jimzord12/ai-fire-detection-arduino-system/thesis/FUTURE_PLANS_IDEAS.md

For Future PLans:

- Make the current system more robust by allowing it to work even when a sensor fails (e.g., if the flame sensor is blocked or malfunctions, the system should still be able to detect fire using smoke and temperature data).
- Integrate additional sensors, such as a moving camera.
- Attach it to a Drone for aerial fire detection in forests.
- Describe more known Neron netowrk architectures and compare their performance on this task.
