jimzord12/ai-fire-detection-arduino-system/thesis/typst/assets/figures/IMAGE_DESCRIPTIONS.md

# Thesis Figure Inventory & Descriptions

This document identifies and describes all the figure assets for the AI Fire Detection Thesis.

## 1. Data Analysis Figures (`/data_analysis`)

| Figure Filename | Illustration Purpose | Recommended Figure Description | Recommended Placement |
| :--- | :--- | :--- | :--- |
| `class_distribution.png` | Shows the balance of the dataset collected for training. | **Figure X: Dataset Class Distribution.** A bar chart representing the number of samples for each of the three target classes: `fire`, `no_fire`, and `false_alarm`. The distribution confirms a well-balanced dataset, preventing model bias. | Chapter 8, Section 8.2 (Dataset Summary) |
| `sensor_correlation.png` | Illustrates the linear relationships between different sensors. | **Figure X: Sensor Correlation Matrix.** A heatmap showing the Pearson correlation coefficients between the six sensors. Low correlation between certain sensors (e.g., CO and Humidity) indicates they provide unique, non-redundant information for the fusion model. | Chapter 3, Section 3.4 (Feature Engineering) |
| `sensor_boxplots.png` | Visualizes the range and signature of each sensor across the three classes. | **Figure X: Sensor Signature Analysis by Class.** Boxplots showing the median, quartiles, and outliers for each sensor across the three classes. This highlights the distinct chemical and thermal signatures of each scenario, such as higher VOC/Smoke in false alarms versus higher CO in real fires. | Chapter 8, Section 8.4 (Ablation Study) |
| `confusion_matrix.png` | Shows the classification performance of the model on the test set. | **Figure X: Model Confusion Matrix.** A matrix visualizing the predicted vs. actual class labels. The 100% accuracy in this controlled environment demonstrates the mathematical separability of the fire and false alarm classes. | Chapter 8, Section 8.3 (Training and Validation Metrics) |
| `feature_importance.png` | Ranks the contribution of each sensor to the final ML decision. | **Figure X: Feature Importance Ranking.** A bar chart showing the relative importance of each sensor in the classification process. Smoke and VOC are identified as the most significant contributors (~50% combined), while Humidity provides the least unique information. | Chapter 8, Section 8.4 (Ablation Study) |

## 2. Edge Impulse Platform Figures (`/edge-impulse`)

| Figure Filename | Illustration Purpose | Recommended Figure Description | Recommended Placement |
| :--- | :--- | :--- | :--- |
| `001-platform-data-acquisition.png` | Shows the data ingestion interface for raw sensor logs. | **Figure X: Edge Impulse Data Acquisition Interface.** A screenshot of the platform's data ingestion page, showing the raw time-series data from the multi-sensor array after being uploaded from the Arduino. | Chapter 7, Section 7.1 (Edge Impulse Project Setup) |
| `002-platform-create-impulse.png` | Illustrates the TinyML pipeline (DSP + Learning blocks). | **Figure X: Impulse Design Architecture.** The Edge Impulse "Create Impulse" screen, showing the configuration of the time-series data block, the Spectral Analysis DSP block, and the Neural Network Classifier. | Chapter 7, Section 7.2 (Impulse Design and DSP Blocks) |
| `003-platfotm-spectral-features-error.png` | Documents troubleshooting during the DSP configuration phase. | **Figure X: Spectral Feature Configuration Error.** A screenshot illustrating common errors during DSP block setup, used to discuss the importance of correct window size and FFT parameters for sensor fusion. | Chapter 7, Section 7.2 (Impulse Design and DSP Blocks) |
| `004-platfotm-spectral-features.png` | Shows the successful configuration of the Spectral Analysis block. | **Figure X: Spectral Analysis DSP Configuration.** The final settings for the spectral features, including window length and frequency-domain processing used to extract fire-relevant signatures. | Chapter 7, Section 7.2 (Impulse Design and DSP Blocks) |
| `005-platform-feature-explorer.png` | Visualizes the clustering of features in a 3D explorer. | **Figure X: 3D Feature Explorer Visualization.** A plot showing how the three classes (fire, no_fire, false_alarm) cluster in the high-dimensional feature space, providing a visual proof of class separability. | Chapter 7, Section 7.2 (Impulse Design and DSP Blocks) |
| `006-platform-classifier.png` | Shows the Neural Network training parameters and architecture. | **Figure X: Classifier Training Configuration.** The training interface in Edge Impulse, detailing the neural network topology, learning rate, and training cycles (epochs) used for the fire detection model. | Chapter 7, Section 7.3 (Model Architecture and Training) |
| `007-platform-model-testing.png` | Illustrates the validation of the model on unseen test data. | **Figure X: Live Model Testing and Validation.** A screenshot of the model testing results within the Edge Impulse platform, showing the classification accuracy on the hold-out test dataset. | Chapter 7, Section 7.3 (Model Architecture and Training) |
| `008-platform-deployment-success-msg.png`  | Confirms the successful compilation of the C++ library. | **Figure X: Model Compilation and Build Success.** The notification screen confirming the successful generation of the optimized C++ library for deployment on the Arduino UNO R4. | Chapter 7, Section 7.7 (Quantization Strategy) |
| `009-platform-deployment.png` | Shows the deployment options for the Arduino UNO R4. | **Figure X: Deployment Target Selection.** The deployment page showing the various export options, specifically the selection of the Arduino library for integration into the custom firmware. | Chapter 7, Section 7.4 (Arduino Firmware Development) |

## 3. Data Collection Evidence (`/data-collection-evidence`)

| Figure Filename | Illustration Purpose | Recommended Figure Description | Recommended Placement |
| :--- | :--- | :--- | :--- |
| `002-flame-source-only-indoors.jpg` | Shows the sensor node capturing indoor flame data.  | **Figure X: Indoor Flame Data Collection.** The sensor node capturing infrared signatures from a cluster of candles, representing the "Fire" class baseline. | Chapter 6, Section 6.4 (Fire Class) |
| `003-flame-smoke-indoors.jpg` | Captures the combination of flame and smoke. | **Figure X: Combined Flame and Smoke Capture.** The sensor node capturing data from both candles and a smoldering incense bowl, illustrating a complex fire scenario. | Chapter 6, Section 6.4 (Fire Class) |
| `004-flame-smoke-outdoors.jpg` | Documents environmental variance during collection. | **Figure X: Outdoor Night Data Collection.** The sensor node capturing fire signatures in an outdoor environment to account for ambient noise and variance. | Chapter 6, Section 6.5 (Environmental Variance) |
| `005-smoke-only-indoors.jpg` | Represents smoldering/non-flaming fire data. | **Figure X: Smoldering Fire Simulation.** The sensor node capturing particulate and VOC signatures from a smoldering source without visible flame (Scenario A3). | Chapter 6, Section 6.4 (Fire Class) |
| `006-cooking-using-pan-indoors.jpg` | Documents the "False Alarm" class (Cooking). | **Figure X: Cooking Fume False Alarm Scenario.** The sensor node capturing signatures from a frying pan, documenting the high VOC/Smoke but low CO profile (Scenario C1). | Chapter 6, Section 6.4 (False-Alarm Class) |
| `007-boiling-water-indoors-pt1.jpg` | Documents the "False Alarm" class (Steam). | **Figure X: Steam and Humidity False Alarm Capture.** The sensor node positioned over boiling water to capture high humidity spikes without combustion products (Scenario C2). | Chapter 6, Section 6.4 (False-Alarm Class) |
| `008-boiling-water-indoors-pt2.jpg` | Shows an alternative sensor placement for steam. | **Figure X: Ambient Steam Collection.** The sensor node positioned in a kitchen setting during water boiling to capture dispersed steam signatures. | Chapter 6, Section 6.4 (False-Alarm Class) |
