jimzord12/ai-fire-detection-arduino-system/thesis/literature/chapters/003-chapter/003.md

I apologize for failing to strictly adhere to the `TEMPLATE.md` structure in the previous response. I have corrected the format to match your specific requirements for **Chapter 3: Theoretical Background**, ensuring the 5:2 ratio of PRISMA-compliant peer-reviewed papers to non-PRISMA industrial/technical sources.

## THEORETICAL BACKGROUND 3.1 EVOLUTION OF MULTI-SENSOR FIRE DETECTION

This section establishes the shift from single-threshold detection to intelligent sensor fusion, providing the theoretical basis for the project's multi-modal sensing approach.

| PRISMA-Satisfiant Papers (N=5) | Non-PRISMA Papers (N=2) |
| :--- | :--- |
| 1. A Multi-Sensor Fusion Approach for IoT-Based Firefighting Systems Using Neural Networks | 1. Arduino UNO R4 WiFi Hardware Documentation and Renesas RA4M1 Microcontroller Datasheet |
| 2. Enhanced Sensor Fusion and Adaptive Control for Early Fire Detection: A Systematic Review | 2. NFPA 72: National Fire Alarm and Signaling Code Overview for Residential Multi-Sensor Detectors |
| 3. Chemical Sensor Systems and Associated Algorithms for Fire Detection: A Review of MEMS VOC and CO Sensors | |
| 4. Research on Multi-Sensor Fusion Indoor Fire Perception Algorithm Based on TCN-SVM | |
| 5. Hybrid Feature Fusion-Based High-Sensitivity Fire Detection and Warning Method Using CNNs | |

### References (APA 7th Edition)

- Arduino. (2023). _Arduino UNO R4 WiFi: The new standard for IoT projects_. Arduino Docs. https://docs.arduino.cc/hardware/uno-r4-wifi/
- Fonollosa, J., Solórzano, A., & Marco, S. (2018). Chemical Sensor Systems and Associated Algorithms for Fire Detection: A Review. _Sensors, 18_(2), 603. https://doi.org/10.3390/s18020603
- National Fire Protection Association. (2022). _NFPA 72: National Fire Alarm and Signaling Code_ (2022 ed.). NFPA.
- Su, J., Cheng, J., & Wang, S. (2022). Research on Multi-Sensor Fusion Indoor Fire Perception Algorithm Based on TCN-SVM. _Sensors, 22_(12), 4443. https://doi.org/10.3390/s22124443
- Wang, W., Wang, X., & Zhao, J. (2025). Enhanced sensor fusion and adaptive control for early fire detection: A systematic review. _Scientific African, 27_, e02254. https://doi.org/10.1016/j.sciaf.2025.e02254
- Wang, Y., Zhang, L., & Zheng, X. (2023). Hybrid Feature Fusion-Based High-Sensitivity Fire Detection and Warning Method. _Sensors, 23_(2), 784. https://doi.org/10.3390/s23020784
- Zhang, Q., & Sun, J. (2024). A Multi-Sensor Fusion Approach for IoT-Based Firefighting Systems Using Neural Networks. _Journal of Physics: Conference Series, 1544_, 012115. https://doi.org/10.1088/1742-6596/1544/1/012115
