jimzord12/ai-fire-detection-arduino-system/thesis/typst/chapters/04_introduction/sections/4_2_objectives/glossary.md

**Asymmetric Multi-Processing**: A hardware architecture where different processor cores handle distinct tasks, such as separating high-speed inference from low-priority communication tasks.
**Autonomous Sensing Node**: A standalone edge device that performs data acquisition, processing, and decision-making locally without requiring a continuous cloud connection.
**Inference Latency**: The total time elapsed between the presentation of input data to a machine learning model and the generation of a classification result.
**TinyML**: A branch of machine learning dedicated to the design and deployment of optimized models on ultra-low-power microcontrollers.
