jimzord12/ai-fire-detection-arduino-system/thesis/typst/chapters/05_project_scope/sections/5_2_problem_statement/glossary.md

**Edge AI**: The practice of processing artificial intelligence algorithms locally on a hardware device, rather than on a remote cloud server.
**MEMS (Micro-Electro-Mechanical Systems)**: Technology of very small devices, often used for high-sensitivity gas and pressure sensors on a single chip.
**TinyML**: A field of machine learning focused on developing models that can run on low-power, resource-constrained microcontrollers.
**Sensor Fusion**: The process of combining data from multiple sensors to produce information that is more accurate or complete than that provided by individual sources.
