jimzord12/ai-fire-detection-arduino-system/thesis/typst/chapters/05_project_scope/sections/5_3_research_questions/glossary.md

**Inference Latency**: The time required for a deployed machine learning model to process an input and generate a classification output on the edge device.
**Quantization**: A model optimization technique that converts high-precision weights (e.g., 32-bit float) to lower-precision formats (e.g., 8-bit integer) to reduce memory usage and increase inference speed.
**Three-Class Classification**: A supervised learning approach that categorizes data into three distinct labels—in this context, identifying fire, normal background, or non-fire nuisance events.
**TinyML**: A field of machine learning focused on deploying optimized models on low-power, resource-constrained microcontrollers at the hardware edge.
