jimzord12/ai-fire-detection-arduino-system/thesis/typst/chapters/08_conclusions_future_work/sections/8_2_discussion/sections/9_1_interpretation_of_class_separability/content_no_glossary_ieee.md

# Interpretation of Class Separability

## 9.1.1 The "Truth Sensor" and "Thermal Anomaly" Analysis

The core of class separability within this multi-sensor system is illuminated by two critical observations from the data analysis: the identification of a "CO Truth Sensor" and the "Heat Paradox" or "Thermal Anomaly." These findings collectively explain why the fusion model achieves perfect classification on the validation dataset.

### The CO "Truth Sensor" for Combustion Verification

*   **Distinct Signatures**: While `smoke` and `voc` sensors exhibit elevated readings for both "fire" and "false_alarm" conditions (e.g., from cooking fumes or aerosol sprays), the CO sensor shows a profound divergence. "Fire" events average approximately 494 units of CO, whereas "false_alarm" events average a significantly lower ~123 units (from `analysis_results.json`, `sensor_stats`).
*   **Fundamental Differentiator**: This stark difference in CO levels is attributed to its nature as a product of incomplete combustion. False alarms, such as cooking or spraying aerosols, may produce particulates (smoke) and volatile organic compounds (VOCs), but they do not typically generate significant quantities of CO. Conversely, any genuine fire, whether flaming or smoldering, will produce CO.
*   **Class Separability**: This distinct characteristic of the CO sensor provides a robust mechanism for the machine learning model to separate "fire" from "false_alarm" classes, even when other sensor modalities show overlapping ranges. If a high smoke or VOC reading is observed in conjunction with low CO, the system can confidently infer a false alarm, contributing significantly to the model's high precision and recall for the "false_alarm" class.

### The "Heat Paradox" and the Limits of Thermal-Only Detection

*   **Counterintuitive Finding**: Counterintuitively, the average temperature recorded during "false_alarm" scenarios (specifically cooking and steam) was higher (34.9°C) than during active "fire" events (25.7°C) in the early stages of data collection.
*   **Implications for Single-Sensor Systems**: This finding has profound implications for systems relying solely on thermal detection. A simple heat detector, set to a threshold based on fire temperatures, would be highly susceptible to false alarms from cooking or steam. Conversely, setting the threshold too high to avoid these false alarms would delay the detection of actual fires, especially in their incipient stages.
*   **Validation of Fusion**: The "Heat Paradox" underscores why multi-sensor fusion is critical. By combining temperature data with the outputs of other sensors, the system can contextualize the thermal anomaly. A high temperature reading, when accompanied by low CO levels and the absence of a strong flame signal, is correctly interpreted as a false alarm. This prevents misclassifications that would be inevitable with a thermal-only detection approach, demonstrating the power of a holistic sensor perspective for accurate class separability.

The combined evidence from the CO "Truth Sensor" and the "Heat Paradox" demonstrates that while individual sensors can be misleading, their intelligent fusion provides a rich and separable feature space, allowing the TinyML model to achieve highly accurate and reliable distinction between fire, no-fire, and false alarm events.

### References
