jimzord12/ai-fire-detection-arduino-system/thesis/typst/chapters/08_conclusions_future_work/sections/8_2_discussion/sections/9_2_strengths_of_the_autonomous_node_approach/content_no_glossary_ieee.md

# Strengths of the "Autonomous Node" Approach

The design and implementation of the AI Fire Detection Arduino System as an "Autonomous Sensing Node" represents a significant departure from traditional centralized or less intelligent detection paradigms. This approach embodies several key strengths that contribute to its enhanced reliability, efficiency, and suitability for modern safety applications. These strengths are derived from the system's architecture, its intelligent edge processing capabilities, and its integrated operational logic, drawing upon various aspects of the project's design and codebase features.

## 9.2.1 Edge Intelligence and Responsiveness

One of the foremost strengths of the autonomous node approach is its commitment to **edge intelligence**. By deploying the TinyML model directly onto the Arduino UNO R4 WiFi (Renesas RA4M1 microcontroller), the system performs real-time inference at the source of data generation. This eliminates the latency associated with sending raw sensor data to a cloud server for processing, ensuring a rapid response to potential fire events. The system's ability to operate independently, making immediate decisions on-device, is critical for life-critical applications where every millisecond counts (On-Device Performance Metrics, Section 8.6). This architecture minimizes network dependency, enhancing system resilience even during connectivity disruptions.

## 9.2.2 Robust False Alarm Mitigation

The core innovation of this project, the **three-class classification** (fire/no_fire/false_alarm), is a direct strength of the autonomous node approach. Unlike binary systems, the node explicitly learns and differentiates the unique multi-sensor signatures of common nuisance events (e.g., cooking fumes, steam, aerosol sprays) from both true fires and ambient conditions. This significantly reduces false positives, a perennial problem in fire detection that leads to complacency and economic losses (False Alarm Mitigation and Research Synthesis, Section 2.4). The integration of ML probabilities with **heuristic post-processing and hybrid triggering logic** (Heuristic Post-Processing and Hybrid Triggering Logic, Section 7.5), which includes physical confirmation from raw sensors and temporal debouncing, further fortifies the system against transient false alarms, building trust and reliability.

## 9.2.3 Multi-Sensor Fusion for Enhanced Accuracy

The autonomous node integrates data from five distinct sensor modalities (Smoke, VOC, CO, Flame, Temperature/Humidity). This **multi-sensor fusion** provides a comprehensive understanding of the environment, overcoming the inherent ambiguities of single-sensor approaches. As demonstrated by the ablation study (Ablation Study, Section 8.4), individual sensors can be misleading (e.g., the "Heat Paradox" where false alarms are hotter than early fires). However, the fused data allows the TinyML model to identify subtle yet critical patterns, such as the "CO Truth Sensor" for combustion verification, leading to 100% classification accuracy on the validation set. This synergy ensures a more accurate and reliable detection capability.

## 9.2.4 Scalability and Deployability

The self-contained nature of each autonomous node makes the system inherently **scalable**. Each unit operates independently, requiring minimal external infrastructure beyond power and optional network connectivity (e.g., via MQTT for telemetry). This modularity allows for flexible deployment in various environments—from individual rooms to large industrial complexes—by simply adding more nodes. The use of low-cost, off-the-shelf components like the Arduino UNO R4 WiFi and DFRobot sensors contributes to its cost-effectiveness, making widespread deployment feasible. The ESP32-S3 co-processor further enables seamless **MQTT telemetry** (Connectivity and Location Awareness, Section 5.4) for centralized monitoring without compromising local decision-making autonomy.

## 9.2.5 Operational Robustness and Self-Awareness

The firmware incorporates **system diagnostics** (Arduino Firmware Development, Section 7.4), allowing the node to perform self-tests upon startup to verify the operational status of all connected sensors. In the event of a sensor fault, the system can enter a fault state and signal a visual alarm pattern, ensuring that operational integrity is maintained or clearly communicated. This self-awareness contributes significantly to the system's overall robustness, providing confidence in its operational status and reducing maintenance overhead.

### References
