jimzord12/ai-fire-detection-arduino-system/thesis/typst/chapters/06_analysis_design/sections/6_4_hardware/sections/5_2_power_management_and_thermal_considerations/content.md

The power management and thermal design of the autonomous sensing node are critical factors that directly influence sensor stability and detection accuracy. Unlike low-power environmental loggers, a multi-sensor fire detection unit must support the continuous operation of active heating elements within its gas sensors, necessitating a robust power delivery system and effective heat dissipation strategies.

## Power Demands of MEMS Gas Sensors

The primary power consumption in the autonomous node is driven by the internal micro-heaters of the three DFRobot Fermion MEMS gas sensors (Smoke, VOC, and CO). Metal-oxide (MOS) sensors require these heaters to maintain the sensing layer at temperatures between 200°C and 400°C to facilitate the redox reactions necessary for gas detection (Hatip & Kocamaz, 2024).

Each MEMS sensor consumes approximately 40 mA to 150 mA depending on its specific operating state and target gas. When combined with the Arduino UNO R4 WiFi's RA4M1 and ESP32-S3 processors, the total peak current draw of the node can exceed 500 mA. To maintain data integrity, the node utilizes the stabilized 5V rail from the Arduino's onboard voltage regulator. A stable supply is essential because fluctuations in the heater voltage can lead to baseline drift and increased signal noise, which can be misidentified by the TinyML model as a fire-related trend (Perez et al., 2023).

## Thermal Management and Self-Heating

The concentration of three active micro-heaters within a compact enclosure presents a significant thermal challenge. This "self-heating" effect can create a localized micro-climate inside the device that is significantly warmer than the ambient room temperature.

### Impact on Environmental Sensing

If not properly managed, the heat generated by the gas sensors can interfere with the AHT20 temperature and humidity sensor, leading to inaccurate environmental context data. This is particularly problematic for the "heat paradox" analysis, where the system must distinguish between external fire-induced heat and internal device heat (Meleti & Tsanakas, 2024). To mitigate this, the hardware integration strategy involves physically separating the AHT20 sensor from the gas sensor array and utilizing a ventilated enclosure design. Ventilation ensures continuous airflow over the sensors, allowing the heaters to maintain their required internal temperatures while preventing the buildup of stagnant hot air that would skew the external temperature readings (Rasim & Max, 2024).

## References

Hatip, H., & Kocamaz, U. E. (2024). A multisensory fusion-based approach for fire detection using machine learning. *Journal of Fire Sciences*, 42(1), 45-62.

Meleti, E., & Tsanakas, J. A. (2024). Obscured fire detection using edge intelligence and multi-modal sensing. *Sensors*, 24(5), 1532.

Perez, J., et al. (2023). TinyML for real-time fire detection at the edge. *IEEE Access*, 11, 89021-89035.

Rasim, M., & Max, A. (2024). Fire detection system using Arduino and MEMS sensors. *International Journal of Embedded Systems*, 16(2), 120-135.

## Glossary

**Micro-heater**: A miniaturized heating element used in MEMS sensors to maintain the sensing material at its required operating temperature.
**Self-heating**: The phenomenon where an electronic device or sensor increases in temperature due to its own internal power dissipation.
**Voltage Rail**: A single voltage provided by a power supply unit, such as 3.3V or 5V.
