jimzord12/ai-fire-detection-arduino-system/thesis/typst/chapters/06_analysis_design/sections/6_4_hardware/sections/5_2_power_management_and_thermal_considerations/content_ieee_no_glossary.md

The power management and thermal design of the autonomous sensing node are critical factors that directly influence sensor stability and detection accuracy. Unlike low-power environmental loggers, a multi-sensor fire detection unit must support the continuous operation of active heating elements within its gas sensors, necessitating a robust power delivery system and effective heat dissipation strategies.

## Power Demands of MEMS Gas Sensors

The primary power consumption in the autonomous node is driven by the internal micro-heaters of the three DFRobot Fermion MEMS gas sensors (Smoke, VOC, and CO). Metal-oxide (MOS) sensors require these heaters to maintain the sensing layer at high temperatures to facilitate the redox reactions necessary for gas detection @hatip2024multisensory.

Each MEMS sensor consumes significant current depending on its specific operating state and target gas. When combined with the Arduino UNO R4 WiFi's processors, the total peak current draw of the node can exceed 500 mA. To maintain data integrity, the node utilizes the stabilized 5V rail from the Arduino's onboard voltage regulator. A stable supply is essential because fluctuations in the heater voltage can lead to baseline drift and increased signal noise, which can be misidentified by the TinyML model as a fire-related trend @perez2023tinyml.

## Thermal Management and Self-Heating

The concentration of three active micro-heaters within a compact enclosure presents a significant thermal challenge. This "self-heating" effect can create a localized micro-climate inside the device that is warmer than the ambient room temperature.

### Impact on Environmental Sensing

If not properly managed, the heat generated by the gas sensors can interfere with the environmental sensor, leading to inaccurate context data. This is particularly problematic for the "heat paradox" analysis, where the system must distinguish between external fire-induced heat and internal device heat @meleti2024obscured. To mitigate this, the hardware integration strategy involves physically separating the environmental sensor from the gas sensor array and utilizing a ventilated enclosure design. Ventilation ensures continuous airflow over the sensors, allowing the heaters to maintain their required internal temperatures while preventing the buildup of stagnant hot air that would skew the external temperature readings @rasim2024fire.
