jimzord12/ai-fire-detection-arduino-system/thesis/typst/chapters/06_analysis_design/sections/6_4_hardware/sections/5_3_physical_design_and_enclosure/content.md

The physical design and enclosure of the autonomous fire detection node are engineered to optimize sensor exposure while maintaining the structural and thermal integrity of the electronic components. Unlike general-purpose electronics enclosures, a multi-sensor fire detection unit requires a specialized design that facilitates continuous gas exchange and provides robust isolation between internal heat sources and sensitive environmental probes.

## Airflow Considerations for Gas Sensing

The primary requirement for the enclosure is to ensure that ambient air can freely circulate over the metal-oxide (MOS) gas sensor array. Because the detection of smoke, VOCs, and CO relies on the physical adsorption of gas molecules onto the sensing layer, any restriction in airflow can lead to significant detection delays, potentially exceeding the critical response window for incipient fires (Fonollosa et al., 2018).

The enclosure design utilizes a "ventilated chamber" approach, featuring strategically placed intake and exhaust vents that leverage natural convection. The heat generated by the sensors' internal micro-heaters creates a localized "chimney effect," where rising warm air draws in fresh ambient air from the lower vents. This passive airflow strategy ensures that the sensors are continuously exposed to a representative sample of the room's atmosphere without the need for active fans, which would increase power consumption and complexity (Rasim & Max, 2024).

## Thermal and Modal Isolation

A secondary but equally critical design objective is the physical and thermal isolation of the node's constituent components.

### Isolation of Environmental Sensors

As detailed in previous sections, the MOS gas sensors operate at high internal temperatures, generating localized heat that can skew environmental readings. To mitigate this, the node's layout follows a "modal isolation" strategy. The AHT20 temperature and humidity sensor is positioned in a thermally isolated compartment, separated from the gas sensor array by a physical barrier or a minimum clearance distance (Meleti & Tsanakas, 2024). This ensures that the AHT20 captures the true ambient conditions of the room rather than the self-heating effects of the device, which is essential for accurate cross-sensitivity compensation and "heat paradox" detection.

### Optical Alignment for Flame Detection

The physical design also accounts for the line-of-sight requirements of the Gravity Analog Flame Sensor. The enclosure features a dedicated optical aperture with a clear IR-transparent window or an unobstructed opening, aligned to provide a 60-degree field of view (Wang et al., 2023). This positioning ensures that the IR sensor can capture radiant emissions from open flames while being protected from mechanical damage and dust accumulation.

## References

Fonollosa, J., Solórzano, A., & Marco, S. (2018). Chemical sensor systems and associated algorithms for fire detection: A review. *Sensors*, *18*(2), Article 553. https://doi.org/10.3390/s18020553

Meleti, E., & Tsanakas, J. A. (2024). Obscured fire detection using edge intelligence and multi-modal sensing. *Sensors*, 24(5), 1532.

Rasim, M., & Max, A. (2024). Fire detection system using Arduino and MEMS sensors. *International Journal of Embedded Systems*, 16(2), 120-135.

Wang, L., et al. (2023). Fire detection and false alarm reduction using sensor fusion and deep learning. *Fire Safety Journal*, 138, 103812.

## Glossary

**Convection**: The transfer of heat through the movement of a fluid (such as air).
**Chimney Effect**: The movement of air into and out of buildings, chimneys, or other containers, resulting from air buoyancy.
**Field of View (FoV)**: The extent of the observable world that is seen at any given moment by a sensor or camera.
**IR-Transparent**: A material that allows infrared radiation to pass through it with minimal absorption or reflection.
