jimzord12/ai-fire-detection-arduino-system/thesis/typst/chapters/08_conclusions_future_work/sections/8_2_discussion/sections/9_4_deployment_scenarios_and_scalability/content_ieee_no_glossary.md

This section examines the practical pathway from the laboratory prototype to real-world installation, addressing the economic viability of individual nodes, the architectural principles governing multi-node scale-out, and the regulatory constraints that any deployed fire safety system must navigate.

## Cost Analysis per Node

The bill of materials (BOM) for a single Autonomous Sensing Node is determined by the Arduino UNO R4 WiFi platform and its five DFRobot MEMS sensor peripherals. The Arduino UNO R4 WiFi retails at approximately USD 27.50 @arduino2023. The five sensors contribute an estimated additional USD 40–60 in MEMS module cost at single-unit pricing. Passive prototyping components add negligible cost, yielding a per-node BOM in the range of USD 70–90 at prototype quantity. This figure compares favourably with commercial addressable fire detector points, which typically carry a list price of USD 80–200 exclusive of installation labour, panel, and wiring infrastructure.

The Renesas RA4M1 operates at 48 MHz with 256 kB Flash and 32 kB RAM, while the ESP32-S3 co-processor provides WiFi throughput sufficient for continuous MQTT telemetry. Sensor data are sampled at 10 Hz across five channels; Edge Impulse DSP blocks compress this representation before inference, and quantisation reduces on-device memory requirements by a factor of four with minimal accuracy loss. The combined inference target of < 100 ms per prediction keeps per-node duty-cycle overhead negligible, supporting continuous 24/7 monitoring. Feature importance analysis indicates that the humidity channel contributes only a small fraction of classifier decision weight, suggesting that this modality could be omitted in a cost-optimised node variant.

The principal driver of deployment economics is not per-node BOM but installation density. Prior studies on wireless sensor deployments report reliable coverage in commercial building environments. For a representative 3,000 m2 structure, the hardware cost remains competitive with the expectation of significant unit-cost reduction under volume procurement.

## Mesh Network Topology for Multi-Node Systems

A single Autonomous Sensing Node operating in isolation provides point-coverage fire detection; scalable building-wide protection requires multiple nodes to be integrated into a coherent monitoring fabric. The radio co-processor natives supports both WiFi and Bluetooth, enabling two complementary topologies: a star topology in which each unit publishes MQTT telemetry directly to a broker, and a hybrid mesh topology using ESP-NOW as the intra-node transport. The latter pattern decouples sensing from connectivity, substantially reducing channel contention in dense deployments.

Location awareness across a multi-node installation is implemented as Static Location Tagging: each node's MQTT payload carries a hardcoded Zone_ID field, providing room-level spatial resolution without GPS hardware. This approach is well suited to stationary autonomous nodes, where physical positions are fixed at installation time. Prior work on fault-tolerant IoT fire detection architectures has demonstrated that an ad-hoc wireless network of multi-sensor nodes can be deployed throughout a building with each node acting as an independent sensing and relay unit, improving system resilience @arshad2022fault.

The Asymmetric Multi-Processing architecture is directly applicable to multi-node mesh deployment: the RA4M1 Brain executes TinyML inference and manages sensor acquisition, while the ESP32-S3 Radio handles wireless telemetry asynchronously. This separation ensures that transient WiFi congestion does not interrupt local inference, preserving the reflexive detection capability of the node even during network partitions.

## Certification Challenges (UL/CE)

The pathway from a research prototype to a commercially deployable fire safety product is governed by stringent regulatory frameworks. In the European market, multi-sensor fire detectors must comply with the EN 54 series of standards, which mandate third-party conformity assessment. North American market equivalents are imposed by UL standards such as UL 268 for smoke detectors @srivastava2025intelligent.

The Autonomous Sensing Node as currently prototyped is explicitly a research-grade platform intended to demonstrate the feasibility of TinyML-based fire classification on commodity hardware. Achieving commercial certification would require: (a) migration to a custom PCB with appropriate conformal coating; (b) replacement of prototyping interconnects with connector-locked interfaces; (c) formalised validation against standard test fires; and (d) EMC compliance testing. These steps constitute a well-defined roadmap for a commercial variant.

Research highlights that IoT-based air quality and gas monitoring networks show strong functional alignment with fire detection requirements yet are explicitly positioned as supplementary systems rather than primary replacements, precisely because they lack the regulatory approval infrastructure @pfeifer2025contributions. The Autonomous Sensing Node is best characterised as a complementary edge intelligence layer capable of operating alongside certified infrastructure.
