jimzord12/ai-fire-detection-arduino-system/thesis/typst/chapters/08_conclusions_future_work/sections/8_2_discussion/sections/9_4_deployment_scenarios_and_scalability/glossary.md

**BOM (Bill of Materials)**: An itemised list of all hardware components and their associated unit costs required to build one instance of the system.
**ESP-NOW**: A connectionless, peer-to-peer WiFi communication protocol developed by Espressif for low-latency data transfer between ESP32 devices.
**FDAS (Fire Detection and Alarm System)**: A complete system comprising detectors, control panels, and notification appliances, assessed as a whole under safety standards.
**Notified Body**: A conformity assessment organisation designated by an EU member state to evaluate products against harmonised European standards.
**Static Location Tagging**: Assignment of a fixed Zone_ID string to each node's MQTT payload at firmware configuration time.
**UL (Underwriters Laboratories)**: A US-based safety certification organisation.
