jimzord12/ai-fire-detection-arduino-system/docs/notes/scenario-c2.md

At the end of the C2 scenario, I removed the sensors from being directly exposed to steam. As I thought that they might get damaged if exposed for too long.
