jimzord12/ai-fire-detection-arduino-system/docs/notes/scenario-a3.md

Noticed that the CO sensor soldering was not very good and when moved, the readings fluctuated wildly. Sadly, I hd to move the board for each experiment thus the results are not very reliable.
