jimzord12/ai-fire-detection-arduino-system/thesis/typst/chapters/05_project_scope/sections/5_2_problem_statement/research/001_research.md

# 1.2 Problem Statement

## 1.2.1 Background and Problem Statement

The prevalence of false alarms in traditional fire detection systems remains a critical challenge for emergency response efficiency and public safety. Statistics from the United Kingdom Home Office indicate that approximately 98% of automatic fire alarm (AFA) incidents confirmed between 2020 and 2021 were false alarms, with 90% of these attributed to faulty or improperly maintained apparatus.[1] Similar trends are observed in high-density urban infrastructure; for instance, the Taipei Metro reported a 94% false alarm rate between 2019 and 2024, where only 28 of 484 activations involved actual fire events.[2] These frequent unwanted alarms lead to significant economic losses due to interrupted operations, the exhaustion of fire service resources, and a phenomenon known as "alarm fatigue," where occupants begin to ignore signals, thereby increasing the risk of casualties during real fire events.[3]

The high susceptibility to false positives stems largely from the limitations of traditional single-sensor detectors, which typically rely on a single physical property such as ionization or light scattering. These devices struggle to differentiate between combustion-derived smoke and non-fire aerosols like steam, dust, or cooking fumes.[4] Single-sensor architectures are fundamentally limited in their ability to classify complex environmental patterns, as smoke particles vary significantly in composition and density.[4] Furthermore, traditional rule-based algorithms often lack the flexibility to adapt to varying ambient conditions, resulting in either high false alarm rates or delayed response times.[5]

To address these vulnerabilities, there is a growing need for intelligent multi-sensor fusion systems deployed at the network edge. Recent advancements in Tiny Machine Learning (TinyML) enable the execution of complex neural networks on resource-constrained microcontrollers, such as the ARM Cortex-M4.[6] By integrating heterogeneous data from gas, thermal, and optical sensors, these systems can identify cross-sensor correlations that are characteristic of true fire signatures.[3] However, a significant gap remains in developing low-power, cost-effective nodes that can provide three-class classification—distinguishing between "Fire," "No Fire," and specific "False Alarm" triggers—to minimize unnecessary emergency dispatches.[5]

## 1.2.2 Scope and Limitations

This research focuses on the development and validation of a stationary "Autonomous Node" for indoor fire detection, utilizing an Arduino-based hardware platform. The system is designed to provide continuous 24/7 monitoring of specific indoor zones by fusing data from a multi-modal sensor array, including Micro-Electro-Mechanical Systems (MEMS) smoke, volatile organic compound (VOC), and carbon monoxide (CO) sensors, alongside infrared (IR) flame detection and environmental temperature/humidity sensing.[7] Unlike mobile robotic platforms or Unmanned Aerial Systems (UAS) used for forest fire patrol, the stationary node is optimized for fixed installation in residential or commercial environments where high-fidelity, localized monitoring is required.[8]

The scope of this project is strictly limited to indoor fire detection scenarios. The sensor suite is selected to detect common indoor fire signatures; however, the detection range is limited by the physical sensitivity of the MEMS gas sensors and the line-of-sight requirements of the IR flame sensor.[5] While the system leverages an Arduino UNO R4 WiFi for processing and communication, the research emphasizes TinyML model efficiency, specifically targeting a 32-bit Cortex-M4 architecture with limited SRAM.[6] The system does not address active fire suppression or complex multi-node mesh networking, focusing instead on the accuracy of the individual node’s classification capabilities. Furthermore, while the node can operate on battery power, long-term deployment strategies for energy harvesting or extreme low-power sleep modes are considered secondary to the primary objective of false alarm reduction through sensor fusion.

### References

- [1] International Fire and Safety Journal, "Report reveals 90% of false fire alarms are caused by faulty apparatus," Oct. 10, 2022. [Online]. Available: https://internationalfireandsafetyjournal.com/report-reveals-90-of-false-fire-alarms-are-caused-by-faulty-apparatus/
- [2] "False-alarm susceptibility of spot-type smoke detectors under environmental interference," _Fire Safety Journal_, vol. 150, p. 104285, 2025, doi: 10.1016/j.firesaf.2025.104285. [Online]. Available: https://doi.org/10.1016/j.firesaf.2025.104285
- [3] Z. Wang, J. Zhang, G. Liu, H. Yuan, and L. Huang, "A fire alarm judgment method using multiple smoke alarms based on Bayesian estimation," _Fire Safety Journal_, vol. 137, p. 103767, 2023, doi: 10.1016/j.firesaf.2023.103767. [Online]. Available: https://doi.org/10.1016/j.firesaf.2023.103767
- [4] A. Hatip and K. Zayood, "Multisensory fusion approaches for accurate smoke detection in smart environments," _Journal of International Wireless and Ad Hoc Communication_, vol. 8, no. 2, pp. 23–31, 2024. [Online]. Available: https://www.americaspg.com/article/pdf/2633
- [5] Edge Impulse, "Fire detection using sensor fusion and TinyML," Feb. 11, 2026. [Online]. Available: https://docs.edgeimpulse.com/projects/expert-network/fire-detection-sensor-fusion-arduino-nano-33
- [6] J. Moosmann, M. Giordano, C. Vogt, and M. Magno, "TinyissimoYOLO: A quantized, low-memory footprint, TinyML object detection network for low power microcontrollers," arXiv:2306.00001, 2024. [Online]. Available: https://arxiv.org/abs/2306.00001
- [7] Rasimmax, "Fire detection system using Arduino Nano 33 BLE and TinyML | Edge Impulse | PHP integration," YouTube video, Jun. 9, 2024. [Online]. Available: https://www.youtube.com/watch?v=FdQLSpr0g-E
- [8] U. Meleti and A. Razi, "Obscured wildfire flame detection by temporal analysis of smoke patterns captured by unmanned aerial systems," arXiv:2307.00104v2, 2024. [Online]. Available: https://arxiv.org/abs/2307.00104
