jimzord12/ai-fire-detection-arduino-system/thesis/typst/chapters/05_project_scope/sections/5_3_research_questions/research/002_research.md

State-of-the-art intelligent fire detection systems establish a benchmark for "real-time" performance through industry response standards (30–90 seconds) and TinyML inference speeds on microcontrollers (3.47–14.98 ms). Modern research indicates that multi-sensor fusion (Smoke, CO, VOC) achieves detection accuracies exceeding 96% while significantly reducing the false alarm rates (FAR) associated with single-sensor systems. [anaparts](https://www.anaparts.eu/2025/08/06/what-response-time-standards-apply-to-industrial-fire-detection/)

## Latency Benchmarks

Industry standards such as NFPA 72 and EN 54 define "real-time" response for conventional smoke detectors between 30 and 90 seconds, whereas specialized flame detectors must respond within 3–5 seconds. In academic research, TinyML models deployed on ARM Cortex-M4 processors (64 MHz) achieve inference latencies as low as 3.47 ms for 8-bit quantized neural networks. On the Arduino UNO R4 (48 MHz RA4M1), latency remains well within the "real-time" requirement for environmental monitoring, typically processing sensor frames in under 20 ms. [pmc.ncbi.nlm.nih](https://pmc.ncbi.nlm.nih.gov/articles/PMC12722349/)

## Sensor Fusion Efficacy

Multi-sensor systems (Smoke + CO + Temperature) demonstrate superior reliability over single-sensor units, which suffer from high false alarm rates (FAR) due to cooking fumes, dust, and water vapor. Studies show that while single-sensor smoke detectors can have a FAR as high as 99% in complex environments like aircraft cargo, fused systems achieve over 96% accuracy. [pmc.ncbi.nlm.nih](https://pmc.ncbi.nlm.nih.gov/articles/PMC9865716/)

- **Single-Sensor Accuracy**: Often ranges from 52% to 70% in normative test fires. [pmc.ncbi.nlm.nih](https://pmc.ncbi.nlm.nih.gov/articles/PMC10934981/)
- **Multi-Sensor Accuracy**: Reaches 96% or higher through hybrid feature fusion algorithms like PSO-LSSVM. [pmc.ncbi.nlm.nih](https://pmc.ncbi.nlm.nih.gov/articles/PMC9865716/)
- **Response Speed**: Fused systems trigger alarms faster than smoke-only detectors by analyzing the "rate of increase" in gas concentrations (CO/VOC) before smoke density reaches alarm thresholds. [bohrium](https://www.bohrium.com/paper-details/fire-detection-using-smoke-and-gas-sensors/812004415060836357-4116)

## Three-Class Classification

Research into three-class models (Fire, No-Fire, False Alarm) focuses on categorizing "nuisance" sources to eliminate false positives from non-fire events. Implementations using rate-of-increase algorithms for CO and CO2 have successfully ignored nuisance sources that previously triggered smoke-only alarms. Modern TinyML architectures for this task achieve classification rates of 68% to 96% depending on the training dataset's inclusion of specific false-alarm scenarios like polyurethane foam smoldering vs. alcohol flames. [bohrium](https://www.bohrium.com/paper-details/fire-detection-using-smoke-and-gas-sensors/812004415060836357-4116)

## Edge Deployment Feasibility

Deployment on the Arduino UNO R4 WiFi is constrained by its RA4M1 microcontroller, which offers 256 KB Flash and 32 KB SRAM. Quantized 8-bit neural networks for environmental sensing typically require between 286 KB and 536 KB of Flash for object detection, suggesting that simpler classification models for fire detection must be highly optimized to fit within the R4’s 256 KB limit. [docs.arduino](https://docs.arduino.cc/hardware/uno-r4-wifi)

- **RAM Footprint**: Most TinyML classification models for sensor data utilize 10–30 KB of SRAM, making them feasible for the R4’s 32 KB memory. [robu](https://robu.in/easy-arduino-ai-ml-project-using-smartelex-bharat-ai-innovators-kit-powered-by-arduino-uno-ek-r4-wifi/)
- **Power Consumption**: On-device inference is highly efficient, with energy consumption per inference reported between 10.6 and 22.1 mJ on similar Cortex-M4 architectures. [pmc.ncbi.nlm.nih](https://pmc.ncbi.nlm.nih.gov/articles/PMC12722349/)

### References (APA 7th Edition)

Anđelić, N., Baressi Šegota, S., Lorencin, I., Jurilj, Z., & Štifanić, D. (2022). The development of symbolic expressions for fire detection through the use of sensor fusion and genetic programming. _Sensors (Basel, Switzerland)_, _23_(1), 136. https://doi.org/10.3390/s23010136

Arduino. (2023, December 31). _UNO R4 WiFi | Arduino Documentation_. https://docs.arduino.cc/hardware/uno-r4-wifi

Bohrium. (2025, September 9). _Fire detection using smoke and gas sensors_. https://www.bohrium.com/paper-details/fire-detection-using-smoke-and-gas-sensors/812004415060836357-4116

He, Y., Zhang, X., & Li, J. (2023). Hybrid feature fusion-based high-sensitivity fire detection system. _Sensors_, _23_(2), 643. https://doi.org/10.3390/s23020643

Mubarak, A., & Ahmad, S. (2025). Deploying TinyML for energy-efficient object detection and environmental monitoring on resource-constrained MCUs. _Journal of Low Power Electronics and Applications_, _15_(1), 4. https://doi.org/10.3390/jlpea15010004

National Fire Protection Association (NFPA). (2025). _NFPA 72: National Fire Alarm and Signaling Code_. https://www.nfpa.org/codes-and-standards/nfpa-72-standard-development/72

Solórzano, A., Gràcia, I., Figueras, E., & Fonseca, L. (2024). Classification in early fire detection using multi-sensor nodes—A study on data quality and model reliability. _Sensors_, _24_(5), 1432. https://doi.org/10.3390/s24051432
