jimzord12/ai-fire-detection-arduino-system/thesis/typst/chapters/04_introduction/sections/4_1_overview/research/002_research.md

### Global Fire Statistics (2020–2025)

Between 2018 and 2022, fire services in 57–81 countries recorded approximately 4 million fires annually, in which 35,000–36,000 people died and roughly 63,000 were injured, translating to about 1.1 deaths and 3.2 injuries per 100,000 people each year in the surveyed countries. A 2022 snapshot of 55 countries (covering about 1/5 of the global population) found 3.7 million fire‑related incidents among 64 million total fire‑service calls, with 19,600 deaths and 55,600 injuries in that year alone. In cities, about 80% of fire fatalities and 74% of injuries occur in residential buildings, underscoring the disproportionate burden on the **residential sector** versus industrial and transport fires, which account for a smaller share of casualties even though they feature heavily in total incident counts. [ctif](https://www.ctif.org/sites/default/files/2024-06/CTIF_Report29_ERG.pdf)

Globally, insurance and catastrophe‑risk studies estimate that fires and wildfires contributed tens of billions of dollars in annual insured losses over 2020–2025, with wildfires alone causing about USD 106 billion in economic losses between 2014 and 2023, and individual large‑scale urban‑wildland fires (e.g., around Los Angeles) exceeding tens of billions of dollars in overall property damage. Residential and mixed‑occupancy fires dominate the property‑damage and casualty profiles, while industrial and commercial fires tend to be fewer in number but can yield extremely high asset‑loss values when they occur near dense urban infrastructure. [reuters](https://www.reuters.com/business/environment/global-insured-catastrophe-losses-set-hit-107-billion-2025-report-shows-2025-12-16/)

### The False Alarm Crisis

False‑alarm responses represent a substantial share of fire‑service workload. In the United Kingdom, fire‑rescue services recorded 251,479 fire‑false‑alarm incidents in the year ending September 2025, amounting to 39% of all incidents attended, while actual fires represented 28% and non‑fire incidents 33%. In the same period, 169,717 of these false alarms were attributed to “apparatus” (e.g., faulty detectors or wiring), 75,941 to “good intent” (often cooking‑related nuisance alarms), and 5,821 to malicious activations. Home‑Office data for 2020/21 show that 98% of automatic fire‑alarm incidents were false alarms, with only 2% representing actual fires, indicating that the **majority of automatic‑alarm call‑outs are non‑fire events**. [asadria](https://www.asadria.com/en/false-alarms-make-up-98-of-automatic-fire-alarm-confirmed-incidents-in-2020-21/)

In practical terms, false alarms create a “cry‑wolf” effect: repeated unverified activations can desensitize occupants and staff, leading to delayed evacuations or disabling of detectors, which in turn raises the risk of delayed escape during a genuine fire. Economically, false alarms impose large recurrent costs on emergency‑service budgets. For example, Fire and Emergency New Zealand estimates that false‑fire‑alarm call‑outs may cost up to 40 million USD annually, with 40% of attended alarms being false in 2023, and each alarm likely costing several thousand dollars when crew time, travel, and equipment wear are included. Sector‑wide analyses in the United States indicate that a single false‑alarm response can cost fire departments up to 500 USD or more, and when scaled across hundreds of thousands of events per jurisdiction, the cumulative financial burden on public‑safety agencies is substantial. A UK‑based study estimates that avoidable fire alarms cost the UK economy about £696 million per year in lost productivity, fines, and operational disruption. [electricallicenserenewal](https://www.electricallicenserenewal.com/Electrical-Continuing-Education-Courses/NEC-Content.php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)

### Technological Gap: Traditional Detectors vs. Multi‑Sensor Fusion and Edge AI

Traditional ionization and photoelectric smoke detectors are well‑suited for detecting specific fire types but suffer from **high false‑alarm sensitivity to non‑fire aerosols**. Ionization detectors are highly susceptible to nuisance alarms from cooking smoke, steam, and dust, which often leads to detector tampering or disabling in residential settings. Photoelectric detectors are less prone to cooking‑related nuisance alarms but can still be triggered by dense steam or aerosols, and they are slower to respond to fast‑flaming fires than ionization units. Neither technology reliably distinguishes between smoke from a real fire and that from cooking, steam, or certain cleaning products, which underpins the high observed rate of nuisance alarms. [digitize-inc](https://www.digitize-inc.com/blog/ionization-vs-photoelectric-smoke-detector.php)

Multi‑sensor fire detectors, which combine smoke, heat, and often carbon monoxide (CO) sensing in a single point device, directly address this limitation. By fusing multiple physical cues, these detectors achieve higher accuracy, reduce false alarms, and respond faster to genuine fire events. Standards such as EN 54‑29 (smoke and heat), EN 54‑30 (CO and heat), and EN 54‑31 (smoke, CO, and optionally heat) formalize performance criteria for multi‑sensor detectors, including requirements for robustness against dust, steam, and cooking vapours. In practice, integrating additional sensor modalities (e.g., VOC, temperature, humidity, and IR‑flame sensing) and using **on‑node signal processing or Edge AI** can further refine classification, enabling three‑class outputs (e.g., **fire**, **no_fire**, **false_alarm**) rather than simple binary alarms. Such approaches allow the system to learn and encode typical “false‑alarm” signatures from kitchen events, steam, and cleaning activities, thereby reducing unnecessary dispatches while preserving early‑warning capability for true fires. [euralarm](https://www.euralarm.org/static/f35ca70d-0731-4683-aba1e2ab9cfd8741/White-Paper-How-multi-sensor-fire-detectors-can-help-to-reduce-false-alarms.pdf)

### Regulatory Context: EN 54 and NFPA 72

Both EN 54 and NFPA 72 are evolving to emphasize **false‑alarm reduction and multi‑sensor performance**. EN 54 standards now explicitly include multi‑sensor point detectors (EN 54‑29, EN 54‑30, EN 54‑31) that require detectors to meet stricter criteria for accuracy and robustness against non‑fire aerosols and environmental disturbances. These standards support the use of adjustable sensitivity and multi‑criterion verification to tailor detection to specific environments and minimize nuisance alarms, which is particularly important in residential and mixed‑use buildings. [standards.iteh](https://standards.iteh.ai/catalog/standards/cen/a3fb9236-0f4c-44c5-84d3-abd175969559/en-54-29-2015)

NFPA 72 has also been updated to strengthen requirements related to unwanted alarms. The 2013 edition of NFPA 72 introduced clearer definitions and procedures for unwanted (i.e., false) alarms and enhanced rules for alarm‑signal verification and content in supervising‑station and auxiliary‑service systems. Subsequent editions (2016–2025) have expanded cybersecurity and pathway‑survivability provisions, and the 2022–2025 texts explicitly anticipate a shift from single‑criterion ionization and photoelectric detectors toward **multi‑criterion detectors that are more resistant to false triggers**. In residential contexts, NFPA 72 now requires smoke alarms and detectors near cooking appliances to be listed for resistance to cooking nuisance alarms, and encourages the use of technologies that minimize false activations without compromising detection reliability. [accindia](https://www.accindia.org/document_management/NFPA-72-2025.pdf)

---

### References (APA 7th Edition)

- Center for Fire Statistics of CTIF. (2024). _World fire statistics, Report № 29_. International Association of Fire and Rescue Services. Retrieved from CTIF Center for Fire Statistics. [ctif](https://www.ctif.org/sites/default/files/2024-06/CTIF_Report29_ERG.pdf)
- Fire and Rescue Incident Statistics, Year Ending September 2025. (2026). UK Government. Retrieved from gov.uk. [gov](https://www.gov.uk/government/statistics/fire-and-rescue-incident-statistics-year-ending-september-2025/fire-and-rescue-incident-statistics-year-ending-september-202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)
- Home Office (UK). (2021). _Fire and rescue incident statistics_. [asadria](https://www.asadria.com/en/false-alarms-make-up-98-of-automatic-fire-alarm-confirmed-incidents-in-2020-21/)
- Fire and Emergency New Zealand (FENZ). (2024). _False fire alarm call‑outs costing up to $40 million annually_. Retrieved from Fire and Emergency New Zealand. [firesecurity.co](https://www.firesecurity.co.nz/news/2024/8/22/false-fire-alarm-callouts-cost-up-to-40m-annually)
- National Fire Protection Association (NFPA). (2024). _NFPA 72: National Fire Alarm and Signaling Code, 2025 edition_. NFPA. [accindia](https://www.accindia.org/document_management/NFPA-72-2025.pdf)
- NFPA 72 in‑depth commentary and technical‑update analyses (e.g., NFPA, 2022–2025). [csemag](https://www.csemag.com/what-to-look-for-in-nfpa-72-2022/)
- Euralarm. (2024). _White paper: How multi‑sensor fire detectors can help to reduce false alarms_. Euralarm. [euralarm](https://www.euralarm.org/static/f35ca70d-0731-4683-aba1e2ab9cfd8741/White-Paper-How-multi-sensor-fire-detectors-can-help-to-reduce-false-alarms.pdf)
- CEN EN 54‑29:2015 – _Multi‑sensor fire detectors using a combination of smoke and heat sensors_. [standards.iteh](https://standards.iteh.ai/catalog/standards/cen/a3fb9236-0f4c-44c5-84d3-abd175969559/en-54-29-2015)
- Insurance and catastrophe‑risk reports (e.g., Swiss Re, Munich Re, 2020–2025). [undrr](https://www.undrr.org/news/invisible-costs-wildfire-disasters-2025)
- False‑alarm management and economic‑cost studies (e.g., Fire Security New Zealand, Centralsquare, Hochiki Europe). [centralsquare](https://www.centralsquare.com/resources/articles/false-alarm-management-public-safety-challenges-and-solutions)
- Safety and fire‑detection‑technology reviews (e.g., Euralarm, CTIF, NFPA‑linked technical‑bulletins). [electricallicenserenewal](https://www.electricallicenserenewal.com/Electrical-Continuing-Education-Courses/NEC-Content.php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)
