jimzord12/ai-fire-detection-arduino-system/thesis/typst/chapters/04_introduction/sections/4_1_overview/research/research_query.md

# Research Query: 1.1 Background

Using the shared context of the "Autonomous Multi-Sensor Fire Detection Node," research the global landscape of fire safety with a focus on the economic and social burden of false alarms. 

**Key Research Areas:**
1. **Global Fire Statistics (2020-2025)**: Provide data on annual fire-related deaths, injuries, and property damage in residential vs. industrial sectors.
2. **The False Alarm Crisis**: Quantify the percentage of fire department responses to false alarms (e.g., in the US, UK, and EU). Analyze the "cry wolf" effect on occupant behavior and the financial cost to emergency services.
3. **Technological Gap**: Contrast the limitations of traditional ionization and photoelectric smoke detectors (e.g., sensitivity to non-fire aerosols like steam/cooking) with the potential of multi-sensor fusion and Edge AI.
4. **Regulatory Context**: Briefly mention how standards like EN 54 and NFPA 72 are evolving to address false alarm reduction.

**Requirements:**
- Provide all citations in-text.
- Include a full reference list in **APA 7th Edition**.
- Focus on sources from **2015-present**.
