jimzord12/ai-fire-detection-arduino-system/docs/research/data-collection/appendix.md

# Appendix & References

1. Edge Impulse. (2024). Data Acquisition and Collection Best Practices. https://docs.edgeimpulse.com/studio/projects/data-acquisition
2. Deng, X., et al. (2023). An Indoor Fire Detection Method Based on Multi-Sensor Fusion. IEEE Sensors Journal, 23(24), 30451–30461.
3. Kim, G. L., et al. (2024). A Multi-Sensor Fire Detection Method based on Trend Value Extraction. Journal of Systems and Software Technology (JSST).
4. Muñoz, A., & Manzini, P. (2023). Sensor Fusion Strategies for IoT-based Fire Detection Systems. IoT Research Today, 12(3), 145–162.
5. Renesas. (2024). Arduino UNO R4 WiFi Technical Specifications. https://www.renesas.com
