jimzord12/ai-fire-detection-arduino-system/.gemini/v1/cli-tools/image-gen-ts/README.md

# Image Generation CLI

A command-line tool for generating images using the OpenRouter API with models like Google Gemini.

## Prerequisites

- **Node.js** (v18 or later)
- **npm** or **pnpm**
- An **OpenRouter API key** (get one at [openrouter.ai](https://openrouter.ai))

## Installation

1. Navigate to the tool directory:

   ```bash
   cd .gemini/cli-tools/image-gen-ts
   ```

2. Install dependencies:

   ```bash
   npm install
   ```

3. Set up your environment variables. Create a `.env` file in this directory or the project root with:

   ```env
   OPENROUTER_API_KEY=your_api_key_here
   OPENROUTER_IMAGE_MODEL=google/gemini-3-pro-image-preview
   ```

   > **Note:** A `.env` symlink may already exist pointing to the project root's `.env` file.

## Usage

### Using the Shell Script (Recommended)

The shell script provides a convenient wrapper for the TypeScript tool:

```bash
./image-gen.sh <prompt-file> [output-path] [options]
```

### Arguments

| Argument | Required | Description |
| --- | --- | --- |
| `<prompt-file>` | Yes | Path to a text file containing the image generation prompt |
| `[output-path]` | No | Output path for the generated image (default: `out.png`) |

### Options

| Option | Description |
| --- | --- |
| `-m, --model <model>` | OpenRouter model ID (default: from env or `google/gemini-2.5-flash-image-preview`) |
| `-a, --aspect-ratio <ratio>` | Aspect ratio: `1:1`, `16:9`, `9:16`, `4:3`, `3:4` |
| `-s, --image-size <size>` | Image size: `1K`, `2K`, `4K` (Gemini models only) |

## Examples

### Basic Usage

1. Create a prompt file:

   ```bash
   echo "A beautiful sunset over the ocean with sailing boats" > prompt.txt
   ```

2. Generate an image:
   ```bash
   ./image-gen.sh prompt.txt sunset.png
   ```
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
