jimzord12/ai-fire-detection-arduino-system/data/analysis/sensor_distributions.png

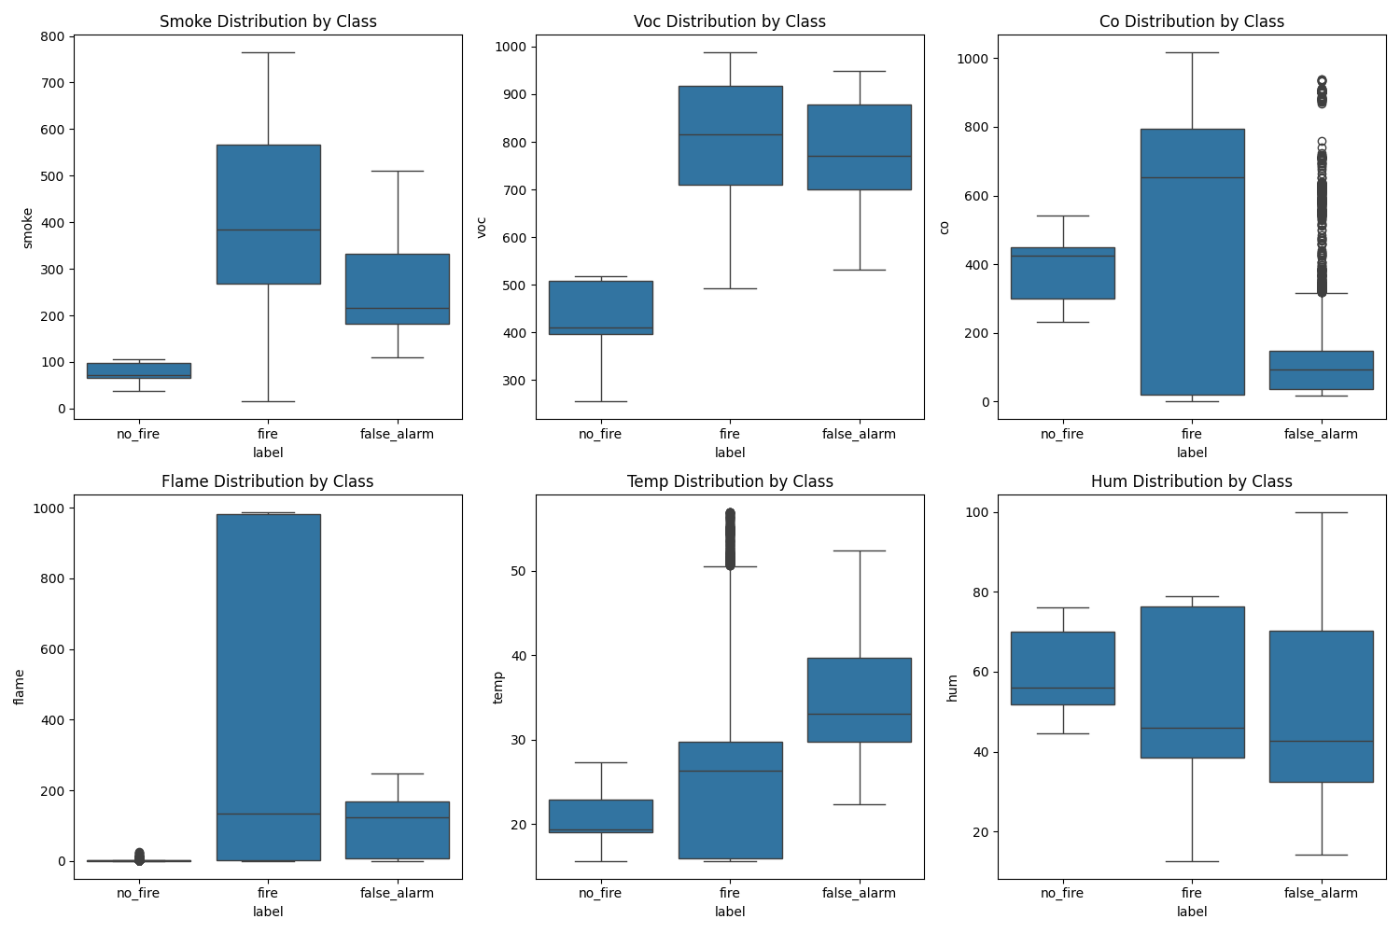
data/analysis/sensor_distributions.png
