jimzord12/ai-fire-detection-arduino-system/thesis/typst/assets/figures/data-collection-evidence/003-flame-smoke-indoors.jpg

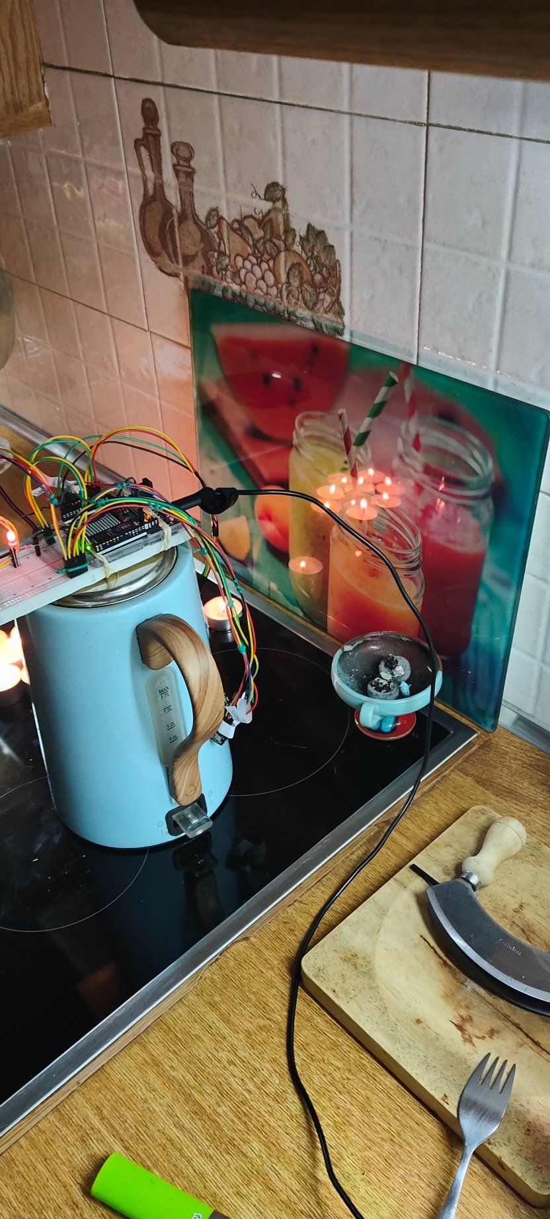
thesis/typst/assets/figures/data-collection-evidence/003-flame-smoke-indoors.jpg
