jimzord12/ai-fire-detection-arduino-system/thesis/typst/assets/figures/edge-impulse/001-platform-data-acquisition.png

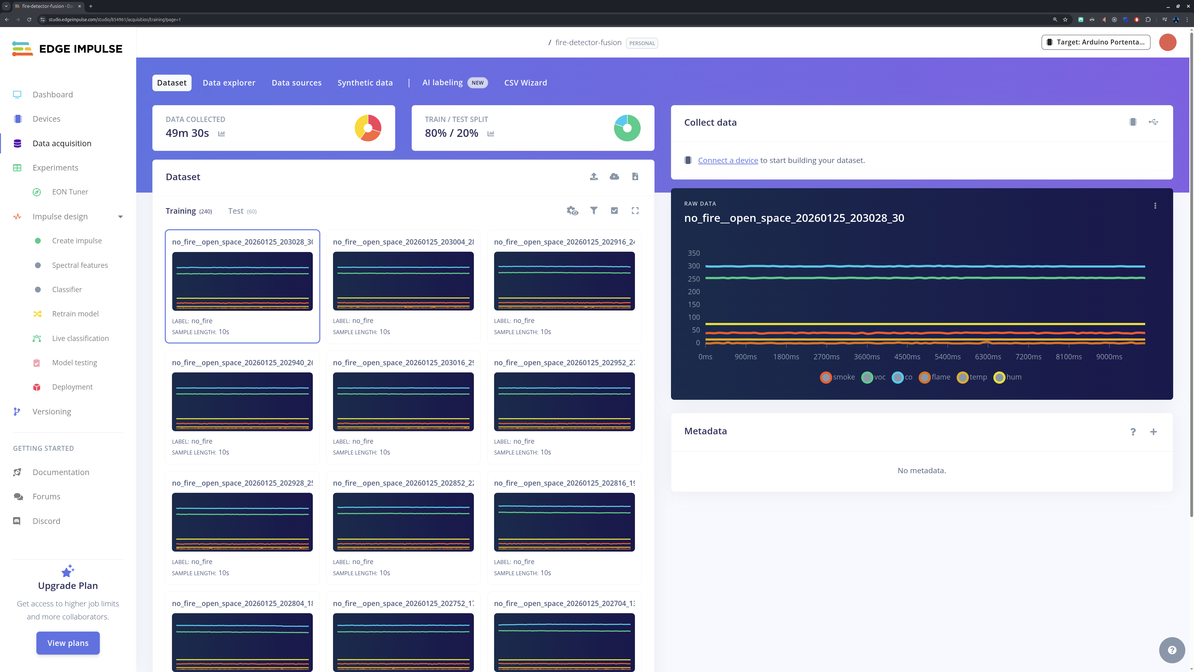
thesis/typst/assets/figures/edge-impulse/001-platform-data-acquisition.png
