jimzord12/ai-fire-detection-arduino-system/thesis/typst/assets/figures/edge-impulse/005-platform-feature-explorer.png

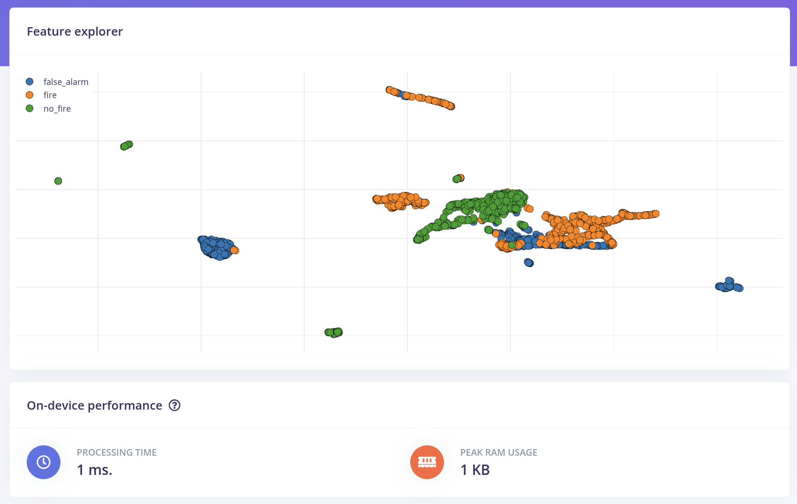
thesis/typst/assets/figures/edge-impulse/005-platform-feature-explorer.png
