jimzord12/ai-fire-detection-arduino-system/thesis/typst/assets/figures/edge-impulse/006-platform-classifier.png

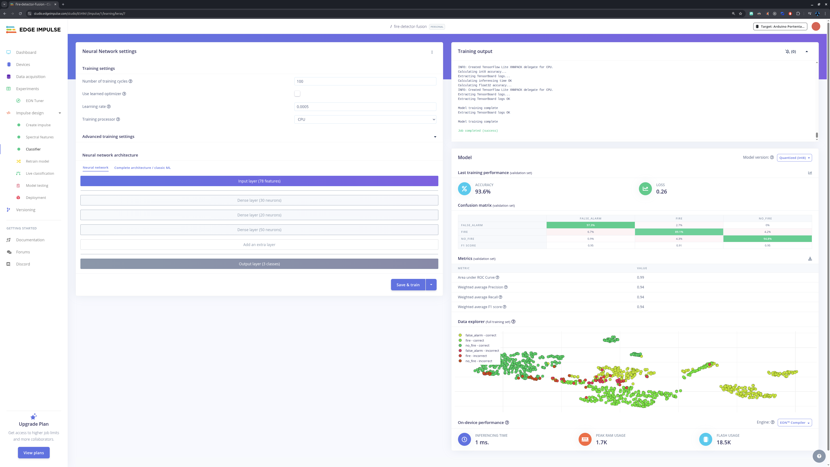
thesis/typst/assets/figures/edge-impulse/006-platform-classifier.png
