jimzord12/ai-fire-detection-arduino-system/thesis/typst/assets/figures/edge-impulse/009-platform-deployment.png

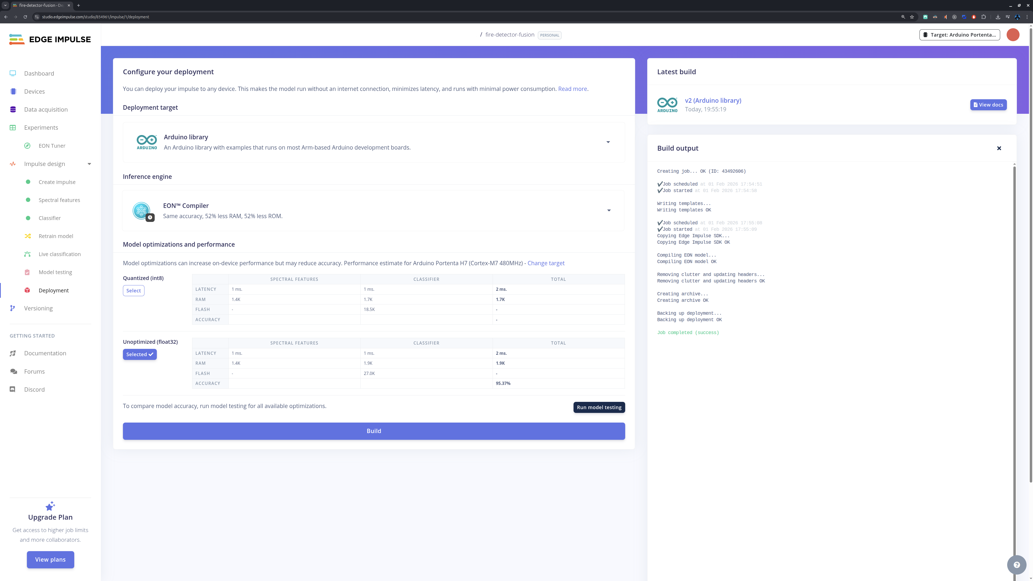
thesis/typst/assets/figures/edge-impulse/009-platform-deployment.png
