jimzord12/ai-fire-detection-arduino-system/.gemini/v1/cli-tools/ref-tools/test-refs.md

# Test References

- Abu Dhabi Ports. (2018, June 2). _Abu Dhabi Ports launches blockchain technology for trade community_. https://www.adports.ae/abu-dhabi-ports-launches-blockchain-technology-for-trade-community/ (Exists!)

- Acharya, D., Palani, S., & Kumar, S. (2024). Towards automatic anomaly detection in fisheries using deep learning. _Fisheries Research, 273_, 106777. https://doi.org/10.1016/j.fishres.2024.106777 (DOI not found)

- Assani, N., Matic, P., & Katalinic, M. (2022). Ship’s Digital Twin—A Review of Modelling Challenges and Applications. Applied Sciences, 12(12), 6039. https://doi.org/10.3390/app12126039 (Exists!)

- Ava Singh, (2025, April 16). Revolutionary biodegradable sensors are changing how we monitor Ocean Health. Marine Biodiversity Science Center. http://www.marinebiodiversity.ca/revolutionary-biodegradable-sensors-are-changing-how-we-monitor-ocean-health/ (Exists)

- Shang, Z., Wang, J., & Yang, Y. (2025). Maritime communication networks: A survey on architecture, key technologies, and challenges. _Computer Communications, 216_, 189–213. https://doi.org/10.1016/j.comcom.2025.108255 (Exists)

- Zhang, L., Li, X., & Wang, Y. (2023). An AI-powered framework for optimizing maritime logistics operations. _Transportation Research Part E: Logistics and Transportation Review, 170_, 102789. https://www.mdpi.com/2311-7524/12/1/12345 (Site not found)
