jimzord12/ai-fire-detection-arduino-system/thesis/typst/chapters/06_analysis_design/sections/6_3_sensors/sections/4_4_sensor_calibration_protocols_and_baseline_behavior/content.md

The reliability of an autonomous fire detection node is contingent upon the accurate calibration of its sensors and a clear understanding of their baseline behavior in diverse environments. Because metal-oxide (MOS) gas sensors and infrared flame sensors are prone to drift and environmental interference, specific protocols must be implemented during both hardware initialization and software execution to ensure data integrity. This section outlines the calibration procedures and baseline stabilization techniques employed in the project's firmware.

## Hardware Pre-heating and Stabilization

MOS-based MEMS gas sensors, such as the Fermion smoke, VOC, and CO sensors, require a thermal stabilization period to achieve a consistent baseline resistance. Upon initial deployment, new sensors must undergo a "burn-in" period of approximately 48 hours to remove contaminants from the sensing layer and stabilize the internal micro-heater (DFRobot, 2024c). In daily operation, the node implements a software-controlled warm-up phase of 120 seconds upon power-up, during which sensor readings are monitored but not used for inference. This ensures that the sensing layer has reached its optimal operating temperature (typically 200°C to 400°C), minimizing the risk of false positives caused by cold-start transients (Hatip & Kocamaz, 2024).

## Software-Level Baseline Detection

To account for long-term sensor drift and varying ambient air quality, the system utilizes a dynamic baseline detection algorithm within the Arduino firmware. The baseline represents the "no_fire" state of the environment.

### Differential Sensing Logic

Rather than relying on absolute voltage thresholds, the node's inference logic is based on the differential change from the established baseline ($\Delta R/R_0$). During the first 10 seconds of stable operation (after the warm-up period), the firmware calculates the mean and standard deviation of each gas sensor channel to define the ambient baseline (Rasim & Max, 2024). This allows the system to adapt to different rooms or seasonal variations in background gas concentrations. As implemented in `fire-detection-main.ino`, the system performs continuous "sanity checks" to ensure that the baseline remains within expected physiological limits before permitting the machine learning model to trigger an alarm.

## Flame Sensor Sensitivity Adjustment

The Gravity Analog Flame Sensor requires a manual calibration of its onboard potentiometer to define the detection range. Calibration is performed by exposing the sensor to a controlled IR source (simulating a small flame) at the maximum required detection distance (e.g., 1 meter) and adjusting the potentiometer until the digital trigger threshold is reached. This hardware-level adjustment provides a coarse filter for static IR noise, such as sunlight or high-intensity artificial lighting, which is then further refined by the temporal flicker analysis in the machine learning model (Meleti & Tsanakas, 2024).

## Environmental Compensation (AHT20)

The AHT20 sensor comes factory-calibrated and does not require user adjustment. However, its high-resolution temperature and humidity data are used to compensate for the cross-sensitivity of the MOS gas sensors. As humidity increases, water vapor molecules compete for active sites on the gas sensing layer, potentially lowering the perceived resistance (Hatip & Kocamaz, 2024). The fusion model uses the AHT20's digital output to normalize these readings, ensuring that the detected gas trends are independent of ambient weather conditions.

## References

DFRobot. (2024c). *Fermion: MEMS VOC Gas Sensor - SEN0566 Datasheet*. https://wiki.dfrobot.com/SKU_SEN0566_Fermion_MEMS_VOC_Gas_Sensor

Hatip, H., & Kocamaz, U. E. (2024). A multisensory fusion-based approach for fire detection using machine learning. *Journal of Fire Sciences*, 42(1), 45-62.

Meleti, E., & Tsanakas, J. A. (2024). Obscured fire detection using edge intelligence and multi-modal sensing. *Sensors*, 24(5), 1532.

Rasim, M., & Max, A. (2024). Fire detection system using Arduino and MEMS sensors. *International Journal of Embedded Systems*, 16(2), 120-135.

## Glossary

**Burn-in Period**: A period of time where a sensor is powered on and operated to stabilize its performance and remove initial contaminants.
**Baseline Resistance ($R_0$)**: The electrical resistance of a gas sensor in clean air or a stable ambient environment.
**Differential Sensing**: A method of measurement where the change in a value relative to a baseline is more important than the absolute value.
**Environmental Compensation**: The process of adjusting sensor readings to account for the influence of environmental factors like temperature and humidity.
