jimzord12/ai-fire-detection-arduino-system/thesis/typst/chapters/07_implementation_testing/sections/7_2_methodology/sections/6_1_safety_protocols_during_data_collection/content_ieee_no_glossary.md

Conducting laboratory experiments involving controlled combustion events introduces a range of physical, chemical, and environmental hazards that demand structured risk mitigation prior to data acquisition. The generation of open flames, smoldering materials, and the associated release of toxic combustion by-products — including carbon monoxide (CO), volatile organic compounds (VOCs), and particulate matter — create conditions that can pose immediate harm to researchers if left unmanaged. Accordingly, the data collection phase of this project was preceded by a formal risk assessment and the establishment of layered safety controls spanning fire containment, laboratory ventilation, and the use of personal protective equipment (PPE).

## Hazard Identification and Risk Assessment

Before any combustion experiment was initiated, a systematic hazard identification process was conducted to catalogue the primary risks associated with each planned fire scenario. Three categories of hazard were identified: (1) uncontrolled fire propagation, (2) inhalation of toxic combustion gases, and (3) thermal burns to personnel.

The toxic hazard profile of combustion events is well established in the literature. Fonollosa et al. (2018) identify CO, hydrogen cyanide (HCN), and VOCs as the principal toxic agents released during both smoldering and flaming fires @fonollosa2018chemical. Specifically, CO — produced under lean combustion conditions — can reach lethal concentrations in a confined space, and its toxic potency is further amplified when co-present with CO2. Similarly, VOCs generated during the pyrolysis phase of polymeric materials — including acrolein and formaldehyde — represent significant irritant hazards @fonollosa2018chemical. Khan et al. (2022) corroborate these findings, confirming that CO remains the most diagnostic and most hazardous combustion gas across diverse fire types @khan2022recent.

For this project, fire loads included paper, wood, and cloth (fire class), as well as cooking-derived aerosols and alcohol vapors (false alarm class). A risk matrix was constructed prior to experiments, mapping each scenario to its expected gas concentrations and thermal hazard level. Scenarios involving direct ignition of solid materials (e.g., wood, cloth) were classified as highest risk and subjected to the most stringent containment and monitoring controls.

## Fire Containment Measures

All controlled burns were conducted within a designated fireproof experimental enclosure lined with non-combustible ceramic tile and stainless-steel trays to contain any ash, embers, or liquid accelerants. The combustion test volume was dimensionally bounded to prevent flame propagation beyond the immediate sensor proximity zone, consistent with small-scale fire test methodologies reported in peer-reviewed literature.

Vorwerk et al. (2024) describe a directly analogous small-scale experimental setup for multi-sensor fire data collection, ensuring that combustion remained confined to a precisely defined fuel mass without transitioning to uncontrolled open flame @vorwerk2024classification. In the present project, a dry-powder fire extinguisher was positioned within immediate reach at all times during experiments involving open flame scenarios. No experiment was conducted without a second researcher present to act as a dedicated safety monitor.

## Ventilation Requirements

Adequate ventilation was identified as the primary engineering control for managing the inhalation hazard posed by CO and VOC accumulation during experiments. All combustion experiments were conducted in a room equipped with a mechanical exhaust ventilation system, with the exhaust outlet positioned directly above the combustion zone to capture buoyant combustion products before dispersal into the researcher's breathing zone.

The criticality of ventilation control in fire detection experiments is underscored by research showing that experimental conditions directly affect the rate of CO, smoke, and temperature accumulation in the test room @li2022research. Standardised ventilation states were maintained for all fire and false-alarm class recordings, while a sealed-room baseline was recorded for no-fire ambient conditions to characterise background sensor drift. Following each experiment, a mandatory purge period of no less than 10 minutes was observed before the next trial commenced, allowing sensor baselines to recover and residual gases to clear.

## Personal Protective Equipment (PPE)

Researchers conducting experiments were required to wear a minimum standard of PPE throughout all fire class and false-alarm class data collection sessions. The mandatory PPE set comprised a half-face elastomeric respirator fitted with combined P3/A1 filter cartridges, safety glasses, a flame-resistant cotton laboratory coat, and heat-resistant silicone gloves when handling materials post-experiment.

The necessity of respiratory protection during fire-related experimental work is corroborated by research noting that experimental procedures for incipient fire generation expose personnel to sub-threshold but cumulatively significant concentrations of CO and VOC @vorwerk2024classification. A personal clip-on electrochemical CO monitor was worn by the lead researcher at all times during combustion experiments. If the personal monitor alarmed, the experiment was immediately suspended, the room evacuated, and mechanical ventilation maximised. No experiment proceeded if the pre-session ambient CO reading exceeded 5 ppm, providing a conservative pre-screening margin.
