jimzord12/ai-fire-detection-arduino-system/thesis/typst/chapters/07_implementation_testing/sections/7_2_methodology/sections/6_2_rationale_for_three_class_classification/content.md

# 6.2 Rationale for Three-Class Classification

The decision to frame fire detection as a three-class classification problem—distinguishing between **fire**, **no_fire**, and **false_alarm**—is a deliberate design choice motivated by the demonstrable inadequacy of binary approaches in the presence of real-world nuisance sources. This section articulates the theoretical and empirical grounds for this classification schema, drawing on the literature on false alarm prevalence, the chemical similarity between nuisance and fire events, and the comparative performance of binary versus multi-class models in sensor-based fire detection systems.

## 6.2.1 The Limitations of Binary Classification in Practical Fire Detection

The dominant paradigm in early sensor-based fire detection has historically been binary classification: a system either declares a _fire_ state or a _no-fire_ state. While conceptually straightforward, this formulation conflates two phenomenologically distinct non-fire conditions—genuine ambient environments and nuisance events—under a single negative class. Fonollosa et al. (2018) observed, in a comprehensive review of chemical sensor systems for fire detection, that gas-sensor arrays trained on binary fire/no-fire models still produced a false alarm rate of 35% when exposed to nuisance scenarios not seen during training, such as cooking aerosols, water steam, and cleaning products. The authors concluded that _"the use of dynamic features and multivariate models that exploit sensor correlations seems imperative"_ to achieve reliable discrimination between combustion events and nuisance sources (Fonollosa et al., 2018, p. 2). This finding underscores a structural weakness of the binary model: since nuisance events can produce sensor signatures—elevated smoke optical density, temperature spikes, and VOC readings—that partially overlap with incipient fire signatures, collapsing both ambient and nuisance conditions into a single _no-fire_ class forces the decision boundary to occupy an ambiguous and poorly defined feature subspace.

The prevalence of false alarms carries significant real-world consequences that further justify a more granular classification approach. Fonollosa et al. (2018) noted that in the United Kingdom alone, false alarms from automatic fire detection systems were estimated to cost approximately £1 billion per year, with some reporting periods showing that as few as 11% of triggered alarms corresponded to genuine fire events. In such an environment, a binary classifier that cannot distinguish between a cooking-induced smoke plume and actual combustion is operationally unreliable; occupants habituate to frequent spurious alarms and may disable or ignore detection systems altogether (Fonollosa et al., 2018).

## 6.2.2 Chemical and Thermal Overlap Between Nuisance and Fire Events

The core technical challenge motivating the three-class design is the degree to which common false alarm sources produce sensor responses that mimic early fire conditions. Cooking fumes, for instance, generate aerosols and elevated temperatures that activate optical smoke sensors and thermal detectors in ways that are nearly indistinguishable from smoldering fires at the single-sensor level. Solórzano et al. (2021) demonstrated this overlap empirically in a gas sensor array study conducted in a validated standard fire room (EN-54 compliant, 240 m³): after several months of operation, a PLS-DA model evaluated against nuisance scenarios achieved 100% specificity but only 85% sensitivity, failing specifically on plastic fires _"whose signatures are close to nuisance scenarios"_ (Solórzano et al., 2021, p. 5). This result highlights that even well-calibrated multivariate models struggle to maintain separation between fire and nuisance when the underlying chemical signatures share common compounds such as VOCs and CO.

Similar overlap has been documented at the algorithmic level. Li et al. (2022) reported that in a multi-class fire perception system using NIST residential fire data, the most common misclassification involved confusing _smoldering_ with _no-fire_ observations, precisely because early-stage smoldering produces gradual, low-amplitude sensor trends that are difficult to distinguish from ambient drift—_"smoldering burns quite slowly, resulting in insignificant changes in sensor data during the initial stage of the fire"_ (Li et al., 2022, p. 9). This characteristic makes smoldering events the most dangerous scenario for a binary system, since the fire state is most likely to be suppressed under the dominant _no-fire_ class until combustion products reach hazardous concentrations.

## 6.2.3 Three-Class Classification as a Design Solution

Introducing an explicit **false_alarm** class directly addresses the shortcomings described above by providing the model with labeled training examples of nuisance events—cooking fumes, alcohol vapors, steam, and intense infrared illumination—that share partial sensor signatures with fire but lack the complete multivariate profile of genuine combustion. This expands the decision space such that the classifier must learn a distinct, dedicated region for nuisance phenomena rather than allowing those observations to contaminate either the _fire_ or the _no_fire_ boundary.

The effectiveness of moving beyond binary classification has been corroborated in the literature. Milke et al., as cited by Vorwerk et al. (2024), demonstrated that classifying sensor array data into three conditions—_flaming fire_, _smoldering fire_, and _nuisance_—using a three-layer neural network achieved a classification rate of 97%, compared to 90% using hard decision rules, establishing that the nuisance class carries discriminative information that improves overall system performance. Vorwerk et al. (2024) themselves applied a four-class transfer learning approach to EN-54 standard test room data and concluded that multi-class outputs _"provide valuable additional information about the nature of an ongoing incipient fire event, enabling first responders or firefighters to make more informed decisions"_ (Vorwerk et al., 2024, p. 2). Their finding that binary-constrained prior studies consistently underperformed multi-class formulations reinforces the case for the three-class schema adopted in this work.

For the present system, the three classes are operationally defined as follows. The **fire** class encompasses genuine combustion events producing correlated elevations across CO, smoke, VOC, and IR flame channels, accompanied by temperature rise. The **no_fire** class represents stable ambient conditions with no significant cross-sensor activity. The **false_alarm** class captures nuisance events—cooking-induced smoke, ethanol vapor, and non-combustion IR sources—that may activate one or two individual sensors but do not produce the correlated multi-sensor signature characteristic of actual fire. This tripartite schema leverages the full dimensionality of the five-sensor fusion architecture and provides the TinyML classifier with the inter-class boundaries necessary to suppress spurious activations without reducing sensitivity to genuine fire events.

---

## References

Fonollosa, J., Solórzano, A., & Marco, S. (2018). Chemical sensor systems and associated algorithms for fire detection: A review. _Sensors_, _18_(2), Article 553. https://doi.org/10.3390/s18020553

Li, Y., Su, Y., Zeng, X., & Wang, J. (2022). Research on multi-sensor fusion indoor fire perception algorithm based on improved TCN. _Sensors_, _22_(12), Article 4550. https://doi.org/10.3390/s22124550

Solórzano, A., Eichmann, J., Fernández, L., Ziems, B., Jiménez-Soto, J. M., Marco, S., & Fonollosa, J. (2021). Early fire detection based on gas sensor arrays: Multivariate calibration and validation. _Sensors and Actuators B: Chemical_, _352_, Article 130961. https://doi.org/10.1016/j.snb.2021.130961

Vorwerk, P., Kelleter, J., Müller, S., & Krause, U. (2024). Classification in early fire detection using multi-sensor nodes—A transfer learning approach. _Sensors_, _24_(5), Article 1428. https://doi.org/10.3390/s24051428
