jimzord12/ai-fire-detection-arduino-system/thesis/typst/chapters/07_implementation_testing/sections/7_2_methodology/sections/6_2_rationale_for_three_class_classification/content_ieee_no_glossary.md

The decision to frame fire detection as a three-class classification problem—distinguishing between fire, no_fire, and false_alarm—is a deliberate design choice motivated by the demonstrable inadequacy of binary approaches in the presence of real-world nuisance sources. This section articulates the theoretical and empirical grounds for this classification schema, drawing on the literature on false alarm prevalence, the chemical similarity between nuisance and fire events, and the comparative performance of binary versus multi-class models in sensor-based fire detection systems.

## The Limitations of Binary Classification in Practical Fire Detection

The dominant paradigm in early sensor-based fire detection has historically been binary classification: a system either declares a fire state or a no-fire state. While conceptually straightforward, this formulation conflates two phenomenologically distinct non-fire conditions—genuine ambient environments and nuisance events—under a single negative class. Fonollosa et al. (2018) observed that gas-sensor arrays trained on binary fire/no-fire models still produced a false alarm rate of 35% when exposed to nuisance scenarios not seen during training, such as cooking aerosols, water steam, and cleaning products @fonollosa2018chemical. This finding underscores a structural weakness of the binary model: since nuisance events can produce sensor signatures—elevated smoke optical density, temperature spikes, and VOC readings—that partially overlap with incipient fire signatures, collapsing both ambient and nuisance conditions into a single no-fire class forces the decision boundary to occupy an ambiguous and poorly defined feature subspace.

The prevalence of false alarms carries significant real-world consequences that further justify a more granular classification approach. In the United Kingdom alone, false alarms from automatic fire detection systems were estimated to cost approximately £1 billion per year, with some reporting periods showing that as few as 11% of triggered alarms corresponded to genuine fire events @fonollosa2018chemical. In such an environment, a binary classifier that cannot distinguish between a cooking-induced smoke plume and actual combustion is operationally unreliable; occupants habituate to frequent spurious alarms and may disable or ignore detection systems altogether.

## Chemical and Thermal Overlap Between Nuisance and Fire Events

The core technical challenge motivating the three-class design is the degree to which common false alarm sources produce sensor responses that mimic early fire conditions. Cooking fumes, for instance, generate aerosols and elevated temperatures that activate optical smoke sensors and thermal detectors in ways that are nearly indistinguishable from smoldering fires at the single-sensor level. Solórzano et al. (2021) demonstrated this overlap empirically in a gas sensor array study, where even well-calibrated multivariate models struggled to maintain separation between fire and nuisance when the underlying chemical signatures shared common compounds such as VOCs and CO @solorzano2021early.

Similar overlap has been documented at the algorithmic level. Li et al. (2022) reported that in a multi-class fire perception system, the most common misclassification involved confusing smoldering with no-fire observations, precisely because early-stage smoldering produces gradual, low-amplitude sensor trends that are difficult to distinguish from ambient drift @li2022research. This characteristic makes smoldering events the most dangerous scenario for a binary system, since the fire state is most likely to be suppressed under the dominant no-fire class until combustion products reach hazardous concentrations.

## Three-Class Classification as a Design Solution

Introducing an explicit false_alarm class directly addresses the shortcomings described above by providing the model with labeled training examples of nuisance events—cooking fumes, alcohol vapors, steam, and intense infrared illumination—that share partial sensor signatures with fire but lack the complete multivariate profile of genuine combustion. This expands the decision space such that the classifier must learn a distinct, dedicated region for nuisance phenomena rather than allowing those observations to contaminate either the fire or the no_fire boundary.

The effectiveness of moving beyond binary classification has been corroborated in the literature. Research has demonstrated that classifying sensor array data into three conditions—flaming fire, smoldering fire, and nuisance—using a neural network achieved a classification rate of 97%, establishing that the nuisance class carries discriminative information that improves overall system performance @vorwerk2024classification. Their finding that binary-constrained prior studies consistently underperformed multi-class formulations reinforces the case for the three-class schema adopted in this work.

For the present system, the three classes are operationally defined as follows. The fire class encompasses genuine combustion events producing correlated elevations across CO, smoke, VOC, and IR flame channels, accompanied by temperature rise. The no_fire class represents stable ambient conditions with no significant cross-sensor activity. The false_alarm class captures nuisance events—cooking-induced smoke, ethanol vapor, and non-combustion IR sources—that may activate one or two individual sensors but do not produce the correlated multi-sensor signature characteristic of actual fire. This tripartite schema leverages the full dimensionality of the five-sensor fusion architecture and provides the TinyML classifier with the inter-class boundaries necessary to suppress spurious activations without reducing sensitivity to genuine fire events.
