jimzord12/ai-fire-detection-arduino-system/thesis/typst/chapters/07_implementation_testing/sections/7_2_methodology/sections/6_3_sampling_parameters/content.md

# 6.3 Sampling Parameters

The selection of appropriate sampling parameters — encompassing both the data acquisition rate and the temporal window over which observations are aggregated — is a foundational decision in any embedded time-series classification system. In the context of multi-sensor fire detection, these parameters govern whether the node captures the transient chemical signatures of combustion, the characteristic flicker dynamics of an open flame, and the slower thermal and gas-concentration drifts that distinguish genuine fire from nuisance events. Critically, the chosen parameters must simultaneously satisfy the physical requirements of each sensing modality and remain within the computational budget of a Cortex-M4 microcontroller running a quantized neural network in real time.

## 6.3.1 Sampling Frequency

The Nyquist–Shannon sampling theorem states that a signal must be sampled at a rate strictly greater than twice the highest frequency component of interest in order to avoid aliasing artefacts during reconstruction and feature extraction (Samanta et al., 2024). In the context of infrared flame sensing, this constraint has concrete physical significance: turbulent, uncontrolled flames exhibit a wide-band flicker spectrum spanning 1–13 Hz, with the characteristic central frequency of approximately 10 Hz reported consistently in the combustion literature (Erden et al., 2012). To satisfy the Nyquist condition for all spectral content up to the 13 Hz upper bound, a minimum acquisition rate of 26 Hz would be theoretically required for the IR channel alone; however, the present system adopts a unified, cross-modal sampling rate of **10 Hz** (i.e., one sample vector every 100 ms) as a deliberate engineering trade-off.

This decision is justified by the response characteristics of the chemical sensing modalities that form the majority of the input feature vector. MEMS-based smoke, VOC, and CO sensors operate via electrochemical and metal-oxide transduction mechanisms whose physical T₉₀ response times typically range from several seconds to tens of seconds (Vorwerk et al., 2024). Sampling these channels at rates substantially exceeding 10 Hz yields no additional information content, as successive readings are highly auto-correlated and dominated by sensor time-constants rather than by underlying environmental dynamics (Vorwerk et al., 2024). The 10 Hz rate thus represents the practical upper bound imposed by the chemical sensor ensemble, ensuring that all channels within the fused input vector are acquired at a consistent, coherent cadence.

From a system-resource perspective, a 10 Hz sampling rate also aligns with the computational throughput of the Renesas RA4M1 (Cortex-M4 at 48 MHz) running the Edge Impulse inference engine. Samanta et al. (2024) demonstrated that reducing data acquisition rates on TinyML platforms can decrease RAM usage and inference latency by approximately 60–74% with minimal classification accuracy loss, confirming that conservative, application-matched sampling rates are a legitimate and effective optimization strategy for microcontroller-class deployments. The 10 Hz rate provides a 100 ms inter-sample interval that is comfortably shorter than the sub-second transient signatures associated with flaming combustion onset, while remaining well within the real-time budget required for continuous, non-blocking inference on the target hardware.

## 6.3.2 Window Size and Overlap Strategy

Once the per-sample cadence is established, the second critical parameter is the temporal window: the contiguous block of consecutive samples that is assembled into a single labeled instance and presented to the digital signal processing (DSP) block and subsequent classifier. Window sizing involves a fundamental trade-off between temporal context, feature richness, latency, and memory consumption (Samanta et al., 2024).

A **2-second window** (20 samples at 10 Hz) was selected as the primary inference window for this system. This duration was chosen based on two complementary considerations. First, a 2-second span captures sufficient temporal context to extract both time-domain statistical features (e.g., mean, root mean square, kurtosis) and frequency-domain features (e.g., spectral power in the 1–10 Hz flame-flicker band) from the IR channel with adequate frequency resolution. Deng et al. (2023) employed a 10-second window at a 10 Hz rate (100 samples) for their embedded fire detection CNN, demonstrating that windows of this order yield stable classification; however, that study employed a heavier model and higher-latency hardware than the present Arduino-class system. A shorter 2-second window reduces the time-to-first-detection latency — a critical factor in life-safety applications — while still encoding the dominant sub-second chemical transients and flame-flicker energy.

Second, the window length directly determines the RAM footprint of the inference buffer on the RA4M1. At 10 Hz, five sensor channels, and single-precision floating-point representation (4 bytes per value), a 2-second window occupies 20 × 5 × 4 = 400 bytes of working memory — a negligible fraction of the 128 KB SRAM available on the microcontroller, leaving ample headroom for the model weights, activation buffers, and firmware stack. Research on window size selection for time-series classification consistently underscores that windows must be long enough to encompass at least one complete cycle of the target phenomenon, but short enough that the underlying signal can be treated as quasi-stationary within the window (Samanta et al., 2024).

A **50% overlap** (i.e., a new inference is triggered every 1 second, with the preceding 1-second block retained and prepended to the next 1-second block of incoming samples) is employed to increase temporal coverage and reduce the expected worst-case detection latency. With 50% overlap, a fire event that begins mid-window will be fully enclosed within the subsequent overlapping window, capping the maximum detection latency at one window stride (1 second) rather than one full window length (2 seconds). This sliding-window approach is standard practice in embedded TinyML classification pipelines (Samanta et al., 2024) and is natively supported by the Edge Impulse DSP framework used for model training and deployment in this project.

For the purposes of **data collection** (as opposed to live inference), a longer **4-second window** (40 samples) with 50% overlap was used to enrich the training dataset with more temporal context per instance, consistent with the recommendation in the literature that slightly longer windows (4–5 seconds) improve the discriminability of slower, compound phenomena (Vorwerk et al., 2024). The resulting labeled training instances therefore carry richer gas-concentration trend information — particularly important for distinguishing the gradual CO and VOC rise of smoldering combustion from the abrupt VOC spike of a cooking false-alarm event — while the deployed inference window remains compact enough for sub-100 ms end-to-end latency on the target hardware.

---

## References

Deng, X., Shi, X., Wang, H., Wang, Q., Bao, J., & Chen, Z. (2023). An indoor fire detection method based on multi-sensor fusion and a lightweight convolutional neural network. _Sensors_, _23_(24), 9689. https://doi.org/10.3390/s23249689

Erden, F., Toreyin, B. U., Soyer, E. B., Inac, I., Gunay, O., Kose, K., & Cetin, A. E. (2012). Wavelet based flickering flame detector using differential PIR sensors. _Fire Safety Journal_, _53_, 13–18. https://doi.org/10.1016/j.firesaf.2012.06.006

Samanta, R., Saha, B., Ghosh, S. K., & Roy, R. B. (2024). _Optimizing TinyML: The impact of reduced data acquisition rates for time series classification on microcontrollers_ (arXiv:2409.10942). arXiv. https://doi.org/10.48550/arXiv.2409.10942

Vorwerk, P., Kelleter, J., Müller, S., & Krause, U. (2024). Classification in early fire detection using multi-sensor nodes — A transfer learning approach. _Sensors_, _24_(5), 1428. https://doi.org/10.3390/s24051428
