jimzord12/ai-fire-detection-arduino-system/thesis/typst/chapters/07_implementation_testing/sections/7_2_methodology/sections/6_3_sampling_parameters/glossary.md

**Sampling Frequency**: The number of samples per unit time taken from a continuous signal to make a discrete signal.
**Nyquist–Shannon Sampling Theorem**: A fundamental bridge between continuous-time signals and discrete-time signals, stating that a signal can be perfectly reconstructed if it is sampled at a rate greater than twice its highest frequency component.
**Window Size**: The duration of a signal segment used for a single inference or analysis.
**Overlap**: The portion of a sampling window that is shared with the previous or subsequent window.
**Inference Latency**: The time taken by a machine learning model to make a prediction after receiving the input data.
