jimzord12/ai-fire-detection-arduino-system/ref-validation-report.md

# Reference Validation Report

Generated on: 3/5/2026, 8:36:05 AM

## Summary
- **Total:** 53
- **Verified:** 38
- **Suspicious:** 6
- **Broken Links:** 9

### Confidence Levels
- High Confidence: 16
- Medium Confidence: 27
- Low Confidence: 10

## Detailed Findings

### 1. ⚠️ Advancements in fire and smoke detection for indoor and outdoor settings
- **Status:** suspicious
- **Confidence:** 🔴 low
- **Source:** crossref
- **Match Score:** 28.0%
- **Details:** Partial match found (Score: 28.0%).
- **Signals:** Year confirmed
- **Found Metadata:**
  - Title: Intra-hour photovoltaic power point-interval prediction using a dual-view deep neural network
  - Authors: Chen, Zhi-ru; Bai, Yu-long; Ding, Lin; Qin, Hao-yu; Bi, Qi
  - Year: 2025
  - Journal: Expert Systems with Applications
- **Original Text:** `@article{khan2025advancements,
  author = {Khan, R. A. and others},
  title = {Advancements in fire and smoke detection for indoor and outdoor settings},
  journal = {Expert Systems with Applications},
  year = {2025},
  volume = {260},
  pages = {125368},
  doi = {10.1016/j.eswa.2024.125368},
  url = {https://doi.org/10.1016/j.eswa.2024.125368}
}`

### 2. ⚠️ Multisensory Fusion Approaches for Accurate Smoke Detection in Smart Environments
- **Status:** suspicious
- **Confidence:** 🔴 low
- **Source:** crossref
- **Match Score:** 39.4%
- **Details:** Partial match found (Score: 39.4%).
- **Signals:** Year confirmed
- **Found Metadata:**
  - Title: Multi-modal detection of fetal movements using a wearable monitor
  - Authors: Ghosh, Abhishek K.; Catelli, Danilo S.; Wilson, Samuel; Nowlan, Niamh C.; Vaidyanathan, Ravi
  - Year: 2024
  - Journal: Information Fusion
- **Original Text:** `@article{pathan2024multisensory,
  author = {Pathan, M. S. and others},
  title = {Multisensory Fusion Approaches for Accurate Smoke Detection in Smart Environments},
  journal = {Information Fusion},
  year = {2024},
  volume = {103},
  pages = {102124},
  doi = {10.1016/j.inffus.2023.102124},
  url = {https://doi.org/10.1016/j.inffus.2023.102124}
}`

### 3. ✅ False alarms losses over \pounds1bn per year
- **Status:** verified
- **Confidence:** 🟡 medium
- **Source:** playwright
- **Match Score:** 85.3%
- **Details:** URL/DOI live and content matches. Best title match: "False alarms losses over £1bn per year..."
- **Signals:** URL/DOI accessible, Strong title match (>80%)
- **Found Metadata:**
  - Title: False alarms losses over £1bn per year
- **Original Text:** `@misc{bre2019false,
  author = {{BRE Group}},
  title = {False alarms losses over \pounds1bn per year},
  howpublished = {BRE Group News},
  month = {July},
  year = {2019},
  url = {https://bregroup.com/news/1bn-lost-false-fire-alarms}
}`

### 4. ✅ Economic Cost of Unwanted Automatic Fire Alarms: Final Report
- **Status:** verified
- **Confidence:** 🟡 medium
- **Source:** playwright
- **Match Score:** 70.3%
- **Details:** URL/DOI live and content matches. Best title match: "Economic Cost of Unwanted Automatic Fire Alarms: Final Repor..."
- **Signals:** URL/DOI accessible, Moderate title match (>50%)
- **Found Metadata:**
  - Title: Economic Cost of Unwanted Automatic Fire Alarms: Final Report: Submission to Fire + Rescue New South Wales (FRNSW)
  - Authors: Kathy Tannous
  - Year: 2020
- **Original Text:** `@techreport{wsu2019economic,
  author = {{Western Sydney University}},
  title = {Economic Cost of Unwanted Automatic Fire Alarms: Final Report},
  institution = {Fire + Rescue New South Wales (FRNSW)},
  month = {December},
  year = {2019},
  url = {https://researchers.westernsydney.edu.au/en/publications/economic-cost-of-unwanted-automatic-fire-alarms-final-report-subm}
}`

### 5. ✅ Real-time Smoke Detection With AI-based Sensor Fusion
- **Status:** verified
- **Confidence:** 🟡 medium
- **Source:** playwright
- **Match Score:** 100.0%
- **Details:** URL/DOI live and content matches. Best title match: "Real-time Smoke Detection With Ai-based Sensor Fusion..."
- **Signals:** URL/DOI accessible, Strong title match (>80%)
- **Found Metadata:**
  - Title: Real-time Smoke Detection With Ai-based Sensor Fusion
- **Original Text:** `@misc{singh2024realtime,
  author = {Singh, S.},
  title = {Real-time Smoke Detection With AI-based Sensor Fusion},
  howpublished = {Electromaker},
  month = {January},
  year = {2024},
  url = {https://www.electromaker.io/project/view/real-time-smoke-detection-with-ai-based-sensor-fusion}
}`

### 6. ⚠️ TinyML for Edge Intelligence
- **Status:** suspicious
- **Confidence:** 🔴 low
- **Source:** crossref
- **Match Score:** 69.6%
- **Details:** Partial match found (Score: 69.6%).
- **Signals:** Moderate title match (>60%)
- **Found Metadata:**
  - Title: TinyML for Edge Intelligence in IoT and LPWAN Networks
  - Year: 2024
- **Original Text:** `@article{nekhil2023fire,
  author = {Perez, J. and Smith, A.},
  title = {TinyML for Edge Intelligence},
  journal = {Journal of Sensors},
  year = {2023},
  volume = {10},
  number = {2},
  pages = {123-130},
  url = {https://docs.edgeimpulse.com/projects/expert-network/fire-detection-sensor-fusion-arduino-nano-33}
}`

### 7. ✅ Development of Fire Detection Technologies
- **Status:** verified
- **Confidence:** 🟢 high
- **Source:** crossref
- **Match Score:** 100.0%
- **Details:** High confidence match found in Crossref.
- **Signals:** DOI verified in Crossref, Strong title match (>80%), Year confirmed, 1 author(s) matched
- **Found Metadata:**
  - Title: Development of Fire Detection Technologies
  - Authors: El-afifi, Magda I; Team, SSAFR; M. Elkelany, Manar
  - Year: 2024
  - Journal: Nile Journal of Communication and Computer Science
- **Original Text:** `@article{elafifi2024development,
  author = {El-Afifi, M. I. and others},
  title = {Development of Fire Detection Technologies},
  journal = {Nile Journal of Communication and Computer Science (NJCCS)},
  year = {2024},
  volume = {7},
  number = {1},
  pages = {58--66},
  doi = {10.21608/njccs.2024.263103.1027},
  url = {https://doi.org/10.21608/njccs.2024.263103.1027}
}`

### 8. ✅ Report reveals 90\% of false fire alarms are caused by faulty apparatus
- **Status:** verified
- **Confidence:** 🟡 medium
- **Source:** playwright
- **Match Score:** 97.4%
- **Details:** URL/DOI live and content matches. Best title match: "Report reveals 90% of false fire alarms are caused by faulty..."
- **Signals:** URL/DOI accessible, Strong title match (>80%)
- **Found Metadata:**
  - Title: Report reveals 90% of false fire alarms are caused by faulty apparatus
- **Original Text:** `@misc{ifsj2022report,
  author = {{International Fire and Safety Journal}},
  title = {Report reveals 90\% of false fire alarms are caused by faulty apparatus},
  month = {October},
  year = {2022},
  url = {https://internationalfireandsafetyjournal.com/report-reveals-90-of-false-fire-alarms-are-caused-by-faulty-apparatus/}
}`

### 9. ❌ A fire alarm judgment method using multiple smoke alarms based on Bayesian estimation
- **Status:** broken_link
- **Confidence:** 🟢 high
- **Source:** playwright
- **Match Score:** 0.0%
- **Details:** Page loaded but content indicates it is missing (Found "not found" keywords). Title: "Error: DOI Not Found"
- **Signals:** Page indicates content is missing
- **Found Metadata:**
  - Title: Error: DOI Not Found
- **Original Text:** `@article{wang2023fire,
  author = {Wang, Z. and Zhang, J. and Liu, G. and Yuan, H. and Huang, L.},
  title = {A fire alarm judgment method using multiple smoke alarms based on Bayesian estimation},
  journal = {Fire Safety Journal},
  volume = {137},
  pages = {103767},
  year = {2023},
  doi = {10.1016/j.firesaf.2023.103767},
  url = {https://doi.org/10.1016/j.firesaf.2023.103767}
}`

### 10. ✅ TinyissimoYOLO: A quantized, low-memory footprint, TinyML object detection network for low power microcontrollers
- **Status:** verified
- **Confidence:** 🟡 medium
- **Source:** crossref
- **Match Score:** 100.0%
- **Details:** High confidence match found in Crossref.
- **Signals:** Strong title match (>80%), 4 author(s) matched
- **Found Metadata:**
  - Title: TinyissimoYOLO: A Quantized, Low-Memory Footprint, TinyML Object Detection Network for Low Power Microcontrollers
  - Authors: Moosmann, Julian; Giordano, Marco; Vogt, Christian; Magno, Michele
  - Year: 2023
  - Journal: 2023 IEEE 5th International Conference on Artificial Intelligence Circuits and Systems (AICAS)
- **Original Text:** `@misc{moosmann2024tinyissimoyolo,
  author = {Moosmann, J. and Giordano, M. and Vogt, C. and Magno, M.},
  title = {TinyissimoYOLO: A quantized, low-memory footprint, TinyML object detection network for low power microcontrollers},
  year = {2024},
  note = {arXiv:2306.00001},
  url = {https://arxiv.org/abs/2306.00001}
}`

### 11. ✅ Fire detection system using Arduino Nano 33 BLE and TinyML | Edge Impulse | PHP integration
- **Status:** verified
- **Confidence:** 🟡 medium
- **Source:** playwright
- **Match Score:** 100.0%
- **Details:** URL/DOI live and content matches. Best title match: "Fire Detection System using Arduino Nano 33 BLE and TinyML |..."
- **Signals:** URL/DOI accessible, Strong title match (>80%)
- **Found Metadata:**
  - Title: Fire Detection System using Arduino Nano 33 BLE and TinyML | Edge Impulse | PHP Integration
- **Original Text:** `@misc{rasimmax2024fire,
  author = {Rasimmax},
  title = {Fire detection system using Arduino Nano 33 BLE and TinyML | Edge Impulse | PHP integration},
  howpublished = {YouTube video},
  month = {June},
  year = {2024},
  url = {https://www.youtube.com/watch?v=FdQLSpr0g-E}
}`

### 12. ✅ Obscured wildfire flame detection by temporal analysis of smoke patterns captured by unmanned aerial systems
- **Status:** verified
- **Confidence:** 🟡 medium
- **Source:** playwright
- **Match Score:** 100.0%
- **Details:** URL/DOI live and content matches. Best title match: "Obscured Wildfire Flame Detection By Temporal Analysis of Sm..."
- **Signals:** URL/DOI accessible, Strong title match (>80%)
- **Found Metadata:**
  - Title: Obscured Wildfire Flame Detection By Temporal Analysis of Smoke Patterns Captured by Unmanned Aerial Systems
  - Authors: Meleti, Uma
- **Original Text:** `@misc{meleti2024obscured,
  author = {Meleti, U. and Razi, A.},
  title = {Obscured wildfire flame detection by temporal analysis of smoke patterns captured by unmanned aerial systems},
  year = {2024},
  note = {arXiv:2307.00104v2},
  url = {https://arxiv.org/abs/2307.00104}
}`

### 13. ❌ Classification in early fire detection using multi-sensor nodes---A study of the generalisability to unseen environments
- **Status:** broken_link
- **Confidence:** 🟢 high
- **Source:** playwright
- **Match Score:** 0.0%
- **Details:** Page loaded but content indicates it is missing (Found "not found" keywords). Title: "Access Denied"
- **Signals:** Page indicates content is missing
- **Found Metadata:**
  - Title: Access Denied
- **Original Text:** `@article{muller2024classification,
  author = {Müller, M. and Briesenick, J. and Behnke, K.},
  title = {Classification in early fire detection using multi-sensor nodes---A study of the generalisability to unseen environments},
  journal = {Sensors},
  volume = {24},
  number = {4},
  pages = {1319},
  year = {2024},
  doi = {10.3390/s24041319},
  url = {https://doi.org/10.3390/s24041319}
}`

### 14. ❌ Research on multi-sensor fusion indoor fire perception algorithm
- **Status:** broken_link
- **Confidence:** 🟢 high
- **Source:** playwright
- **Match Score:** 0.0%
- **Details:** Page loaded but content indicates it is missing (Found "not found" keywords). Title: "Access Denied"
- **Signals:** Page indicates content is missing
- **Found Metadata:**
  - Title: Access Denied
- **Original Text:** `@article{zheng2022research,
  author = {Zheng, Z. and Li, Y. and Chen, X.},
  title = {Research on multi-sensor fusion indoor fire perception algorithm},
  journal = {Sensors},
  volume = {22},
  number = {12},
  pages = {4524},
  year = {2022},
  doi = {10.3390/s22124524},
  url = {https://doi.org/10.3390/s22124524}
}`

### 15. ✅ From Tiny Machine Learning to Tiny Deep Learning: A Survey
- **Status:** verified
- **Confidence:** 🟢 high
- **Source:** crossref
- **Match Score:** 100.0%
- **Details:** High confidence match found in Crossref.
- **Signals:** DOI verified in Crossref, Strong title match (>80%), Year confirmed, 1 author(s) matched
- **Found Metadata:**
  - Title: From Tiny Machine Learning to Tiny Deep Learning: A Survey
  - Authors: Somvanshi, Shriyank; Islam, Md Monzurul; Chhetri, Gaurab; Chakraborty, Rohit; Mimi, Mahmuda Sultana; Shuvo, Sawgat Ahmed; Islam, Kazi Sifatul; Javed, Syed; Rafat, Sharif Ahmed; Dutta, Anandi; Das, Subasish
  - Year: 2025
  - Journal: ACM Computing Surveys
- **Original Text:** `@article{das2025tiny,
  author = {Das, S. and others},
  title = {From Tiny Machine Learning to Tiny Deep Learning: A Survey},
  journal = {ACM Computing Surveys},
  volume = {58},
  number = {7},
  pages = {168},
  year = {2025},
  doi = {10.1145/3776588},
  url = {https://doi.org/10.1145/3776588}
}`

### 16. ❌ Early fire detection system based on multi-sensor fusion and deep learning
- **Status:** broken_link
- **Confidence:** 🟢 high
- **Source:** playwright
- **Match Score:** 0.0%
- **Details:** Page loaded but content indicates it is missing (Found "not found" keywords). Title: "Access Denied"
- **Signals:** Page indicates content is missing
- **Found Metadata:**
  - Title: Access Denied
- **Original Text:** `@article{park2020early,
  author = {Park, J. and Kim, K. and Choi, S.},
  title = {Early fire detection system based on multi-sensor fusion and deep learning},
  journal = {Sensors},
  volume = {20},
  number = {22},
  pages = {6542},
  year = {2020},
  doi = {10.3390/s20226542},
  url = {https://doi.org/10.3390/s20226542}
}`

### 17. ✅ The PRISMA 2020 statement: An updated guideline for reporting systematic reviews
- **Status:** verified
- **Confidence:** 🟢 high
- **Source:** crossref
- **Match Score:** 100.0%
- **Details:** High confidence match found in Crossref.
- **Signals:** DOI verified in Crossref, Strong title match (>80%), Year confirmed, 1 author(s) matched
- **Found Metadata:**
  - Title: The PRISMA 2020 statement: an updated guideline for reporting systematic reviews
  - Authors: Page, Matthew J; McKenzie, Joanne E; Bossuyt, Patrick M; Boutron, Isabelle; Hoffmann, Tammy C; Mulrow, Cynthia D; Shamseer, Larissa; Tetzlaff, Jennifer M; Akl, Elie A; Brennan, Sue E; Chou, Roger; Glanville, Julie; Grimshaw, Jeremy M; Hróbjartsson, Asbjørn; Lalu, Manoj M; Li, Tianjing; Loder, Elizabeth W; Mayo-Wilson, Evan; McDonald, Steve; McGuinness, Luke A; Stewart, Lesley A; Thomas, James; Tricco, Andrea C; Welch, Vivian A; Whiting, Penny; Moher, David
  - Year: 2021
  - Journal: BMJ
- **Original Text:** `@article{page2021prisma,
  author = {Page, M. J. and others},
  title = {The PRISMA 2020 statement: An updated guideline for reporting systematic reviews},
  journal = {BMJ},
  volume = {372},
  pages = {n71},
  year = {2021},
  doi = {10.1136/bmj.n71},
  url = {https://doi.org/10.1136/bmj.n71}
}`

### 18. ✅ A fire alarm judgment method using multiple smoke alarms based on Bayesian estimation
- **Status:** verified
- **Confidence:** 🟢 high
- **Source:** semantic_scholar
- **Match Score:** 100.0%
- **Details:** Match found in Semantic Scholar.
- **Signals:** Found in Semantic Scholar, Strong title match (>80%), Year confirmed, DOI available
- **Found Metadata:**
  - Title: A fire alarm judgment method using multiple smoke alarms based on Bayesian estimation
  - Authors: Gang Liu; Hongyong Yuan; Lida Huang
  - Year: 2023
  - Journal: Fire safety journal
- **Original Text:** `@article{moghaddam2023fire,
  title={A fire alarm judgment method using multiple smoke alarms based on Bayesian estimation},
  author={Tavakkoli Moghaddam, E. and Ebadi, A. and Safarpour, H.},
  journal={Fire Safety Journal},
  volume={136},
  pages={103988},
  year={2023},
  doi={10.1016/j.firesaf.2023.103988},
  url={https://doi.org/10.1016/j.firesaf.2023.103988}
}`

### 19. ✅ Intelligent Fire Detection Systems Using Deep Learning and Multi-Sensor Data Fusion
- **Status:** verified
- **Confidence:** 🟢 high
- **Source:** playwright
- **Match Score:** 100.0%
- **Details:** PDF file is accessible and downloadable (HTTP 200).
- **Signals:** PDF URL accessible via HEAD request, Content-Type confirmed as PDF
- **Found Metadata:**
  - Title: Intelligent Fire Detection Systems Using Deep Learning and Multi-Sensor Data Fusion
- **Original Text:** `@article{srivastava2025intelligent,
  title={Intelligent Fire Detection Systems Using Deep Learning and Multi-Sensor Data Fusion},
  author={Srivastava, A. and others},
  journal={International Journal of Scientific Research in Engineering and Development},
  volume={8},
  number={5},
  year={2025},
  url={https://ijsred.com/volume8/issue5/IJSRED-V8I5P301.pdf}
}`

### 20. ⚠️ NFPA 72: National Fire Alarm and Signaling Code
- **Status:** suspicious
- **Confidence:** 🔴 low
- **Source:** crossref
- **Match Score:** 49.4%
- **Details:** Partial match found (Score: 49.4%).
- **Found Metadata:**
  - Title: National Fire Alarm Code Studies Development
  - Authors: Franz, Harry
  - Journal: 2006 Annual Conference &amp; Exposition Proceedings
- **Original Text:** `@article{nfpa2021code,
  title={NFPA 72: National Fire Alarm and Signaling Code},
  author={{National Fire Protection Association}},
  year={2021},
  url={https://www.nfpa.org/codes-and-standards/nfpa-72-standard-development/72}
}`

### 21. ❌ Gravity: I2C MEMS VOC Sensor - SGP40
- **Status:** broken_link
- **Confidence:** 🟢 high
- **Source:** playwright
- **Match Score:** 0.0%
- **Details:** Page loaded but content indicates it is missing (Found "not found" keywords). Title: "Not Found - DFRobot Wiki"
- **Signals:** Page indicates content is missing
- **Found Metadata:**
  - Title: Not Found - DFRobot Wiki
- **Original Text:** `@misc{dfrobot2022sgp40,
  title={Gravity: I2C MEMS VOC Sensor - SGP40},
  author={{DFRobot}},
  year={2022},
  url={https://wiki.dfrobot.com/SKU_SEN0465_Gravity_MEMS_VOC_Sensor_SGP40}
}`

### 22. ✅ Research on fire detection technology based on image processing
- **Status:** verified
- **Confidence:** 🔴 low
- **Source:** crossref
- **Match Score:** 88.7%
- **Details:** High confidence match found in Crossref.
- **Signals:** Strong title match (>80%)
- **Found Metadata:**
  - Title: Fire Detection Technology Based on Infrared Image Processing
  - Authors: Liu, Xiao Jun
  - Year: 2013
  - Journal: Applied Mechanics and Materials
- **Original Text:** `@article{wang2017research,
  title={Research on fire detection technology based on image processing},
  author={Wang, Y. and Wang, Y.},
  journal={International Journal of Signal Processing, Image Processing and Pattern Recognition},
  volume={10},
  number={5},
  pages={183--194},
  year={2017},
  url={http://dx.doi.org/10.14257/ijsip.2017.10.5.17}
}`

### 23. ✅ A review of data fusion techniques
- **Status:** verified
- **Confidence:** 🟡 medium
- **Source:** crossref
- **Match Score:** 100.0%
- **Details:** High confidence match found in Crossref.
- **Signals:** Strong title match (>80%), Year confirmed, 1 author(s) matched
- **Found Metadata:**
  - Title: A Review of Data Fusion Techniques
  - Authors: Castanedo, Federico
  - Year: 2013
  - Journal: The Scientific World Journal
- **Original Text:** `@article{castanedo2013review,
  title={A review of data fusion techniques},
  author={Castanedo, F.},
  journal={The Scientific World Journal},
  volume={2013},
  year={2013},
  publisher={Hindawi},
  url={https://doi.org/10.1155/2013/704504}
}`

### 24. ✅ A new approach to linear filtering and prediction problems
- **Status:** verified
- **Confidence:** 🟡 medium
- **Source:** crossref
- **Match Score:** 100.0%
- **Details:** High confidence match found in Crossref.
- **Signals:** Strong title match (>80%), Year confirmed, 1 author(s) matched
- **Found Metadata:**
  - Title: A New Approach to Linear Filtering and Prediction Problems
  - Authors: Kalman, R. E.
  - Year: 1960
  - Journal: Journal of Basic Engineering
- **Original Text:** `@article{kalman1960new,
  title={A new approach to linear filtering and prediction problems},
  author={Kalman, R. E.},
  journal={Journal of Basic Engineering},
  volume={82},
  number={1},
  pages={35--45},
  year={1960},
  url={https://doi.org/10.1115/1.3662552}
}`

### 25. ✅ An introduction to the Kalman filter
- **Status:** verified
- **Confidence:** 🟢 high
- **Source:** playwright
- **Match Score:** 100.0%
- **Details:** PDF file is accessible and downloadable (HTTP 200).
- **Signals:** PDF URL accessible via HEAD request, Content-Type confirmed as PDF, File size: 0.17 MB
- **Found Metadata:**
  - Title: An introduction to the Kalman filter
- **Original Text:** `@techreport{welch2006introduction,
  title={An introduction to the Kalman filter},
  author={Welch, G. and Bishop, G.},
  institution={University of North Carolina at Chapel Hill},
  year={2006},
  url={https://www.cs.unc.edu/~welch/media/pdf/kalman_intro.pdf}
}`

### 26. ✅ Multisensor data fusion
- **Status:** verified
- **Confidence:** 🔴 low
- **Source:** crossref
- **Match Score:** 100.0%
- **Details:** High confidence match found in Crossref.
- **Signals:** Strong title match (>80%)
- **Found Metadata:**
  - Title: Multisensor Data Fusion
  - Authors: Varshney, Pramod K.
  - Year: 2000
  - Journal: Lecture Notes in Computer Science
- **Original Text:** `@incollection{durrant2008multisensor,
  title={Multisensor data fusion},
  author={Durrant-Whyte, H. and Henderson, T. C.},
  booktitle={Springer Handbook of Robotics},
  pages={585--614},
  year={2008},
  publisher={Springer},
  url={https://doi.org/10.1007/978-3-540-30301-5_25}
}`

### 27. ✅ Deep learning
- **Status:** verified
- **Confidence:** 🔴 low
- **Source:** crossref
- **Match Score:** 100.0%
- **Details:** High confidence match found in Crossref.
- **Signals:** Strong title match (>80%)
- **Found Metadata:**
  - Title: Deep Learning
  - Authors: Kumar, Sunil
  - Year: 2024
  - Journal: Python for Accounting and Finance
- **Original Text:** `@article{lecun2015deep,
  title={Deep learning},
  author={LeCun, Y. and Bengio, Y. and Hinton, G.},
  journal={Nature},
  volume={521},
  number={7553},
  pages={436--444},
  year={2015},
  url={https://doi.org/10.1038/nature14539}
}`

### 28. ❌ TinyML: Machine Learning with TensorFlow Lite on Arduino and Ultra-Low-Power Microcontrollers
- **Status:** broken_link
- **Confidence:** 🟢 high
- **Source:** playwright
- **Match Score:** 0.0%
- **Details:** Page loaded but content indicates it is missing (Found "not found" keywords). Title: "O'Reilly Media - Technology and Business Training"
- **Signals:** Page indicates content is missing
- **Found Metadata:**
  - Title: O'Reilly Media - Technology and Business Training
- **Original Text:** `@book{warden2019tinyml,
  title={TinyML: Machine Learning with TensorFlow Lite on Arduino and Ultra-Low-Power Microcontrollers},
  author={Warden, P. and Situnayake, D.},
  year={2019},
  publisher={O'Reilly Media},
  url={https://www.oreilly.com/library/view/tinyml/9781492053125/}
}`

### 29. ✅ Quantization and training of neural networks for efficient integer-arithmetic-only inference
- **Status:** verified
- **Confidence:** 🟡 medium
- **Source:** crossref
- **Match Score:** 100.0%
- **Details:** High confidence match found in Crossref.
- **Signals:** Strong title match (>80%), Year confirmed, 1 author(s) matched
- **Found Metadata:**
  - Title: Quantization and Training of Neural Networks for Efficient Integer-Arithmetic-Only Inference
  - Authors: Jacob, Benoit; Kligys, Skirmantas; Chen, Bo; Zhu, Menglong; Tang, Matthew; Howard, Andrew; Adam, Hartwig; Kalenichenko, Dmitry
  - Year: 2018
  - Journal: 2018 IEEE/CVF Conference on Computer Vision and Pattern Recognition
- **Original Text:** `@inproceedings{jacob2018quantization,
  title={Quantization and training of neural networks for efficient integer-arithmetic-only inference},
  author={Jacob, B. and others},
  booktitle={Proceedings of the IEEE Conference on Computer Vision and Pattern Recognition},
  pages={2704--2713},
  year={2018},
  url={https://openaccess.thecvf.com/content_cvpr_2018/html/Jacob_Quantization_and_Training_CVPR_2018_paper.html}
}`

### 30. ⚠️ Web-based cloud platform for managing fire safety in buildings
- **Status:** suspicious
- **Confidence:** 🔴 low
- **Source:** crossref
- **Match Score:** 54.8%
- **Details:** Partial match found (Score: 54.8%).
- **Found Metadata:**
  - Title: Fire Safety in Buildings
  - Authors: Walls, Kelvin L
  - Year: 2012
  - Journal: Jurnal Teknologi
- **Original Text:** `@article{chou2017web,
  title={Web-based cloud platform for managing fire safety in buildings},
  author={Chou, J. S. and others},
  journal={Computer-Aided Civil and Infrastructure Engineering},
  volume={32},
  number={6},
  pages={464--482},
  year={2017},
  url={https://doi.org/10.1111/mice.12259}
}`

### 31. ❌ Fermion: MEMS Smoke Sensor - SEN0570 Datasheet
- **Status:** broken_link
- **Confidence:** 🟢 high
- **Source:** playwright
- **Match Score:** 0.0%
- **Details:** Page loaded but content indicates it is missing (Found "not found" keywords). Title: "Not Found - DFRobot Wiki"
- **Signals:** Page indicates content is missing
- **Found Metadata:**
  - Title: Not Found - DFRobot Wiki
- **Original Text:** `@misc{dfrobot2024smoke,
  title={Fermion: MEMS Smoke Sensor - SEN0570 Datasheet},
  author={{DFRobot}},
  year={2024},
  howpublished={\url{https://wiki.dfrobot.com/SKU_SEN0570_Fermion_MEMS_Smoke_Sensor}},
  note={Accessed: February 2026},
  url = {https://wiki.dfrobot.com/SKU_SEN0570_Fermion_MEMS_Smoke_Sensor}
}`

### 32. ❌ Fermion: MEMS VOC Gas Sensor - SEN0566 Datasheet
- **Status:** broken_link
- **Confidence:** 🟢 high
- **Source:** playwright
- **Match Score:** 0.0%
- **Details:** Page loaded but content indicates it is missing (Found "not found" keywords). Title: "Not Found - DFRobot Wiki"
- **Signals:** Page indicates content is missing
- **Found Metadata:**
  - Title: Not Found - DFRobot Wiki
- **Original Text:** `@misc{dfrobot2024voc,
  title={Fermion: MEMS VOC Gas Sensor - SEN0566 Datasheet},
  author={{DFRobot}},
  year={2024},
  howpublished={\url{https://wiki.dfrobot.com/SKU_SEN0566_Fermion_MEMS_VOC_Gas_Sensor}},
  note={Accessed: February 2026},
  url = {https://wiki.dfrobot.com/SKU_SEN0566_Fermion_MEMS_VOC_Gas_Sensor}
}`

### 33. ❌ Fermion: MEMS CO Gas Sensor (1-1000ppm) - SEN0564 Datasheet
- **Status:** broken_link
- **Confidence:** 🟢 high
- **Source:** playwright
- **Match Score:** 0.0%
- **Details:** Page loaded but content indicates it is missing (Found "not found" keywords). Title: "Not Found - DFRobot Wiki"
- **Signals:** Page indicates content is missing
- **Found Metadata:**
  - Title: Not Found - DFRobot Wiki
- **Original Text:** `@misc{dfrobot2024co,
  title={Fermion: MEMS CO Gas Sensor (1-1000ppm) - SEN0564 Datasheet},
  author={{DFRobot}},
  year={2024},
  howpublished={\url{https://wiki.dfrobot.com/SKU_SEN0564_Fermion_MEMS_CO_Gas_Sensor}},
  note={Accessed: February 2026},
  url = {https://wiki.dfrobot.com/SKU_SEN0564_Fermion_MEMS_CO_Gas_Sensor}
}`

### 34. ✅ Chemical sensor systems and associated algorithms for fire detection: A review
- **Status:** verified
- **Confidence:** 🟡 medium
- **Source:** crossref
- **Match Score:** 100.0%
- **Details:** High confidence match found in Crossref.
- **Signals:** Strong title match (>80%), Year confirmed, 1 author(s) matched
- **Found Metadata:**
  - Title: Chemical Sensor Systems and Associated Algorithms for Fire Detection: A Review
  - Authors: Fonollosa, Jordi; Solórzano, Ana; Marco, Santiago
  - Year: 2018
  - Journal: Sensors
- **Original Text:** `@article{fonollosa2018chemical,
  title={Chemical sensor systems and associated algorithms for fire detection: A review},
  author={Fonollosa, J. and Sol{\'o}rzano, A. and Marco, S.},
  journal={Sensors},
  volume={18},
  number={2},
  pages={553},
  year={2018},
  publisher={MDPI},
  url = {https://doi.org/10.3390/s18020553}
}`

### 35. ✅ A multi-sensor fire detection method based on trend predictive BiLSTM networks
- **Status:** verified
- **Confidence:** 🟡 medium
- **Source:** crossref
- **Match Score:** 100.0%
- **Details:** High confidence match found in Crossref.
- **Signals:** Strong title match (>80%), Year confirmed, 3 author(s) matched
- **Found Metadata:**
  - Title: A Multi-Sensor Fire Detection Method based on Trend Predictive BiLSTM Networks
  - Authors: Kim, Gyu-Li; Ro, Seong-Jun; Lee, Kwangjae
  - Year: 2024
  - Journal: JOURNAL OF SENSOR SCIENCE AND TECHNOLOGY
- **Original Text:** `@article{kim2024multi,
  title={A multi-sensor fire detection method based on trend predictive BiLSTM networks},
  author={Kim, G. L. and Ro, S. J. and Lee, K.},
  journal={Journal of Sensor Science and Technology},
  volume={33},
  number={5},
  pages={248--254},
  year={2024},
  url = {https://doi.org/10.46670/JSST.2024.33.5.248}
}`

### 36. ✅ Classification in early fire detection using multi-sensor nodes—A transfer learning approach
- **Status:** verified
- **Confidence:** 🟡 medium
- **Source:** crossref
- **Match Score:** 100.0%
- **Details:** High confidence match found in Crossref.
- **Signals:** Strong title match (>80%), Year confirmed, 2 author(s) matched
- **Found Metadata:**
  - Title: Classification in Early Fire Detection Using Multi-Sensor Nodes—A Transfer Learning Approach
  - Authors: Vorwerk, Pascal; Kelleter, Jörg; Müller, Steffen; Krause, Ulrich
  - Year: 2024
  - Journal: Sensors
- **Original Text:** `@article{vorwerk2024classification,
  title={Classification in early fire detection using multi-sensor nodes—A transfer learning approach},
  author={Vorwerk, P. and Kelleter, J. and M{\"u}ller, S. and Krause, U.},
  journal={Sensors},
  volume={24},
  number={5},
  pages={1428},
  year={2024},
  publisher={MDPI},
  url = {https://doi.org/10.3390/s24051428}
}`

### 37. ✅ Multi-stage feature selection based intelligent classifier for classification of incipient stage fire in building
- **Status:** verified
- **Confidence:** 🟡 medium
- **Source:** crossref
- **Match Score:** 100.0%
- **Details:** High confidence match found in Crossref.
- **Signals:** Strong title match (>80%), Year confirmed, 1 author(s) matched
- **Found Metadata:**
  - Title: Multi-Stage Feature Selection Based Intelligent Classifier for Classification of Incipient Stage Fire in Building
  - Authors: Andrew, Allan; Zakaria, Ammar; Mad Saad, Shaharil; Md Shakaff, Ali
  - Year: 2016
  - Journal: Sensors
- **Original Text:** `@article{zakaria2016multi,
  title={Multi-stage feature selection based intelligent classifier for classification of incipient stage fire in building},
  author={Zakaria, A. and Shakaff, A. Y. M. and Saad, S. M. and Adom, A. H.},
  journal={Sensors},
  volume={16},
  number={1},
  pages={31},
  year={2016},
  publisher={MDPI},
  url = {https://doi.org/10.3390/s16010031}
}`

### 38. ✅ Multi-sensor data fusion algorithm for indoor fire early warning based on BP neural network
- **Status:** verified
- **Confidence:** 🟡 medium
- **Source:** crossref
- **Match Score:** 100.0%
- **Details:** High confidence match found in Crossref.
- **Signals:** Strong title match (>80%), Year confirmed, 3 author(s) matched
- **Found Metadata:**
  - Title: Multi-Sensor Data Fusion Algorithm for Indoor Fire Early Warning Based on BP Neural Network
  - Authors: Wu, Lesong; Chen, Lan; Hao, Xiaoran
  - Year: 2021
  - Journal: Information
- **Original Text:** `@article{wu2021multi,
  title={Multi-sensor data fusion algorithm for indoor fire early warning based on BP neural network},
  author={Wu, L. and Chen, L. and Hao, X.},
  journal={Information},
  volume={12},
  number={2},
  pages={59},
  year={2021},
  publisher={MDPI},
  url = {https://doi.org/10.3390/info12020059}
}`

### 39. ✅ Edge Impulse Documentation
- **Status:** verified
- **Confidence:** 🟡 medium
- **Source:** playwright
- **Match Score:** 100.0%
- **Details:** URL/DOI live and content matches. Best title match: "Edge Impulse Documentation..."
- **Signals:** URL/DOI accessible, Strong title match (>80%)
- **Found Metadata:**
  - Title: Edge Impulse Documentation
- **Original Text:** `@misc{edgeimpulse2024,
  title={Edge Impulse Documentation},
  author={{Edge Impulse}},
  year={2024},
  howpublished={\url{https://docs.edgeimpulse.com/}},
  note={Accessed: February 2026},
  url = {https://docs.edgeimpulse.com/}
}`

### 40. ✅ Arduino UNO R4 WiFi Product Documentation
- **Status:** verified
- **Confidence:** 🟡 medium
- **Source:** playwright
- **Match Score:** 84.4%
- **Details:** URL/DOI live and content matches. Best title match: "UNO R4 WiFi | Arduino Documentation..."
- **Signals:** URL/DOI accessible, Strong title match (>80%)
- **Found Metadata:**
  - Title: UNO R4 WiFi | Arduino Documentation
- **Original Text:** `@misc{arduino2024,
  title={Arduino UNO R4 WiFi Product Documentation},
  author={{Arduino}},
  year={2024},
  howpublished={\url{https://docs.arduino.cc/hardware/uno-r4-wifi}},
  note={Accessed: February 2026},
  url = {https://docs.arduino.cc/hardware/uno-r4-wifi}
}`

### 41. ✅ Recent advances in sensors for fire detection
- **Status:** verified
- **Confidence:** 🟡 medium
- **Source:** crossref
- **Match Score:** 100.0%
- **Details:** High confidence match found in Crossref.
- **Signals:** Strong title match (>80%), Year confirmed, 6 author(s) matched
- **Found Metadata:**
  - Title: Recent Advances in Sensors for Fire Detection
  - Authors: Khan, Fawad; Xu, Zhiguang; Sun, Junling; Khan, Fazal Maula; Ahmed, Adnan; Zhao, Yan
  - Year: 2022
  - Journal: Sensors
- **Original Text:** `@article{khan2022recent,
  title={Recent advances in sensors for fire detection},
  author={Khan, F. and Xu, Z. and Sun, J. and Khan, F. M. and Ahmed, A. and Zhao, Y.},
  journal={Sensors},
  volume={22},
  number={9},
  pages={3310},
  year={2022},
  publisher={MDPI},
  url = {https://doi.org/10.3390/s22093310}
}`

### 42. ✅ Research on multi-sensor fusion indoor fire perception algorithm based on improved TCN
- **Status:** verified
- **Confidence:** 🟡 medium
- **Source:** crossref
- **Match Score:** 100.0%
- **Details:** High confidence match found in Crossref.
- **Signals:** Strong title match (>80%), Year confirmed, 4 author(s) matched
- **Found Metadata:**
  - Title: Research on Multi-Sensor Fusion Indoor Fire Perception Algorithm Based on Improved TCN
  - Authors: Li, Yang; Su, Yanmang; Zeng, Xiangye; Wang, Jingyi
  - Year: 2022
  - Journal: Sensors
- **Original Text:** `@article{li2022research,
  title={Research on multi-sensor fusion indoor fire perception algorithm based on improved TCN},
  author={Li, Y. and Su, Y. and Zeng, X. and Wang, J.},
  journal={Sensors},
  volume={22},
  number={12},
  pages={4550},
  year={2022},
  publisher={MDPI},
  url = {https://doi.org/10.3390/s22124550}
}`

### 43. ✅ Early fire detection based on gas sensor arrays: Multivariate calibration and validation
- **Status:** verified
- **Confidence:** 🔴 low
- **Source:** crossref
- **Match Score:** 100.0%
- **Details:** High confidence match found in Crossref.
- **Signals:** Strong title match (>80%)
- **Found Metadata:**
  - Title: Early fire detection based on gas sensor arrays: Multivariate calibration and validation
  - Authors: Solórzano, Ana; Eichmann, Jens; Fernández, Luis; Ziems, Bernd; Jiménez-Soto, Juan Manuel; Marco, Santiago; Fonollosa, Jordi
  - Year: 2022
  - Journal: Sensors and Actuators B: Chemical
- **Original Text:** `@article{solorzano2021early,
  title={Early fire detection based on gas sensor arrays: Multivariate calibration and validation},
  author={Sol{\'o}rzano, A. and others},
  journal={Sensors and Actuators B: Chemical},
  volume={352},
  pages={130961},
  year={2021},
  publisher={Elsevier},
  url = {https://doi.org/10.1016/j.snb.2021.130961}
}`

### 44. ✅ An indoor fire detection method based on multi-sensor fusion and a lightweight convolutional neural network
- **Status:** verified
- **Confidence:** 🟡 medium
- **Source:** crossref
- **Match Score:** 100.0%
- **Details:** High confidence match found in Crossref.
- **Signals:** Strong title match (>80%), Year confirmed, 1 author(s) matched
- **Found Metadata:**
  - Title: An Indoor Fire Detection Method Based on Multi-Sensor Fusion and a Lightweight Convolutional Neural Network
  - Authors: Deng, Xinwei; Shi, Xuewei; Wang, Haosen; Wang, Qianli; Bao, Jun; Chen, Zhuming
  - Year: 2023
  - Journal: Sensors
- **Original Text:** `@article{deng2023indoor,
  title={An indoor fire detection method based on multi-sensor fusion and a lightweight convolutional neural network},
  author={Deng, X. and others},
  journal={Sensors},
  volume={23},
  number={24},
  pages={9689},
  year={2023},
  publisher={MDPI},
  url = {https://doi.org/10.3390/s23249689}
}`

### 45. ✅ Optimizing TinyML: The impact of reduced data acquisition rates for time series classification on microcontrollers
- **Status:** verified
- **Confidence:** 🟡 medium
- **Source:** playwright
- **Match Score:** 100.0%
- **Details:** URL/DOI live and content matches. Best title match: "Optimizing TinyML: The Impact of Reduced Data Acquisition Ra..."
- **Signals:** URL/DOI accessible, Strong title match (>80%)
- **Found Metadata:**
  - Title: Optimizing TinyML: The Impact of Reduced Data Acquisition Rates for Time Series Classification on Microcontrollers
  - Authors: Samanta, Riya
- **Original Text:** `@article{samanta2024optimizing,
  title={Optimizing TinyML: The impact of reduced data acquisition rates for time series classification on microcontrollers},
  author={Samanta, R. and others},
  journal={arXiv preprint arXiv:2409.10942},
  year={2024},
  url = {https://doi.org/10.48550/arXiv.2409.10942}
}`

### 46. ✅ TinyML: Enabling of inference deep learning models on ultra-low-power IoT edge devices for AI applications
- **Status:** verified
- **Confidence:** 🟡 medium
- **Source:** crossref
- **Match Score:** 100.0%
- **Details:** High confidence match found in Crossref.
- **Signals:** Strong title match (>80%), Year confirmed, 2 author(s) matched
- **Found Metadata:**
  - Title: TinyML: Enabling of Inference Deep Learning Models on Ultra-Low-Power IoT Edge Devices for AI Applications
  - Authors: Alajlan, Norah N.; Ibrahim, Dina M.
  - Year: 2022
  - Journal: Micromachines
- **Original Text:** `@article{alajlan2022tinyml,
  title={TinyML: Enabling of inference deep learning models on ultra-low-power IoT edge devices for AI applications},
  author={Alajlan, N. N. and Ibrahim, D. M.},
  journal={Micromachines},
  volume={13},
  number={6},
  pages={851},
  year={2022},
  publisher={MDPI},
  url = {https://doi.org/10.3390/mi13060851}
}`

### 47. ✅ Edge Impulse: An MLOps platform for tiny machine learning
- **Status:** verified
- **Confidence:** 🟢 high
- **Source:** playwright
- **Match Score:** 100.0%
- **Details:** PDF file is accessible and downloadable (HTTP 200).
- **Signals:** PDF URL accessible via HEAD request, Content-Type confirmed as PDF, File size: 0.83 MB
- **Found Metadata:**
  - Title: Edge Impulse: An MLOps platform for tiny machine learning
- **Original Text:** `@article{hymel2023edge,
  title={Edge Impulse: An MLOps platform for tiny machine learning},
  author={Hymel, S. and others},
  journal={Proceedings of Machine Learning and Systems},
  volume={5},
  pages={1--18},
  year={2023},
  url = {https://proceedings.mlsys.org/paper_files/paper/2023/file/49fe55f5e9574714dda575bfb2177662-Paper-mlsys2023.pdf}
}`

### 48. ✅ Quantization and deployment of deep neural networks on microcontrollers
- **Status:** verified
- **Confidence:** 🟡 medium
- **Source:** crossref
- **Match Score:** 100.0%
- **Details:** High confidence match found in Crossref.
- **Signals:** Strong title match (>80%), Year confirmed, 1 author(s) matched
- **Found Metadata:**
  - Title: Quantization and Deployment of Deep Neural Networks on Microcontrollers
  - Authors: Novac, Pierre-Emmanuel; Boukli Hacene, Ghouthi; Pegatoquet, Alain; Miramond, Benoît; Gripon, Vincent
  - Year: 2021
  - Journal: Sensors
- **Original Text:** `@article{novac2021quantization,
  title={Quantization and deployment of deep neural networks on microcontrollers},
  author={Novac, P. E. and others},
  journal={Sensors},
  volume={21},
  number={9},
  pages={2984},
  year={2021},
  publisher={MDPI},
  url = {https://doi.org/10.3390/s21092984}
}`

### 49. ✅ Hybrid feature fusion-based high-sensitivity fire detection and early warning for intelligent building systems
- **Status:** verified
- **Confidence:** 🟡 medium
- **Source:** crossref
- **Match Score:** 100.0%
- **Details:** High confidence match found in Crossref.
- **Signals:** Strong title match (>80%), Year confirmed, 1 author(s) matched
- **Found Metadata:**
  - Title: Hybrid Feature Fusion-Based High-Sensitivity Fire Detection and Early Warning for Intelligent Building Systems
  - Authors: Xiao, Shengyuan; Wang, Shuo; Ge, Liang; Weng, Hengxiang; Fang, Xin; Peng, Zhenming; Zeng, Wen
  - Year: 2023
  - Journal: Sensors
- **Original Text:** `@article{xiao2023hybrid,
  title={Hybrid feature fusion-based high-sensitivity fire detection and early warning for intelligent building systems},
  author={Xiao, S. and others},
  journal={Sensors},
  volume={23},
  number={2},
  pages={859},
  year={2023},
  publisher={MDPI},
  url = {https://doi.org/10.3390/s23020859}
}`

### 50. ✅ Performance characterization of using quantization for DNN inference on edge devices: Extended version
- **Status:** verified
- **Confidence:** 🟡 medium
- **Source:** crossref
- **Match Score:** 90.1%
- **Details:** High confidence match found in Crossref.
- **Signals:** Strong title match (>80%), Year confirmed
- **Found Metadata:**
  - Title: Performance Characterization of Using Quantization for DNN Inference on Edge Devices
  - Authors: Ahn, Hyunho; Chen, Tian; Alnaasan, Nawras; Shafi, Aamir; Abduljabbar, Mustafa; Subramoni, Hari; Panda, Dhabaleswar K.
  - Year: 2023
  - Journal: 2023 IEEE 7th International Conference on Fog and Edge Computing (ICFEC)
- **Original Text:** `@article{amara2023performance,
  title={Performance characterization of using quantization for DNN inference on edge devices: Extended version},
  author={Amara, M. and others},
  journal={arXiv preprint arXiv:2303.05016},
  year={2023},
  url = {https://doi.org/10.48550/arXiv.2303.05016}
}`

### 51. ⚠️ Arduino UNO R4 WiFi datasheet (ABX00087)
- **Status:** suspicious
- **Confidence:** 🔴 low
- **Source:** crossref
- **Match Score:** 48.1%
- **Details:** Partial match found (Score: 48.1%).
- **Found Metadata:**
  - Title: Chess with Arduino UNO R4
  - Authors: Miglino, Enrico
  - Year: 2024
  - Journal: Maker Innovations Series
- **Original Text:** `@misc{arduino2023,
  title={Arduino UNO R4 WiFi datasheet (ABX00087)},
  author={{Arduino LLC}},
  year={2023},
  howpublished={\url{https://docs.arduino.cc/resources/datasheets/ABX00087-datasheet.pdf}}
}`

### 52. ✅ A fault tolerant surveillance system for fire detection and monitoring
- **Status:** verified
- **Confidence:** 🟡 medium
- **Source:** playwright
- **Match Score:** 74.3%
- **Details:** URL/DOI live and content matches. Best title match: "A Fault Tolerant Surveillance System for Fire Detection and ..."
- **Signals:** URL/DOI accessible, Moderate title match (>50%), Year confirmed
- **Found Metadata:**
  - Title: A Fault Tolerant Surveillance System for Fire Detection and Prevention Using LoRaWAN in Smart Buildings
  - Authors: Abdullah Safi
  - Year: 2022 Nov 1
- **Original Text:** `@article{arshad2022fault,
  title={A fault tolerant surveillance system for fire detection and monitoring},
  author={Arshad, J. and others},
  journal={Sensors},
  volume={22},
  number={11},
  pages={4108},
  year={2022},
  publisher={MDPI},
  url = {https://pmc.ncbi.nlm.nih.gov/articles/PMC9657799/}
}`

### 53. ✅ Contributions to the development of fire detection and alarm systems
- **Status:** verified
- **Confidence:** 🟡 medium
- **Source:** playwright
- **Match Score:** 61.2%
- **Details:** URL/DOI live and content matches. Best title match: "Contributions to the Development of Fire Detection and Inter..."
- **Signals:** URL/DOI accessible, Moderate title match (>50%), Year confirmed
- **Found Metadata:**
  - Title: Contributions to the Development of Fire Detection and Intervention Capabilities Using an Indoor Air Quality IoT Monitoring System
  - Authors: Radu Nicolae Pietraru
  - Year: 2025 Oct 15
- **Original Text:** `@article{pfeifer2025contributions,
  title={Contributions to the development of fire detection and alarm systems},
  author={Pfeifer, T. and others},
  journal={Sensors},
  volume={25},
  year={2025},
  publisher={MDPI},
  url = {https://pmc.ncbi.nlm.nih.gov/articles/PMC12568056/}
}`
