jimzord12/ai-fire-detection-arduino-system/.gemini/v1/cli-tools/ref-tools/test-report.md

# Reference Validation Report

Generated on: 12/27/2025, 5:24:11 PM

## Summary
- Total: 6
- Verified: 4
- Suspicious: 1
- Broken Links: 1

## Detailed Findings

### 1. ✅ Abu Dhabi Ports launches blockchain technology for trade community
- **Status:** verified
- **Source:** playwright
- **Match Score:** 89.1%
- **Details:** URL/DOI live and title matches browser page title.
- **Found Metadata:**
  - Title: Abu Dhabi Ports launches blockchain technology for trade community | Abu Dhabi Ports
  - Authors: admin
- **Original Text:** `Abu Dhabi Ports. (2018, June 2). Abu Dhabi Ports launches blockchain technology for trade community. https://www.adports.ae/abu-dhabi-ports-launches-blockchain-technology-for-trade-community/ (Exists!)`

### 2. ❌ Towards automatic anomaly detection in fisheries using deep learning
- **Status:** broken_link
- **Source:** playwright
- **Match Score:** 0.0%
- **Details:** Page loaded but content indicates it is missing (Found "not found" keywords). Title: "Error: DOI Not Found"
- **Found Metadata:**
  - Title: Error: DOI Not Found
- **Original Text:** `Acharya, D., Palani, S., & Kumar, S. (2024). Towards automatic anomaly detection in fisheries using deep learning. Fisheries Research, 273, 106777. https://doi.org/10.1016/j.fishres.2024.106777 (DOI not found)`

### 3. ✅ Ship’s Digital Twin—A Review of Modelling Challenges and Applications
- **Status:** verified
- **Source:** crossref
- **Match Score:** 100.0%
- **Details:** High confidence match found in Crossref.
- **Found Metadata:**
  - Title: Ship’s Digital Twin—A Review of Modelling Challenges and Applications
  - Authors: Assani, Nur; Matić, Petar; Katalinić, Marko
  - Year: 2022
- **Original Text:** `Assani, N., Matic, P., & Katalinic, M. (2022). Ship’s Digital Twin—A Review of Modelling Challenges and Applications. Applied Sciences, 12(12), 6039. https://doi.org/10.3390/app12126039 (Exists!)`

### 4. ✅ Revolutionary biodegradable sensors are changing how we monitor Ocean Health
- **Status:** verified
- **Source:** playwright
- **Match Score:** 80.5%
- **Details:** URL/DOI live and title matches browser page title.
- **Found Metadata:**
  - Title: Revolutionary Biodegradable Sensors Are Changing How We Monitor Ocean Health - Marine Biodiversity Science Center
  - Authors: jessica
- **Original Text:** `Ava Singh, (2025, April 16). Revolutionary biodegradable sensors are changing how we monitor Ocean Health. Marine Biodiversity Science Center. http://www.marinebiodiversity.ca/revolutionary-biodegradable-sensors-are-changing-how-we-monitor-ocean-health/ (Exists)`

### 5. ✅ Maritime communication networks: A survey on architecture, key technologies, and challenges
- **Status:** verified
- **Source:** crossref
- **Match Score:** 100.0%
- **Details:** High confidence match found in Crossref.
- **Found Metadata:**
  - Title: Maritime communication networks: A survey on architecture, key technologies, and challenges
  - Authors: Shang, Ziqi; Zhang, Xian; Li, Xuehua
  - Year: 2025
- **Original Text:** `Shang, Z., Wang, J., & Yang, Y. (2025). Maritime communication networks: A survey on architecture, key technologies, and challenges. Computer Communications, 216, 189–213. https://doi.org/10.1016/j.comcom.2025.108255 (Exists)`

### 6. ⚠️ An AI-powered framework for optimizing maritime logistics operations
- **Status:** suspicious
- **Source:** crossref
- **Match Score:** 44.5%
- **Details:** Partial match found (Score: 44.5%).
- **Found Metadata:**
  - Title: Intelligent Automation Revolutionizing Retail Operations by Optimizing Inventory Management, Logistics, and Customer Service with AI-Powered Robotics and Machine Learning
  - Authors: Vuyyuru, Srinivasa
  - Year: 2025
- **Original Text:** `Zhang, L., Li, X., & Wang, Y. (2023). An AI-powered framework for optimizing maritime logistics operations. Transportation Research Part E: Logistics and Transportation Review, 170, 102789. https://www.mdpi.com/2311-7524/12/1/12345 (Site not found)`
