jimzord12/ai-fire-detection-arduino-system/.gemini/v1/cli-tools/image-gen-ts/test/test-prompt.txt

Create A Pirate ship sailing on the high seas under a full moon, in the style of classic oil paintings.
