jimzord12/ai-fire-detection-arduino-system/.gemini/v1/cli-tools/chapter-tools/tests/data/test-chapter-original.md

# **Κεφάλαιο 4: Πλαίσιο Ναυτιλιακής Κυβερνοασφάλειας**

## **Επισκόπηση**

Η αυξανόμενη ενσωμάτωση συστημάτων Επιχειρησιακής Τεχνολογίας (Operational Technology - OT) και Τεχνολογίας Πληροφοριών (Information Technology - IT) στον ναυτιλιακό τομέα έχει δημιουργήσει ένα πολύπλοκο και διασυνδεδεμένο οικοσύστημα, που συχνά αναφέρεται ως Ναυτιλιακό Διαδίκτυο των Πραγμάτων (Maritime Internet of Things - MIoT). Ενώ αυτός ο ψηφιακός μετασχηματισμός ξεκλειδώνει σημαντική αποδοτικότητα στο παγκόσμιο εμπόριο και τη λειτουργία των πλοίων, ταυτόχρονα εκθέτει τον κλάδο σε ένα νέο και δυναμικό φάσμα κυβερνοαπειλών. Το παρόν κεφάλαιο παρέχει μια ολοκληρωμένη ανασκόπηση των κρίσιμων πυλώνων κυβερνοασφάλειας που είναι απαραίτητοι για την οικοδόμηση μιας ανθεκτικής ναυτιλιακής υποδομής. Η ανάλυση εκτείνεται σε έξι βασικούς πυλώνες: τη θεμελιώδη ασφάλεια της επί του σκάφους Επιχειρησιακής Τεχνολογίας (OT), τη μοντελοποίηση των κυβερνοαπειλών πλοίου-ξηράς, την εφαρμογή Αρχιτεκτονικής Μηδενικής Εμπιστοσύνης (Zero Trust), την προστασία των κρίσιμων ναυτιλιακών υποδομών, τον ρόλο του blockchain στην ασφάλεια των εφοδιαστικών αλυσίδων και την ανάπτυξη προηγμένων Συστημάτων Ανίχνευσης Εισβολών (IDS).

Καθένας από αυτούς τους πυλώνες αντιμετωπίζει μια ξεχωριστή αλλά αλληλένδετη πτυχή της ναυτιλιακής κυβερνοασφάλειας. Η ασφάλεια OT αποτελεί το θεμελιώδες επίπεδο, διασφαλίζοντας το υλικό και το λογισμικό που ελέγχουν τις φυσικές λειτουργίες ενός πλοίου. Βασιζόμενα σε αυτό, τα μοντέλα απειλών για τις επικοινωνίες πλοίου-ξηράς αναλύουν τις κύριες οδούς για κυβερνοεπιθέσεις. Για την αντιμετώπιση αυτών των απειλών, η Αρχιτεκτονική Μηδενικής Εμπιστοσύνης προσφέρει ένα σύγχρονο παράδειγμα ασφάλειας με επίκεντρο την επαλήθευση. Το πεδίο εφαρμογής διευρύνεται στη συνέχεια για να περιλάβει την προστασία ολόκληρης της κρίσιμης ναυτιλιακής υποδομής, συμπεριλαμβανομένων των λιμένων και των ναυτιλιακών λωρίδων. Τέλος, το κεφάλαιο διερευνά δύο βασικές τεχνολογίες που ενισχύουν την ασφάλεια και την εμπιστοσύνη: το blockchain για την ακεραιότητα της εφοδιαστικής αλυσίδας και τα Συστήματα Ανίχνευσης Εισβολών για την παρακολούθηση και αντιμετώπιση απειλών σε πραγματικό χρόνο.

Συλλογικά, αυτοί οι πυλώνες σχηματίζουν ένα ολιστικό πλαίσιο για τη ναυτιλιακή κυβερνοασφάλεια. Αντιπροσωπεύουν μια μετατόπιση από μια παραδοσιακή στάση ασφαλείας βασισμένη στην περίμετρο, σε μια στρατηγική άμυνας σε βάθος που υποθέτει ότι οι απειλές μπορούν να προέρχονται από οπουδήποτε εντός του διασυνδεδεμένου συστήματος. Αυτό το κεφάλαιο θα καταδείξει πώς η σύνθεση αυτών των στοιχείων είναι απαραίτητη για τη διασφάλιση της ασφάλειας, της προστασίας και της αξιοπιστίας του παγκόσμιου ναυτιλιακού τομέα απέναντι στους κλιμακούμενους κινδύνους στον κυβερνοχώρο. Βασιζόμενο στο επίπεδο συνδεσιμότητας που καθιερώθηκε στο Κεφάλαιο 2 και στα συστήματα ανίχνευσης του Κεφαλαίου 3, το παρόν κεφάλαιο θεμελιώνει την εμπιστοσύνη και την ασφάλεια που απαιτούνται για τα προηγμένα αυτόνομα και βασισμένα σε δεδομένα συστήματα που συζητούνται στα επόμενα κεφάλαια.

## **4.1 Ασφάλεια Ναυτιλιακής Επιχειρησιακής Τεχνολογίας (OT)**

### Σπουδαιότητα και Σκοπιμότητα της Έρευνας

Τα συστήματα Επιχειρησιακής Τεχνολογίας (OT) ελέγχουν βασικές λειτουργίες του πλοίου, όπως η πλοήγηση και η λειτουργία των μηχανών. Αυτά τα συστήματα είναι ζωτικής σημασίας για τις ασφαλείς ναυτιλιακές δραστηριότητες. Οι κυβερνοαπειλές κατά των OT μπορούν να προκαλέσουν σημαντικές διαταραχές, όπως καθυστερήσεις στο παγκόσμιο εμπόριο ή κινδύνους ασφαλείας. Καθώς τα πλοία γίνονται πιο συνδεδεμένα, η προστασία της OT είναι καθοριστική για την αποτροπή επιθέσεων που επηρεάζουν τόσο τις λειτουργίες όσο και το περιβάλλον. Αυτή η ενότητα εξετάζει την ασφάλεια OT σε ναυτιλιακά περιβάλλοντα για να αναδείξει τον ρόλο της στα συνολικά συστήματα IoT (International Maritime Organization, 2022; BIMCO et al., 2024).

### Θεωρητικό Υπόβαθρο

Η OT στη ναυτιλία περιλαμβάνει συστήματα όπως το SCADA που παρακολουθούν και ελέγχουν τις διαδικασίες του πλοίου. Τα πρώιμα συστήματα OT ήταν διαχωρισμένα και χρησιμοποιούσαν προσαρμοσμένα πρωτόκολλα για ασφάλεια μέσω περιορισμένης πρόσβασης. Με την πάροδο του χρόνου, αυτά τα συστήματα συνδέθηκαν περισσότερο με δίκτυα IT για καλύτερη ανταλλαγή δεδομένων. Μελέτες δείχνουν ότι αυτή η αλλαγή αύξησε τους κινδύνους στον κυβερνοχώρο, καθώς η OT δεν κατασκευάστηκε για διαδικτυακές απειλές. Βασικά έργα επισημαίνουν πώς ο παλαιού τύπου εξοπλισμός OT στερείται ενημερώσεων, καθιστώντας τον ευάλωτο σε επιθέσεις. Ιστορικές ανασκοπήσεις σημειώνουν ότι η ναυτιλιακή OT εξελίχθηκε από βασικούς ελέγχους σε ολοκληρωμένα ψηφιακά συστήματα, αλλά η ασφάλεια συχνά υστερούσε (Stouffer et al., 2023; BIMCO et al., 2024).

### Τεχνικές Προκλήσεις και Προβληματισμοί

Η ναυτιλιακή OT αντιμετωπίζει μοναδικά προβλήματα λόγω των σκληρών συνθηκών στη θάλασσα και των απομακρυσμένων τοποθεσιών. Τα παλαιά συστήματα έχουν συχνά παλιό λογισμικό με γνωστά ελαττώματα που μπορούν να χρησιμοποιήσουν οι χάκερ. Η ενοποίηση με το IT δημιουργεί μονοπάτια για επιθέσεις που μετακινούνται από τα δίκτυα γραφείου στα συστήματα ελέγχου. Η περιορισμένη υποστήριξη επί του σκάφους σημαίνει ότι τα πληρώματα χειρίζονται τόσο το IT όσο και την OT χωρίς εξειδικευμένη βοήθεια. Κοινά ζητήματα περιλαμβάνουν την αδύναμη ρύθμιση δικτύου, η οποία επιτρέπει την εξάπλωση κακόβουλου λογισμικού, και τους κακούς ελέγχους πρόσβασης που επιτρέπουν την είσοδο σε μη εξουσιοδοτημένους χρήστες. Αυτές οι προκλήσεις είναι χειρότερες σε απομονωμένες λειτουργίες όπου η βοήθεια σε πραγματικό χρόνο δεν είναι διαθέσιμη (International Maritime Organization, 2022; BIMCO et al., 2024).

### Υφιστάμενες Τεχνολογίες και Μεθοδολογικές Προσεγγίσεις

Οι τρέχουσες μέθοδοι εστιάζουν στην κατάτμηση (segmentation) για τον διαχωρισμό των δικτύων OT από τα IT. Εργαλεία όπως τείχη προστασίας (firewalls) και συστήματα παρακολούθησης βοηθούν στον έγκαιρο εντοπισμό απειλών. Ορισμένες προσεγγίσεις χρησιμοποιούν μοντέλα μηδενικής εμπιστοσύνης (zero-trust), όπου κάθε πρόσβαση ελέγχεται. Τα συστήματα ανίχνευσης εισβολών παρακολουθούν για περίεργα μοτίβα στα δεδομένα OT. Συγκριτικές μελέτες δείχνουν ότι ο συνδυασμός αυτών με τακτικές ενημερώσεις μειώνει τους κινδύνους. Οι αρχιτεκτονικές περιλαμβάνουν πλέον ρυθμίσεις με αεροστεγή απομόνωση (air-gapped) για κρίσιμα συστήματα ώστε να εμποδίζονται οι απομακρυσμένες επιθέσεις (Stouffer et al., 2023; International Maritime Organization, 2022).

### Εφαρμογές και Σενάρια Χρήσης

Η ασφάλεια OT χρησιμοποιείται σε πραγματικές περιπτώσεις, όπως η προστασία συστημάτων πλοήγησης σε φορτηγά πλοία. Για παράδειγμα, τα δεξαμενόπλοια εφαρμόζουν κατάτμηση για τη φύλαξη των χειριστηρίων πρόωσης, οδηγώντας σε λιγότερες διαταραχές. Δεδομένα απόδοσης από αυτές τις περιπτώσεις δείχνουν καλύτερους χρόνους απόκρισης κατά τη διάρκεια απειλών. Ιστορίες επιτυχίας περιλαμβάνουν λιμάνια που χρησιμοποιούν εργαλεία παρακολούθησης για να σταματήσουν ransomware, εξοικονομώντας κόστος και χρόνο. Τα διδάγματα από αυτά δείχνουν την ανάγκη για εκπαίδευση του πληρώματος ώστε να χειρίζεται αποτελεσματικά τα ζητήματα OT (BIMCO et al., 2024; Stouffer et al., 2023).

### Μελλοντικές Κατευθύνσεις και Ερευνητικά Κενά

Οι μελλοντικές εργασίες θα πρέπει να στοχεύουν σε εργαλεία βασισμένα στην Τεχνητή Νοημοσύνη (TN) για την πρόβλεψη απειλών στην OT. Υπάρχουν κενά στον χειρισμό κατανεμημένων συστημάτων σε πλοία και λιμάνια. Οι αναδυόμενες τάσεις περιλαμβάνουν το blockchain για ασφαλή ανταλλαγή δεδομένων. Ανοικτά ερωτήματα επικεντρώνονται στο να γίνει η OT ανθεκτική σε νέες επιθέσεις, όπως αυτές που καθοδηγούνται από TN. Η έρευνα θα πρέπει να διερευνήσει καλύτερη εκπαίδευση για τα πληρώματα σχετικά με την ασφάλεια OT (International Maritime Organization, 2022; BIMCO et al., 2024).

## **4.2 Μοντέλα Κυβερνοαπειλών Πλοίου-Ξηράς**

### Σπουδαιότητα και Σκοπιμότητα της Έρευνας

Οι ψηφιακές συνδέσεις πλοίου-ξηράς αποτελούν τη ραχοκοκαλιά των παγκόσμιων ναυτιλιακών λειτουργιών, διασφαλίζοντας ότι τα πλοία επικοινωνούν αποτελεσματικά με τις λιμενικές αρχές, τα εταιρικά γραφεία και τα ζωτικά συστήματα εφοδιαστικής. Καθώς τα πλοία βασίζονται όλο και περισσότερο σε ενοποιημένα δίκτυα IT και OT, αυτές οι οδοί έχουν γίνει σημαντικός στόχος για κυβερνοεπιθέσεις. Οι διαταραχές σε αυτές τις συνδέσεις μπορούν να σταματήσουν τις λιμενικές λειτουργίες, να επηρεάσουν το παγκόσμιο εμπόριο και να εισαγάγουν σημαντικούς κινδύνους ασφάλειας και περιβαλλοντικούς κινδύνους, καθιστώντας την ισχυρή μοντελοποίηση απειλών απαραίτητη για το οικοσύστημα του ναυτιλιακού IoT (US Coast Guard, 2024; BIMCO et al., 2024).

### Θεωρητικό Υπόβαθρο

Πρόσφατες έρευνες υπογραμμίζουν τόσο την ανάπτυξη όσο και την πολυπλοκότητα των κυβερνοαπειλών που αντιμετωπίζουν οι επικοινωνίες πλοίου-ξηράς. Πρώιμες μελέτες εντόπισαν κινδύνους στα συστήματα πλοήγησης και γέφυρας, αλλά η σημερινή διευρυμένη επιφάνεια επίθεσης καλύπτει επίσης φορτία, πρόωση και διοικητικές πλατφόρμες. Αναφορές από διεθνείς και εθνικούς οργανισμούς τονίζουν ότι οι επιτιθέμενοι μπορούν να εκμεταλλευτούν τόσο απομακρυσμένους όσο και φυσικούς φορείς. Σύγχρονα πλαίσια, όπως το NIST CSF και το MaCRA, εφαρμόζονται πλέον για να καθοδηγήσουν τη συστηματική αξιολόγηση κινδύνου, ενσωματώνοντας τη διακυβέρνηση, τη διαχείριση περιουσιακών στοιχείων και την αξιολόγηση τρωτότητας σε όλους τους ναυτιλιακούς τομείς (Li et al., 2024; Hopcraft et al., 2024; US Coast Guard, 2024).

### Τεχνικές Προκλήσεις και Προβληματισμοί

Τα ναυτιλιακά συστήματα αντιμετωπίζουν μοναδικές τεχνικές προκλήσεις: παλαιός εξοπλισμός, ποικίλες εκδόσεις λογισμικού και περιορισμένη τεχνογνωσία κυβερνοασφάλειας επί του σκάφους εμποδίζουν την ανθεκτικότητα. Η ενοποίηση πλοίου-ξηράς εκθέτει αυτές τις πλατφόρμες σε ευρύτερους φορείς επίθεσης, όπως κακόβουλο λογισμικό από εταιρικά δίκτυα ξηράς ή επιθέσεις στην εφοδιαστική αλυσίδα μέσω τρίτων προμηθευτών. Η κοινωνική μηχανική και το ανθρώπινο λάθος παραμένουν σταθεροί κίνδυνοι, ενώ οι ασυνεπείς κανονισμοί και οι αργοί κύκλοι διορθώσεων (patches) ενισχύουν περαιτέρω τις ευπάθειες. Σημειωτέον, το επιχειρησιακό προσωπικό του πλοίου συχνά λειτουργεί χωρίς υποστήριξη κυβερνοασφάλειας σε πραγματικό χρόνο ή δυνατότητες αντιμετώπισης περιστατικών (US Coast Guard, 2024; Li et al., 2024).

### Υφιστάμενες Τεχνολογίες και Μεθοδολογικές Προσεγγίσεις

Η σύγχρονη μοντελοποίηση απειλών στον ναυτιλιακό τομέα χρησιμοποιεί ολοκληρωμένα πλαίσια, όπως STRIDE, STPA-Sec, CORAS και MaCRA, για την ανάλυση κινδύνων τόσο από τεχνική όσο και από επιχειρησιακή σκοπιά. Αυτά τα μοντέλα βοηθούν στον εντοπισμό απειλών και στην ιεράρχηση του μετριασμού, χρησιμοποιώντας χαρτογράφηση περιουσιακών στοιχείων, ανακάλυψη μονοπατιών επίθεσης και ποσοτικοποίηση κινδύνου. Η χρήση ανίχνευσης εισβολών με βάση την ΤΝ, η κατάτμηση δικτύου και η συνεχής παρακολούθηση έχουν αυξηθεί. Κυβερνητικές και βιομηχανικές οδηγίες, όπως αυτές του IMO και της BIMCO, παρέχουν τυποποιημένα πρωτόκολλα για τη διαχείριση κινδύνου και την αξιολόγηση τρωτότητας (BIMCO et al., 2024; Hopcraft et al., 2024; Sahay et al., 2022).

### Εφαρμογές και Σενάρια Χρήσης

Τα μοντέλα απειλών εφαρμόζονται στην πράξη για αξιολογήσεις τρωτότητας, προσομοίωση επιθέσεων και πραγματική αντιμετώπιση περιστατικών. Για παράδειγμα, υποστηρίζουν ασκήσεις ασφαλείας, βελτιώνουν την εκπαίδευση του πληρώματος κατά του phishing και ενημερώνουν τη λήψη αποφάσεων κατά τη διάρκεια συμβάντων ransomware που διαταράσσουν γερανούς πλοίου-ξηράς ή συστήματα ελέγχου γέφυρας. Η Ακτοφυλακή των ΗΠΑ και οι διεθνείς εταίροι χρησιμοποιούν αυτά τα μοντέλα σε ετήσιους ελέγχους ασφαλείας και εκθέσεις ασφάλειας της βιομηχανίας, εντοπίζοντας τάσεις και ταχέως εξελισσόμενους φορείς επίθεσης, όπως στοχευμένες επιθέσεις στη διαχείριση πλοίων που βασίζεται στο cloud (US Coast Guard, 2024; BIMCO et al., 2024).

### Μελλοντικές Κατευθύνσεις και Ερευνητικά Κενά

Τα μελλοντικά μοντέλα ναυτιλιακών κυβερνοαπειλών πρέπει να αντιμετωπίσουν τον πολλαπλασιασμό των αυτόνομων πλοίων, τις απαιτήσεις κβαντικά ασφαλούς επικοινωνίας και νέες μορφές υποδομών που βασίζονται στο cloud. Απαιτείται έρευνα για γρήγορη, δυναμική προσαρμογή σε μεταβαλλόμενες απειλές και για μοντέλα που ενσωματώνουν προοπτικές τόσο IT όσο και OT σε πραγματικό χρόνο. Η παγκόσμια κανονιστική εναρμόνιση και η εκπαίδευση του προσωπικού παραμένουν ανοικτοί τομείς για καινοτομία και ανάπτυξη (Li et al., 2024; Hopcraft et al., 2024).

## **4.3: Αρχιτεκτονική Μηδενικής Εμπιστοσύνης (Zero Trust) για Ναυτιλιακά Συστήματα**

Η Αρχιτεκτονική Μηδενικής Εμπιστοσύνης (Zero Trust Architecture) εφαρμόζει το δόγμα «ποτέ μην εμπιστεύεσαι, πάντα να επαληθεύεις» (never trust, always verify) στο IT/OT πλοίων και λιμένων, χρησιμοποιώντας ελέγχους με επίκεντρο την ταυτότητα, συνεχή επαλήθευση και μικρο-κατάτμηση (micro-segmentation) που δεν βασίζονται στην τοποθεσία δικτύου για εμπιστοσύνη (π.χ. πλοίο έναντι ξηράς) (Rose et al., 2020). Σε ναυτιλιακά πλαίσια, η υιοθέτηση του Zero Trust μειώνει το εύρος των επιπτώσεων των παραβιάσεων και περιορίζει την πλευρική μετακίνηση (lateral movement) στα δίκτυα πλοήγησης, ελέγχου και ευημερίας υπό μικτή δορυφορική και επίγεια συνδεσιμότητα (Li et al., 2024).

### Σπουδαιότητα και Σκοπιμότητα της Έρευνας

Τα σύγχρονα πλοία ενσωματώνουν πολλά ψηφιακά συστήματα και απομακρυσμένες υπηρεσίες τρίτων που αυξάνουν τις επιφάνειες επίθεσης. Το Zero Trust περιορίζει την πρόσβαση στο ελάχιστο απαιτούμενο ανά αίτημα και απαιτεί επαλήθευση κάθε φορά, κάτι που είναι κατάλληλο για κατανεμημένους στόλους και λιμάνια (Rose et al., 2020). Έρευνες του τομέα υπογραμμίζουν τους αυξανόμενους κινδύνους στον κυβερνοχώρο σε AIS, ECDIS, VSAT και OT λιμένων, δίνοντας κίνητρο για πολιτικές που επαληθεύουν χρήστες και συσκευές συνεχώς και κατατέμνουν κρίσιμα περιουσιακά στοιχεία για τη μείωση της λειτουργικής διαταραχής (Li et al., 2024).

### Θεωρητικό Υπόβαθρο

Το NIST SP 800-207 ορίζει τις βασικές αρχές και τα συστατικά του Zero Trust, συμπεριλαμβανομένων των σημείων απόφασης/επιβολής πολιτικής, του ελάχιστου προνομίου (least privilege), της συνεχούς ταυτοποίησης/εξουσιοδότησης και της πολιτικής που καθοδηγείται από τη τηλεμετρία (Rose et al., 2020). Πρόσφατες έρευνες συνθέτουν πρακτικές Zero Trust όπως η δυναμική εμπιστοσύνη, η μικρο-κατάτμηση και η πρόσβαση βάσει ταυτότητας που στοχεύουν στη μείωση της πλευρικής μετακίνησης σε ετερογενή δίκτυα που σχετίζονται με τη ναυτιλιακή ψηφιοποίηση (Azad et al., 2024).

### Τεχνικές Προκλήσεις και Προβληματισμοί

Οι διακοπτόμενες συνδέσεις και οι συνδέσεις υψηλής καθυστέρησης (π.χ. VSAT) περιπλέκουν τη συνεχή επαλήθευση και τις κεντρικές αποφάσεις πολιτικής. Οι αρχιτεκτονικές χρειάζονται τοπική επιβολή με προσωρινή αποθήκευση (caching) πολιτικής για τη διατήρηση της ασφάλειας και των λειτουργιών κατά την απώλεια σύνδεσης (Li et al., 2024). Τα συστήματα ασφαλείας ναυτιλιακής OT απαιτούν ανεξαρτησία. Η αντιστοίχιση της μικρο-κατάτμησης Zero Trust με τις ζώνες και τους αγωγούς (conduits) του IEC 62443 πρέπει να διατηρεί την ακεραιότητα ασφαλείας, επιτρέποντας παράλληλα ελεγχόμενους, ελέγξιμους αγωγούς για συντήρηση και παρακολούθηση (Rødseth et al., 2022).

### Υφιστάμενες Τεχνολογίες και Μεθοδολογικές Προσεγγίσεις

Οι σχεδιασμοί τοποθετούν την επιβολή πολιτικής κοντά σε κρίσιμες ζώνες (πλοήγηση, πρόωση, φορτίο) και χρησιμοποιούν ταυτοποίηση και εξουσιοδότηση ανά συνεδρία με κρυπτογράφηση για επικοινωνίες πλοίου-ξηράς και πλοίου-cloud (Rose et al., 2020). Η μικρο-κατάτμηση επιβάλλει λίστες επιτρεπόμενων (allow-lists) για ροές από συσκευή σε συσκευή και ευθυγραμμίζεται με τις ζώνες/αγωγούς IEC 62443 για τη διατήρηση της ανεξαρτησίας ασφάλειας OT, επιτρέποντας παράλληλα απομακρυσμένη υποστήριξη ελάχιστου προνομίου (Rødseth et al., 2022).

### Εφαρμογές και Σενάρια Χρήσης

Πρόσβαση συντήρησης Just-in-time: Συνεδρίες περιορισμένου χρόνου και βάσει ρόλου για OEM σε τμήματα πρόωσης ή ECDIS απαιτούν στάση συσκευής (device posture) και επαλήθευση χρήστη πριν από τη χορήγηση περιορισμένης πρόσβασης (Rose et al., 2020).

Κατάτμηση λιμενικών λειτουργιών: Ο διαχωρισμός του ελέγχου γερανών, της διαχείρισης ναυπηγείων και των συστημάτων πυλών με πολιτικές βάσει ταυτότητας περιορίζει τις επιπτώσεις μεταξύ τομέων από phishing ή κακόβουλο λογισμικό (Azad et al., 2024).

### Μελλοντικές Κατευθύνσεις και Ερευνητικά Κενά

Απαιτείται κατανεμημένη απόφαση/επιβολή πολιτικής με ισχυρή προσωρινή αποθήκευση για τη διατήρηση των εγγυήσεων Zero Trust κατά τη διάρκεια διακοπών δορυφόρου, ακολουθούμενη από επικύρωση σε ναυτιλιακές δοκιμές (Rose et al., 2020). Πρακτικές μέθοδοι για την προσθήκη ταυτότητας και τηλεμετρίας σε παλαιά OT (π.χ. proxies ή sidecars) και ροές εργασίας φιλικές προς τον χειριστή που διατηρούν την ασφάλεια και εξηγούν τις αποφάσεις παραμένουν ανοικτές προκλήσεις (Li et al., 2024).

## **4.4 Προστασία Κρίσιμων Ναυτιλιακών Υποδομών**

### Σπουδαιότητα και Σκοπιμότητα της Έρευνας

Οι κρίσιμες ναυτιλιακές υποδομές —συμπεριλαμβανομένων λιμένων, υποβρύχιων καλωδίων, υπεράκτιων πλατφορμών και ναυτιλιακών λωρίδων— αποτελούν τη ραχοκοκαλιά του συστήματος παγκόσμιου εμπορίου, επιτρέποντας τη ροή αγαθών, ενέργειας και ψηφιακών πληροφοριών (MARSEC-COE, 2023). Η διακοπή ή η παραβίαση αυτής της υποδομής, είτε από κυβερνοαπειλές είτε από φυσικές απειλές, μπορεί να έχει εκτεταμένες επιπτώσεις στις εφοδιαστικές αλυσίδες, την οικονομική σταθερότητα και τη ναυτιλιακή ασφάλεια (Liebetrau, 2023). Καθώς ο ναυτιλιακός τομέας υφίσταται ψηφιακό μετασχηματισμό, η διασφάλιση αυτής της υποδομής δεν είναι μόνο θέμα εθνικής ασφάλειας αλλά και ζωτικής σημασίας για την ανθεκτικότητα του διεθνούς εμπορίου σε έναν όλο και πιο διασυνδεδεμένο κόσμο (MARSEC-COE, 2023; Liebetrau, 2023).

### Θεωρητικό Υπόβαθρο

Η έρευνα για την προστασία των κρίσιμων ναυτιλιακών υποδομών (MCIP) έχει πολλαπλασιαστεί ως απάντηση σε νέες απειλές που προκύπτουν από την ψηφιοποίηση και τις γεωπολιτικές εντάσεις (Liebetrau, 2023). Θεμελιώδεις μελέτες υπογραμμίζουν την ευπάθεια των ναυτιλιακών περιουσιακών στοιχείων τόσο σε κυβερνοεπιθέσεις όσο και σε φυσικές επιθέσεις, σημειώνοντας ότι υποδομές όπως λιμάνια και υποθαλάσσια καλώδια στοχεύονται όλο και περισσότερο από εξελιγμένους αντιπάλους, συμπεριλαμβανομένων εθνικών κρατών και εγκληματικών ομάδων (Cyble, 2025). Βασικοί διεθνείς οργανισμοί, όπως το ΝΑΤΟ και ο Διεθνής Ναυτιλιακός Οργανισμός (ΙΜΟ), έχουν ξεκινήσει κατευθυντήριες γραμμές, ομάδες εργασίας και ασκήσεις συνεργασίας για την ενίσχυση της ανθεκτικότητας (O’Dwyer, 2023). Ιστορικές περιπτωσιολογικές μελέτες, συμπεριλαμβανομένου του περιστατικού κυβερνοεπίθεσης στη Maersk και επιθέσεων σε υπηρεσίες GPS, έχουν καταλύσει την πρόοδο στην ευαισθητοποίηση, τη ρύθμιση και την πολυεθνική συνεργασία (MARSEC-COE, 2023).

### Τεχνικές Προκλήσεις και Προβληματισμοί

Η προστασία των κρίσιμων ναυτιλιακών υποδομών αντιμετωπίζει μοναδικούς περιορισμούς: μακρές εφοδιαστικές αλυσίδες, απομονωμένα και μη επανδρωμένα περιουσιακά στοιχεία, τεχνολογίες παλαιού τύπου και πολύπλοκα οικοσυστήματα ενδιαφερομένων μερών (BIMCO et al., 2024). Οι κυβερνοαπειλές εκμεταλλεύονται τη σύγκλιση επιχειρησιακής τεχνολογίας (OT) και τεχνολογίας πληροφοριών (IT), την αδύναμη κατάτμηση, τους ανεπαρκείς κύκλους επιδιορθώσεων και ανθρώπινους παράγοντες όπως η χαμηλή ευαισθητοποίηση των πληρωμάτων σε θέματα κυβερνοασφάλειας (MARSEC-COE, 2023). Οι φυσικές προκλήσεις περιλαμβάνουν την τεράστια γεωγραφική διασπορά και τα δύσκολα στην παρακολούθηση υποβρύχια περιουσιακά στοιχεία (Liebetrau, 2023). Τα ασυντόνιστα πλαίσια απόκρισης και τα κενά στην ανταλλαγή πληροφοριών εμποδίζουν περαιτέρω τον ταχύ μετριασμό, ιδιαίτερα σε περιβάλλοντα πολλαπλών δικαιοδοσιών (Liebetrau, 2023).

### Υφιστάμενες Τεχνολογίες και Μεθοδολογικές Προσεγγίσεις

Οι σημερινές στρατηγικές MCIP αξιοποιούν εργαλεία αξιολόγησης κινδύνου, πρότυπα κυβερνοασφάλειας (π.χ. ενσωμάτωση κώδικα IMO ISM) και προηγμένα σχέδια αντιμετώπισης περιστατικών που περιλαμβάνουν φάσεις προετοιμασίας, ανίχνευσης, περιορισμού, εξάλειψης και ανάκαμψης (IASME, 2025). Τα ψηφιακά δίδυμα και οι πλατφόρμες επίγνωσης της κατάστασης διευκολύνουν την παρακολούθηση, ενώ συνεργατικά οικοσυστήματα όπως η πλατφόρμα PRECINCT επιτρέπουν την ενσωμάτωση μέτρων κυβερνο-φυσικής ασφάλειας σε όλους τους τομείς (PRECINCT, 2024). Η ανάπτυξη μη επανδρωμένων οχημάτων (USVs/UUVs) ενισχύει τις επιχειρήσεις επιτήρησης και ασφάλειας, ειδικά για περιοχές υψηλού κινδύνου ή απομακρυσμένες περιοχές (EEAS, 2025). Πολυεθνικές ασκήσεις, όπως η MARSEC EU 25, ενισχύουν τις συντονισμένες ικανότητες απόκρισης και την εφαρμογή βέλτιστων πρακτικών (EEAS, 2025).

### Εφαρμογές και Σενάρια Χρήσης

Τα πλαίσια MCIP έχουν δείξει αποτελεσματικότητα σε επιχειρήσεις ασφάλειας λιμένων, ανθεκτικότητα υποθαλάσσιων καλωδίων και προστασία γραμμών ενεργειακού εφοδιασμού όπως οι τερματικοί σταθμοί LNG (MARSEC-COE, 2023). Μαθήματα από περιστατικά όπως η επίθεση στη Maersk οδήγησαν στην υιοθέτηση ανθεκτικών εφεδρικών συστημάτων και διατομεακών ασκήσεων στον κυβερνοχώρο (PRECINCT, 2024). Η χαρτογράφηση κινδύνου βάσει δεδομένων και ο αυτοματισμός στην ανίχνευση απειλών υποστηρίζουν προληπτικές απαντήσεις σε εξελισσόμενες απειλές (O’Dwyer, 2023). Μελέτες περιπτώσεων υπογραμμίζουν τα οφέλη της συνεργασίας μεταξύ φορέων του δημόσιου τομέα, ιδιωτών διαχειριστών και διεθνών οργανισμών για την ταχεία επίλυση περιστατικών και τη διασφάλιση του παγκόσμιου εμπορίου (Liebetrau, 2023).

### Μελλοντικές Κατευθύνσεις και Ερευνητικά Κενά

Οι τρέχουσες ερευνητικές προτεραιότητες περιλαμβάνουν την ανάπτυξη πιο προσαρμοστικών μεθοδολογιών ανθεκτικότητας βάσει κινδύνου, βελτιωμένες στρατηγικές ενοποίησης OT/IT και προηγμένα προγράμματα εκπαίδευσης που στοχεύουν στην ευαισθητοποίηση του πληρώματος στον κυβερνοχώρο (BIMCO et al., 2024). Υπάρχει επίσης μια αναδυόμενη εστίαση στη χρήση τεχνητής νοημοσύνης για αυτοματοποιημένη ανίχνευση ανωμαλιών και τη δημιουργία κοινών πλαισίων ΕΕ-ΝΑΤΟ για τον συντονισμό ταχείας απόκρισης σε γεωπολιτικά όρια (EEAS, 2025). Υπάρχει ένα επίμονο κενό στην ανάπτυξη πληροφοριών απειλών και ανταλλαγής πληροφοριών προσαρμοσμένων για υβριδικές και διασυνοριακές ναυτιλιακές απειλές, ειδικά για ενεργειακές υποδομές και καλώδια δεδομένων (Liebetrau, 2023).

## **4.5: Εφαρμογές Blockchain στις Ναυτιλιακές Εφοδιαστικές Αλυσίδες**

### Σπουδαιότητα και Σκοπιμότητα της Έρευνας

Οι ναυτιλιακές εφοδιαστικές αλυσίδες είναι ζωτικής σημασίας για το παγκόσμιο εμπόριο, μεταφέροντας περισσότερο από το 90% του παγκόσμιου φορτίου κατ' όγκο (Liu et al., 2023). Ωστόσο, ο τομέας αντιμετωπίζει προκλήσεις, όπως κατακερματισμένες διαδικασίες τεκμηρίωσης, έλλειψη διαφάνειας και αδύναμη εμπιστοσύνη μεταξύ των ενδιαφερομένων μερών (Farah et al., 2024). Η τεχνολογία Blockchain παρουσιάζει λύσεις σε αυτά τα προβλήματα μέσω μόνιμων αρχείων, αυτοματοποίησης έξυπνων συμβολαίων και διαφανών, κοινών δεδομένων. Καθώς η βιομηχανία αγκαλιάζει τον ψηφιακό μετασχηματισμό, το blockchain αποτελεί θεμελιώδες συστατικό για την αποτελεσματικότητα, την αξιοπιστία και τη βιωσιμότητα (Farah et al., 2024; Liu et al., 2023).

### Θεωρητικό Υπόβαθρο

Υπάρχει ένας αυξανόμενος όγκος βιβλιογραφίας σχετικά με τις εφαρμογές blockchain στη ναυτιλιακή εφοδιαστική. Έρευνες και συστηματικές ανασκοπήσεις περιγράφουν πώς οι λύσεις blockchain δοκιμάζονται πιλοτικά και αξιολογούνται για την ασφαλή ανταλλαγή εγγράφων, την ιχνηλασιμότητα φορτίου και τον συντονισμό μεταξύ λιμένων, φορτωτών και ρυθμιστικών αρχών (Farah et al., 2024). Γνωστά πιλοτικά έργα περιλαμβάνουν το TradeLens της IBM/Maersk, το Global Shipping Business Network (GSBN) της CargoSmart και την πλατφόρμα Silsal της Abu Dhabi Ports, τα οποία επιδεικνύουν τη σκοπιμότητα του blockchain για ψηφιακή τεκμηρίωση από άκρο σε άκρο και ασφαλή ανταλλαγή δεδομένων στο ναυτιλιακό εμπόριο (Irannezhad, 2020; Abu Dhabi Ports, 2018).

### Τεχνικές Προκλήσεις και Προβληματισμοί

Η ευρεία υιοθέτηση του blockchain στις ναυτιλιακές εφοδιαστικές αλυσίδες αντιμετωπίζει σημαντικά εμπόδια. Οι τεχνικές προκλήσεις περιλαμβάνουν την ενοποίηση με υπάρχοντα παλαιά συστήματα λιμένων, την επεκτασιμότητα για μεγάλους όγκους συναλλαγών και την ανάγκη για ισχυρή κυβερνοασφάλεια (Surucu-Balci et al., 2024). Η οργανωτική αντίσταση στην αλλαγή, το υψηλό κόστος εφαρμογής, τα ασυνεπή πρότυπα δεδομένων και τα πολύπλοκα ρυθμιστικά περιβάλλοντα περιπλέκουν περαιτέρω την υιοθέτηση (Maritime industry accelerates..., 2025). Οι κατακερματισμένες παγκόσμιες εφοδιαστικές αλυσίδες σημαίνουν ότι η ευθυγράμμιση όλων των συμμετεχόντων σε διαλειτουργικές πλατφόρμες blockchain είναι πολύπλοκη, αν και οργανισμοί όπως η DCSA (Digital Container Shipping Association) και η BIMCO έχουν ξεκινήσει προσπάθειες τυποποίησης (Farah et al., 2024).

### Υφιστάμενες Τεχνολογίες και Μεθοδολογικές Προσεγγίσεις

Οι περισσότερες υλοποιήσεις blockchain στις ναυτιλιακές εφοδιαστικές αλυσίδες εστιάζουν σε τρεις τομείς: ψηφιακή τεκμηρίωση (όπως ηλεκτρονικές φορτωτικές και πιστοποιητικά προέλευσης), αυτοματοποίηση επιχειρηματικών διαδικασιών με χρήση έξυπνων συμβολαίων (smart contracts) και ενισχυμένη ιχνηλασιμότητα και συντονισμό σε όλη την αλυσίδα εφοδιαστικής (Liu et al., 2023). Πλατφόρμες όπως το TradeLens παρέχουν ασφαλείς ροές εγγράφων και ορατότητα φορτίου σε πραγματικό χρόνο, ενώ το Silsal στο Abu Dhabi Ports επιτρέπει ασφαλή διαχείριση εγγράφων και ταυτοτήτων μεταξύ των φορέων της εφοδιαστικής αλυσίδας (Irannezhad, 2020). Η συνεργασία μέσω του Global Shipping Business Network (GSBN) υπογραμμίζει τις προσπάθειες της βιομηχανίας για τη δημιουργία ευρέως αποδεκτών ψηφιακών ναυτιλιακών πλατφορμών, με τα πρώιμα πιλοτικά προγράμματα να δείχνουν σημαντικές μειώσεις στη γραφειοκρατία και τους χρόνους συναλλαγών (Abu Dhabi Ports, 2018; Farah et al., 2024).

### Εφαρμογές και Σενάρια Χρήσης

Αξιοσημείωτες εφαρμογές στον πραγματικό κόσμο περιλαμβάνουν την ασφαλή και αποτελεσματική παρακολούθηση εμπορευματοκιβωτίων μέσω αμετάβλητων αρχείων, την αυτοματοποίηση τελωνειακών διαδικασιών, την ψηφιακή διαχείριση φορτωτικών και την παρακολούθηση σε πραγματικό χρόνο για εμπορευματοκιβώτια ψυγεία (reefer) (Farah et al., 2024). Το σύστημα TradeLens, για παράδειγμα, έχει επιτρέψει σε περισσότερους από 100 οργανισμούς να παρακολουθούν αποστολές, να αυτοματοποιούν τελωνειακές εγκρίσεις και να μειώνουν τις διαφορές (Liu et al., 2023). Στα λιμάνια του Abu Dhabi, η υπηρεσία blockchain Silsal συνδέει τους χρήστες μέσω ψηφιακών ταυτοτήτων, κρυπτογραφώντας ευαίσθητα έγγραφα και απλοποιώντας τη μετακίνηση αγαθών (Abu Dhabi Ports, 2018). Αυτά τα πιλοτικά προγράμματα υπογραμμίζουν την ικανότητα του blockchain να αυξάνει την ταχύτητα, την αξιοπιστία και την ασφάλεια σε όλη τη ναυτιλιακή αλυσίδα εφοδιαστικής (Irannezhad, 2020).

### Μελλοντικές Κατευθύνσεις και Ερευνητικά Κενά

Βασικά κενά παραμένουν στην τυποποίηση του blockchain, τη διαλειτουργικότητα συστημάτων και την αυστηρή αξιολόγηση των συμβιβασμών κόστους-οφέλους για αναπτύξεις πλήρους κλίμακας (Surucu-Balci et al., 2024). Απαιτείται έρευνα για την εναρμόνιση των διεθνών προτύπων δεδομένων (όπως αυτά της DCSA και της BIMCO), την υποστήριξη μηχανισμών blockchain που προστατεύουν το ιδιωτικό απόρρητο και την παροχή εμπειρικών μελετών για πλήρεις υλοποιήσεις εφοδιαστικής αλυσίδας (Farah et al., 2024). Η ενσωμάτωση του blockchain με το IoT και την τεχνητή νοημοσύνη θα μπορούσε να αυξήσει περαιτέρω την ανθεκτικότητα και την αποδοτικότητα, ενώ η συνεργασία πολλών ενδιαφερομένων μερών είναι κρίσιμη για την υιοθέτηση από ολόκληρη τη βιομηχανία (Maritime industry accelerates..., 2025).

## **4.6: Συστήματα Ανίχνευσης Εισβολών (IDS) στη Ναυτιλία**

### Σπουδαιότητα και Σκοπιμότητα της Έρευνας

Καθώς οι ναυτιλιακές λειτουργίες γίνονται πιο ψηφιοποιημένες και διασυνδεδεμένες, η έκθεσή τους σε κυβερνοαπειλές συνεχίζει να αυξάνεται. Τα Συστήματα Ανίχνευσης Εισβολών (Intrusion Detection Systems - IDS) έχουν καταστεί απαραίτητα για την ενίσχυση της ανθεκτικότητας των δικτύων πλοίων και λιμένων έναντι ενός ταχέως εξελισσόμενου τοπίου κυβερνοεπιθέσεων, προστατεύοντας όχι μόνο τα ψηφιακά περιουσιακά στοιχεία αλλά και τις κρίσιμες για την ασφάλεια λειτουργίες (Indian Register of Shipping, 2024; Melnyk et al., 2025).

### Θεωρητικό Υπόβαθρο

Η βιβλιογραφία για τα Ναυτιλιακά Συστήματα Ανίχνευσης Εισβολών υπογραμμίζει τόσο τους ειδικούς κινδύνους του τομέα όσο και τις πρόσφατες προόδους με χρήση ΤΝ και μηχανικής μάθησης. Μελέτες τονίζουν ότι οι ναυτιλιακές κυβερνοεπιθέσεις, συμπεριλαμβανομένων αυτών που επηρεάζουν λιμάνια και πλοία, έχουν οδηγήσει σε σοβαρές λειτουργικές διαταραχές, οικονομικές απώλειες και ανησυχίες για την ασφάλεια. Σημαντικά περιστατικά, όπως το περιστατικό της Maersk και οι επιθέσεις στο λιμάνι της Βαρκελώνης και στην DP World Australia, υπογραμμίζουν τον αυξανόμενο αντίκτυπο των κυβερνοαπειλών στη ναυτιλιακή υποδομή. Ιστορικές και τρέχουσες επιθέσεις έχουν ωθήσει την έρευνα τόσο σε IDS βάσει δικτύου όσο και σε IDS βάσει κεντρικού υπολογιστή (host-based), με πρόσφατες εργασίες να επιδεικνύουν την εφαρμογή μοντέλων μηχανικής μάθησης για την ανίχνευση ανώμαλης συμπεριφοράς στα ναυτιλιακά δίκτυα (Melnyk et al., 2025; Vaarandi et al., 2025).

### Τεχνικές Προκλήσεις και Προβληματισμοί

Τα ναυτιλιακά IDS αντιμετωπίζουν μοναδικές προκλήσεις που απορρέουν από απομονωμένα περιβάλλοντα, διακοπτόμενη και χαμηλού εύρους ζώνης συνδεσιμότητα, μια ποικιλία παλαιών και σύγχρονων συστημάτων και τις σκληρές λειτουργικές συνθήκες στη θάλασσα. Οι παραδοσιακές αρχιτεκτονικές IDS, οι οποίες συχνά βασίζονται σε συχνές ενημερώσεις και σταθερές περιμέτρους δικτύου, δεν ευθυγραμμίζονται καλά με τις ευέλικτες, κατανεμημένες και περιορισμένων πόρων πραγματικότητες επί των πλοίων και στις λιμενικές εγκαταστάσεις. Επιπλέον, ένα υψηλό ποσοστό ψευδώς θετικών αποτελεσμάτων είναι ιδιαίτερα προβληματικό, καθώς οι περιττές ειδοποιήσεις μπορούν να διαταράξουν σοβαρά τις ναυτιλιακές λειτουργίες όπου η χειροκίνητη παρέμβαση είναι δαπανηρή και περιορισμένη (Indian Register of Shipping, 2024; Melnyk et al., 2025).

### Υφιστάμενες Τεχνολογίες και Μεθοδολογικές Προσεγγίσεις

Οι τρέχουσες προσεγγίσεις ναυτιλιακών IDS αξιοποιούν ένα μείγμα ανίχνευσης βάσει υπογραφής (signature-based) για γνωστές απειλές και μοντέλων βάσει ανωμαλιών (anomaly-based) για την ανακάλυψη νέων επιθέσεων. Πρόσφατη έρευνα υπογραμμίζει μια στροφή προς μεθοδολογίες που βασίζονται στην ΤΝ, με τεχνικές επιβλεπόμενης και μη επιβλεπόμενης μηχανικής μάθησης, προσεγγίσεις συνόλου (ensemble) και βαθιά μάθηση (deep learning) για τη βελτίωση της ακρίβειας ανίχνευσης. Οι υβριδικές αρχιτεκτονικές IDS ενσωματώνουν όλο και περισσότερο εισόδους φυσικής ασφάλειας (π.χ. έλεγχος πρόσβασης, περιβαλλοντικοί αισθητήρες) με τηλεμετρία επιπέδου δικτύου. Τα προηγμένα συστήματα ενδέχεται επίσης να χρησιμοποιούν διαχείριση πληροφοριών ασφαλείας και συμβάντων (SIEM) για τον συνδυασμό διαφορετικών πηγών ναυτιλιακών δεδομένων, ενώ ορισμένες λύσεις αρχίζουν να ενσωματώνουν blockchain για αρχεία εγκληματολογίας ανθεκτικά σε παραβιάσεις. Οδηγίες της βιομηχανίας, όπως αυτές του Indian Register of Shipping, συνιστούν πλέον την ανάπτυξη IDS ως βέλτιστη πρακτική (Indian Register of Shipping, 2024; Melnyk et al., 2025; Jahan et al., 2024).

### Εφαρμογές και Σενάρια Χρήσης

Οι επιχειρησιακές αναπτύξεις IDS σε έξυπνα λιμάνια και προηγμένα πλοία δείχνουν ότι αυτά τα συστήματα μπορούν να ανιχνεύσουν και να μετριάσουν στοχευμένες επιθέσεις, περιστατικά κατανεμημένης άρνησης υπηρεσίας (DDoS) και μη εξουσιοδοτημένη πρόσβαση στο δίκτυο. Μελέτες περιπτώσεων καταδεικνύουν ότι τα προσαρμοστικά IDS που βασίζονται στη μηχανική μάθηση, τα οποία μερικές φορές αναπτύσσονται στο άκρο του δικτύου χρησιμοποιώντας υπολογιστική άκρου πολλαπλής πρόσβασης (MEC), επιτυγχάνουν υψηλά ποσοστά ανίχνευσης διατηρώντας παράλληλα χαμηλά ποσοστά ψευδώς θετικών αποτελεσμάτων. Οι εφαρμογές στον πραγματικό κόσμο περιλαμβάνουν την ενσωμάτωση σε συστήματα ασφάλειας λιμένων, δίκτυα ελέγχου ναυτιλίας και υποδομές πλοίων, επεξηγώντας τόσο την τεχνική βιωσιμότητα όσο και την επιχειρησιακή αναγκαιότητα των IDS στην πράξη (Jahan et al., 2024; Melnyk et al., 2025).

### Μελλοντικές Κατευθύνσεις και Ερευνητικά Κενά

Οι μελλοντικές ερευνητικές ανάγκες περιλαμβάνουν τη βελτίωση των IDS για την αντιμετώπιση του συνεχώς μεταβαλλόμενου περιβάλλοντος απειλών, την ενοποίηση αρχιτεκτονικών cloud-edge για αναλυτικά στοιχεία σε πραγματικό χρόνο και την τυποποίηση πηγών ναυτιλιακών δεδομένων για ευρύτερη εφαρμογή. Υπάρχουν ευκαιρίες για συνδυασμό μοντέλων IDS υπογραφής και συμπεριφοράς, βελτίωση της διαλειτουργικότητας και ενσωμάτωση blockchain για μεγαλύτερη ακεραιότητα δεδομένων. Παραμένουν ερευνητικά κενά στην ανάπτυξη παγκοσμίως εναρμονισμένων πρωτοκόλλων και μεγάλων, αντιπροσωπευτικών συνόλων ναυτιλιακών δεδομένων στον κυβερνοχώρο για την υποστήριξη πιο ισχυρών και μεταβιβάσιμων λύσεων IDS (Melnyk et al., 2025; Jahan et al., 2024).

## **Συμπέρασμα**

Αυτό το κεφάλαιο παρείχε μια δομημένη επισκόπηση ενός πολυεπίπεδου πλαισίου κυβερνοασφάλειας, απαραίτητου για τη σύγχρονη ναυτιλιακή βιομηχανία. Εξετάζοντας συστηματικά έξι κρίσιμους πυλώνες —ασφάλεια Επιχειρησιακής Τεχνολογίας (OT), μοντελοποίηση απειλών πλοίου-ξηράς, Αρχιτεκτονική Μηδενικής Εμπιστοσύνης (Zero Trust), προστασία κρίσιμων υποδομών, εφαρμογές blockchain και Συστήματα Ανίχνευσης Εισβολών (IDS)— καθίσταται προφανές ότι μια ισχυρή άμυνα δεν είναι μια μεμονωμένη λύση αλλά μια βαθιά ολοκληρωμένη στρατηγική. Η συζήτηση ανέδειξε τις μοναδικές προκλήσεις που θέτει το ναυτιλιακό περιβάλλον, συμπεριλαμβανομένης της σύγκλισης παλαιών και σύγχρονων συστημάτων, των περιορισμών της διακοπτόμενης συνδεσιμότητας και της τεράστιας γεωγραφικής κλίμακας των λειτουργιών. Το κεφάλαιο συνέθεσε τρέχουσες τεχνολογίες και προσεγγίσεις, καταδεικνύοντας μια σαφή τάση προς πιο δυναμικά, ευφυή και επικεντρωμένα στα δεδομένα μέτρα ασφαλείας, απομακρυνόμενα από στατικές άμυνες βασισμένες στην περίμετρο.

**Κύρια Συμπεράσματα:**

- **Η άμυνα σε βάθος είναι υποχρεωτική:** Μια ανθεκτική στάση ναυτιλιακής κυβερνοασφάλειας δεν μπορεί να βασίζεται σε ένα μόνο σημείο αποτυχίας. Απαιτεί αλληλεπικαλυπτόμενα επίπεδα ασφάλειας, από τη σκλήρυνση φυσικών συστημάτων OT και τη μοντελοποίηση απειλών έως την εφαρμογή ελέγχων πρόσβασης με επίκεντρο την ταυτότητα και την παρακολούθηση σε πραγματικό χρόνο.
- **Ο ανθρώπινος παράγοντας είναι μια κρίσιμη ευπάθεια και περιουσιακό στοιχείο:** Σε πολλαπλές ενότητες, η έλλειψη τεχνογνωσίας κυβερνοασφάλειας επί του σκάφους και ο κίνδυνος ανθρώπινου λάθους εντοπίστηκαν ως σημαντικές προκλήσεις. Αντίθετα, η αποτελεσματική εκπαίδευση και ευαισθητοποίηση του πληρώματος αναφέρονται σταθερά ως κρίσιμα συστατικά οποιασδήποτε επιτυχημένης στρατηγικής ασφάλειας.
- **Η ακεραιότητα των δεδομένων και η εμπιστοσύνη είναι υψίστης σημασίας:** Η διερεύνηση του Zero Trust και του blockchain αποκαλύπτει μια θεμελιώδη στροφή προς συστήματα που δεν εμπιστεύονται σιωπηρά κανέναν χρήστη ή συσκευή. Αντίθετα, η συνεχής επαλήθευση και τα αμετάβλητα αρχεία γίνονται το νέο πρότυπο για τη διασφάλιση της ακεραιότητας των δεδομένων και τη διευκόλυνση της εμπιστοσύνης σε ένα κατακερματισμένο οικοσύστημα πολλών ενδιαφερομένων.
- **Η προληπτική και προσαρμοστική ασφάλεια είναι το μέλλον:** Η αυξανόμενη εξάρτηση από IDS που βασίζονται στην ΤΝ και η ανάγκη για δυναμικά μοντέλα απειλών σηματοδοτούν μια μετάβαση από την αντιδραστική στην προληπτική ασφάλεια. Τα μελλοντικά συστήματα πρέπει να είναι σε θέση να προβλέπουν και να προσαρμόζονται σε αναδυόμενες απειλές σε πραγματικό χρόνο.

**Περιορισμοί και Ερευνητικά Κενά:**

- _Τρέχοντες Τεχνικοί Περιορισμοί:_ Ένας πρωταρχικός περιορισμός είναι η δυσκολία εκ των υστέρων εφαρμογής (retrofitting) σύγχρονων λύσεων ασφαλείας σε παλαιά συστήματα OT χωρίς τη διακοπή των λειτουργιών. Επιπλέον, η υψηλή καθυστέρηση και το χαμηλό εύρος ζώνης των δορυφορικών επικοινωνιών εμποδίζουν την αποτελεσματικότητα κεντρικών αρχιτεκτονικών ασφαλείας σε πραγματικό χρόνο όπως το Zero Trust.
- _Εντοπισμένα Ερευνητικά Κενά:_ Ένα επαναλαμβανόμενο κενό σε όλους τους πυλώνες είναι η ανάγκη για μεγάλης κλίμακας, ειδικά για τη ναυτιλία σύνολα δεδομένων για την εκπαίδευση και την επικύρωση μοντέλων ασφαλείας που βασίζονται στην ΤΝ. Απαιτείται επίσης περαιτέρω έρευνα για την ανάπτυξη και τη δοκιμή κατανεμημένων μηχανισμών επιβολής πολιτικής ασφαλείας που μπορούν να λειτουργούν αξιόπιστα κατά τη διάρκεια περιόδων αποσύνδεσης δικτύου. Τέλος, υπάρχει έλλειψη εμπειρικών, διαχρονικών μελετών σχετικά με την ανάλυση κόστους-οφέλους της εφαρμογής αυτών των προηγμένων μέτρων ασφαλείας σε έναν στόλο.
- _Εμπόδια Εφαρμογής:_ Τα πιο σημαντικά εμπόδια στην εφαρμογή είναι το υψηλό αρχικό κόστος, η σπανιότητα εξειδικευμένων επαγγελματιών ναυτιλιακής κυβερνοασφάλειας και η έλλειψη παγκοσμίως εναρμονισμένων κανονισμών και προτύπων, γεγονός που δημιουργεί ένα πολύπλοκο και συχνά αντιφατικό τοπίο συμμόρφωσης.

**Ερευνητικές Συνεισφορές:**

Το παρόν κεφάλαιο θεμελιώνει την κρίσιμη βάση κυβερνοασφάλειας που είναι απαραίτητη για το Ναυτιλιακό Διαδίκτυο των Πραγμάτων. Συνθέτοντας την τελευταία λέξη της τεχνολογίας σε αυτούς τους έξι πυλώνες, παρέχει ένα ολιστικό πλαίσιο που ενημερώνει την ανάπτυξη και την ανάπτυξη των πιο προηγμένων αυτόνομων συστημάτων και πλατφορμών ανάλυσης δεδομένων που συζητούνται στα επόμενα κεφάλαια. Γεφυρώνει το χάσμα μεταξύ του φυσικού επιπέδου και του επιπέδου επικοινωνίας του MIoT και των ευφυών εφαρμογών που βασίζονται σε δεδομένα, οι οποίες εξαρτώνται από μια ασφαλή και αξιόπιστη υποδομή. Αυτό το πλαίσιο χρησιμεύει ως ζωτική προϋπόθεση για την πραγματοποίηση του πλήρους δυναμικού ενός συνδεδεμένου και αυτόνομου ναυτιλιακού μέλλοντος.

## Βιβλιογραφία

Abu Dhabi Ports. (2018, June 2). _Abu Dhabi Ports launches blockchain technology for trade community_. [https://www.adports.ae/abu-dhabi-ports-launches-blockchain-technology-for-trade-community/](https://www.adports.ae/abu-dhabi-ports-launches-blockchain-technology-for-trade-community/)

Azad, M. A., et al. (2024). Verify and trust: A multidimensional survey of zero-trust. _Journal of Information Security and Applications, 82_, 103791.

BIMCO, CLIA, ICS, INTERCARGO, INTERTANKO, OCIMF, & IUMI. (2024). _The guidelines on cyber security onboard ships_ (5th ed.). BIMCO.

Cyble. (2025). _Hacktivists, nation-state hackers target global maritime infrastructure as cyberattacks, GPS spoofing surge_.

EEAS, European External Action Service. (2025). _EU maritime security exercise strengthens protection of critical maritime infrastructure_.

Farah, M. B., Iris, Ç., Hassani, H., & Pazienza, P. (2024). A survey on blockchain technology in the maritime industry. _Future Generation Computer Systems, 157_, 618–637.

Hopcraft, T., Oruc, B., & Kapalidis, E. (2024). Comprehensive analysis of maritime cybersecurity landscape—The role of frameworks and risk assessment. _Journal of Marine Science and Engineering, 12_(5), 919.

IASME. (2025). _Overcoming Threats and Building Resilience: A Maritime Cyber Risk Strategy_.

Indian Register of Shipping. (2024). _Guidelines on Maritime Cyber Safety_ (Revision 1).

International Maritime Organization. (2022). _Maritime cyber risk management in safety management systems_ (IMO Resolution MSC.428(98)). IMO.

Irannezhad, E. (2020). The architectural design requirements of a blockchain-based port community system. _Logistics, 4_(4), 30.

Jahan, T., Islam, M. S., & Rahman, R. (2024). Mitigating maritime cybersecurity risks using AI-based intrusion detection systems and network automation during extreme environmental conditions. _International Journal of Scientific Research in Multidisciplinary Techniques, 3_(10), Article 73.

Li, M., Zhou, J., Chattopadhyay, S., & Goh, M. (2024). Maritime cybersecurity: A comprehensive review. _arXiv preprint arXiv:2409.11417_.

Liebetrau, T. (2023). Critical maritime infrastructure protection: What’s the trouble? _Marine Policy, 155_, 105772.

Liu, J., Chen, X., Wang, Y., & Lam, J. S. L. (2023). Blockchain technology in maritime supply chains. _International Journal of Production Research, 61_(11), 3543–3559.

MARSEC-COE, Maritime Security Centre of Excellence. (2023). _Maritime Critical Infrastructure Protection (MCIP)_.

Maritime industry accelerates shift toward digital trade. (2025, January 30). _Offshore Energy_.

Melnyk, O., Drozdov, O., & Kuznichenko, S. (2025). Cybersecurity in maritime transport: An international perspective on regulatory frameworks and countermeasures. _Lex Portus, 11_(1), 7–19.

O’Dwyer, G. (2023). _Maritime Cyber Attack Database (MCAD)_.

PRECINCT Project. (2024). _The PRECINCT Ecosystem Platform for Critical Infrastructure Protection_.

Rødseth, H., Nesheim, H. I., & Stenumgård, P. (2022). Security and independence of process safety and control systems in offshore facilities. _Journal of Cybersecurity and Privacy, 2_(1), 1–38.

Rose, S., Borchert, O., Mitchell, S., & Connelly, S. (2020). _Zero Trust Architecture_ (NIST SP 800-207). National Institute of Standards and Technology.

Sahay, R., Sepulveda Estay, D. A., Meng, W., Jensen, C. D., & Barfod, M. B. (2022). A comparative risk analysis on CyberShip system with STPA-Sec, STRIDE and CORAS frameworks. _arXiv preprint arXiv:2212.10830_.

Stouffer, K., Pillitteri, V., Lightman, S., Abrams, M., & Hahn, A. (2023). _Guide to operational technology (OT) security_ (NIST Special Publication 800-82r3). National Institute of Standards and Technology.

Surucu-Balci, E., Iris, Ç., & Balci, G. (2024). Digital information in maritime supply chains with blockchain and cloud platforms: Supply chain capabilities, barriers, and research opportunities. _Technological Forecasting and Social Change, 198_, 122978.

US Coast Guard. (2024). _Cyber Trends and Insights in the Marine Environment (CTIME Report)_.

Vaarandi, R., Tsiopoulos, L., Visky, G., Rehman, M. U., & Bahsi, H. (2025). Literature review: Cyber security monitoring in maritime. _arXiv_.
