jimzord12/ai-fire-detection-arduino-system/thesis/typst/chapters/07_implementation_testing/sections/7_2_methodology/sections/6_2_rationale_for_three_class_classification/glossary.md

**Binary Classification**: A type of classification task where there are only two possible classes or outcomes.
**Multi-class Classification**: A classification task with more than two classes.
**Nuisance Event**: An environmental event that may trigger a sensor but does not represent a genuine hazard, such as cooking steam or cigarette smoke.
**PLS-DA (Partial Least Squares Discriminant Analysis)**: A statistical method used for find a linear regression model by projecting the predicted variables and the observable variables to a new space.
**Specificity**: The ability of a test to correctly identify those without the condition (true negative rate).
**Sensitivity**: The ability of a test to correctly identify those with the condition (true positive rate).
