jimzord12/ai-fire-detection-arduino-system/thesis/typst/chapters/07_implementation_testing/sections/7_3_implementation/sections/7_7_quantization_strategy/content_ieee_no_glossary.md

The deployment of trained neural networks on resource-constrained microcontrollers demands a reduction in model size and computational overhead without sacrificing classification accuracy. Model quantization addresses this challenge by converting the high-precision 32-bit floating-point (Float32) weight representations produced during training into lower-precision integer formats, most commonly 8-bit integers (Int8), before embedding the model into device firmware. This section examines the rationale for choosing Int8 post-training quantization (PTQ) in the present system, characterizes the trade-offs between Float32 and Int8 precision, and describes how quantization interacts with the deployment pipeline.

## Float32 vs. Int8: Precision, Memory, and Latency Trade-offs

Neural network weights trained under standard conditions are encoded in 32-bit single-precision floating-point format, which provides a wide dynamic range more than sufficient to represent the gradients and activations encountered during optimization @novac2021quantization. At inference time on a general-purpose Cortex-M4 microcontroller, however, this precision is unnecessary and expensive. The target core contains a hardware floating-point unit (FPU), but the resulting model consumes four bytes per weight parameter and stresses the limited memory budgets.

Int8 quantization maps each Float32 weight and activation to a signed 8-bit integer using a linear scale factor and zero-point offset, reducing the per-parameter storage cost from 4 bytes to 1 byte — a 4x reduction in model footprint @novac2021quantization. Beyond storage, replacing floating-point arithmetic with integer arithmetic carries significant latency benefits: on ARM Cortex-M4 cores that implement SIMD instructions, specialized libraries enable packing two 16-bit multiply-accumulate operations into a single 32-bit cycle, substantially accelerating layer-wise computation @novac2021quantization. Empirical benchmarks on embedded deployments report throughput improvements of 3.3x to 4x for Int8 models over Float32 equivalents @amara2023performance.

The principal cost of Int8 quantization is a potential accuracy degradation arising from quantization error. Because the full floating-point dynamic range must be compressed into 256 discrete integer levels, subtle differences between closely spaced weight values may collapse to the same integer bucket, introducing rounding noise @novac2021quantization. In practice, however, this degradation is modest: published literature consistently reports that post-training quantization to Int8 incurs an accuracy loss of approximately 0.1%–2% relative to the Float32 baseline @lamaakal2025comprehensive. For the three-class fire detection classifier developed in this project, the accuracy gap is expected to remain within this acceptable margin.

## Post-Training Quantization via Edge Impulse

The quantization strategy adopted in this project is post-training quantization (PTQ), in which the model is trained to full convergence using Float32 arithmetic and then quantized offline before deployment. PTQ is computationally inexpensive and requires no modification to the training procedure; calibration of the scale factors uses the existing training dataset @novac2021quantization. This approach contrasts with quantization-aware training (QAT), which requires more complex training workflows.

Within the Edge Impulse platform, the trained model is exported to TensorFlow Lite format and quantized using Int8 PTQ, which applies per-tensor asymmetric quantization to activations and per-layer symmetric quantization to weights. The resulting model is further compiled by the EON Compiler, which statically resolves the computation graph, eliminating runtime interpreter overhead and further reducing RAM usage @lamaakal2025comprehensive.

An Int8 TinyML fire detection model deployed under a comparable workflow achieved a validation accuracy reduction of only 1.36 percentage points after quantization, confirming the viability of Int8 deployment for safety-relevant classification tasks on microcontrollers @kapalamula2025edge. For the present system, Int8 is the default deployment format because it enables the model to reside comfortably within Flash and permits faster inference, while Float32 is retained as a reference baseline for validation.
