jimzord12/ai-fire-detection-arduino-system/thesis/typst/chapters/07_implementation_testing/sections/7_3_implementation/sections/7_7_quantization_strategy/glossary.md

**Post-Training Quantization (PTQ)**: A technique to convert a pre-trained floating-point model to a quantized model with minimal accuracy loss and without retraining.
**Quantization-Aware Training (QAT)**: A method where the model is trained with quantization effects in the loop to improve accuracy in low-precision deployments.
**INT8**: An 8-bit signed integer format.
**EON Compiler**: Edge Impulse's deep learning compiler that optimizes models for low-power microcontrollers.
**SIMD (Single Instruction, Multiple Data)**: A type of parallel processing that allows one instruction to be applied to multiple data points simultaneously.
