jimzord12/ai-fire-detection-arduino-system/.gemini/v1/cli-tools/image-gen-ts/test/test-output-001.png

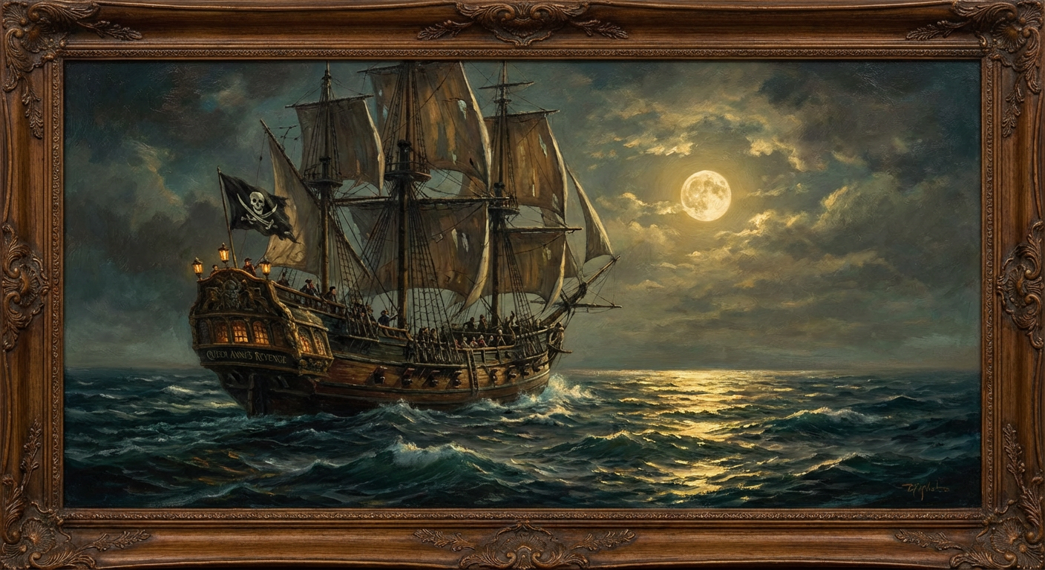
.gemini/v1/cli-tools/image-gen-ts/test/test-output-001.png
