jimzord12/ai-fire-detection-arduino-system/thesis/typst/assets/figures/edge-impulse/007-platform-model-testing.png

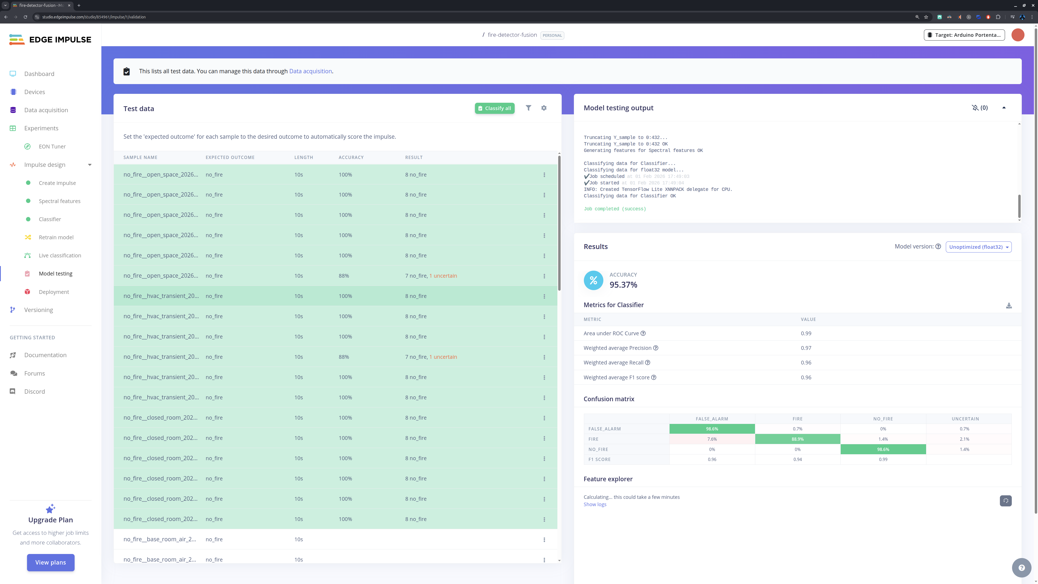
thesis/typst/assets/figures/edge-impulse/007-platform-model-testing.png
