jimzord12/ai-fire-detection-arduino-system/TODO.md

# TODO

## Thesis Placeholders

- [ ] **`thesis/typst/main.typ:77`** — Replace `[GITHUB_REPO_LINK_FIRMWARE]` with actual firmware repo URL.
- [ ] **`thesis/typst/main.typ:78`** — Replace `[GITHUB_REPO_LINK_DATA]` with actual dataset repo URL.
- [ ] **`thesis/typst/chapters/12_user_manual/sections/12_3_maintenance/content.typ:20`** — Replace `[GITHUB_REPO_LINK]` with actual GitHub repo URL.
