jimzord12/ai-fire-detection-arduino-system/(commit log)

2025-12-12 docs: add project overview and setup instructions to README
    - Add project description for AI fire detection system
    - Add Arduino IDE installation steps
    - Add library installation requirements
2025-12-12 feat(logger): add Python serial data logger
    - Add Python 3.13 configuration
    - Add pyserial and ruff dependencies
    - Implement CSV logger for VOC sensor data
    - Configure COM5 serial port at 9600 baud
2025-12-12 data: add VOC sensor experimental datasets
    - Add closed room baseline (no fire source)
    - Add closed room with extinguished candles
    - Add lighter gas exposure test
    - Add open room baseline measurements
    [blowed-5-tealights-.csv, blowing_lighter_gas_on_sensor.csv, no-fire-source.csv, voc_data.csv]
2025-12-12 feat(examples): add individual sensor test sketches
    - Add flame sensor example with LED feedback
    - Add smoke sensor analog reading example
    - Add VOC sensor with CSV output
    - Add AHT20 temperature/humidity sensor example
2025-12-12 feat(system): initialize modular fire detection system
    - Add main system with sensor type enumeration
    - Define sensor configuration struct
    - Configure VOC, Smoke, CO, and AHT20 sensors
    - Create placeholder modules for alarm logic, sensors, and outputs
2025-12-12 feat(helpers): add LED control utility function
2025-12-14 Update logger and Arduino sketches with refinements
    [voc_data.csv]
2025-12-14 Remove deprecated VOC experimental data directories
    [blowed-5-tealights-.csv, blowing_lighter_gas_on_sensor.csv, no-fire-source.csv]
2025-12-14 Add CO sensor experimental data and documentation
    [9-tealights.csv, human-exhaling-over-it.csv, no-fire-source.csv]
2025-12-14 Add flame sensor experimental data and documentation
    [10cm.csv, 20cm.csv, 3cm.csv]
2025-12-14 Add smoke sensor experimental data and documentation
    [above-smoke-source.csv, small-room-no-smoke.csv, small-room-with-smoke.csv]
2025-12-14 Add VOC sensor data: closed room after long warmup
    [arcohol-1cm-away.csv, arcohol-20cm-away.csv, no-alcochol-source.csv]
2025-12-14 Add VOC sensor data: open room after long warmup (with active blowing test)
    [arcohol-1cm-away-and-blowing.csv, arcohol-20cm-away.csv, no-alcochol-source.csv]
2025-12-14 Add VOC sensor baseline data before long warmup period
    [blowed-5-tealights-.csv, blowing_lighter_gas_on_sensor.csv, no-fire-source.csv]
2025-12-14 Add VOC sensor experiment documentation and project strategy notes
2026-01-11 Add thesis ideas for Fire Detector using Sensor Fusion with TinyML on Arduino UNO R4 WiFi
    - Outline the theoretical and practical components of the thesis
    - Include detailed sections on sensor integration, data collection strategies, and calibration procedures
    - Discuss TinyML model design, training strategies, and implementation challenges
    - Provide insights on testing methodologies, performance metrics, and future research directions
2026-01-11 Add new VOC data files and improve data collection scripts
    - Introduced new CSV files for VOC measurements in various scenarios:
    - `blowed-5-tealights-.csv`: Data from a closed small room with 5 tealights.
    - `blowing_lighter_gas_on_sensor.csv`: Data from blowing lighter gas on the sensor.
    - `no-fire-source.csv`: Data from a closed small room without any fire source.
    - `no-fire-source.csv`: Data from an opened small room without any fire source.
    - Created documentation for the VOC experiment and notes on sensor behavior and data collection strategies.
    - Enhanced the automated data collection script to improve directory handling and output organization.
    [10cm.csv, 20cm.csv, 3cm.csv, 9-tealights.csv, above-smoke-source.csv, arcohol-1cm-away-and-blowing.csv, arcohol-1cm-away.csv, arcohol-20cm-away.csv]
2026-01-11 Refine data collection strategy for multi-sensor fire detection system, enhancing clarity and detail in protocol and scenarios
2026-01-18 Add experimental documentation and scripts for VOC sensor data collection
    - Created `experiment.md` to outline VOC testing scenarios in controlled environments.
    - Added `notes.md` detailing observations and sensor behavior during VOC experiments.
    - Introduced a `README.md` in the scripts directory to describe available utility scripts.
    - Developed `automated_data_collection.sh` for automated sensor data logging and CSV formatting.
    - Implemented environment check scripts for Edge Impulse setup on Linux/macOS and Windows.
    - Added `connect-arduino.ps1` to facilitate Arduino connection to WSL2.
    - Created upload script for Edge Impulse to streamline data uploads.
    - Drafted thesis outline and writ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
    [10cm.csv, 20cm.csv, 3cm.csv, 9-tealights.csv, above-smoke-source.csv, arcohol-1cm-away-and-blowing.csv, arcohol-1cm-away.csv, arcohol-20cm-away.csv]
2026-01-25 Add troubleshooting guide for Arduino IDE 2 on Ubuntu 24.04
    Document troubleshooting steps for Arduino IDE 2 on Ubuntu 24.04, including FUSE compatibility and serial port permissions.
2026-01-25 Revise Arduino IDE 2 troubleshooting for Ubuntu 24.04
    Updated troubleshooting steps for Arduino IDE 2 on Ubuntu 24.04, including installation instructions for FUSE compatibility and sandbox workaround.
2026-01-25 feat: complete repository redesign and restructuring
    [10cm.csv, 20cm.csv, 3cm.csv, 9-tealights.csv, above-smoke-source.csv, arcohol-1cm-away-and-blowing.csv, arcohol-1cm-away.csv, arcohol-20cm-away.csv]
2026-01-25 feat: add troubleshooting guides for Arduino IDE 2 on Ubuntu 24.04 and WSL2 setup
2026-01-25 fix: adjust analog sensor value range for better accuracy
    [verify_all_sensors_operational.ino]
2026-01-25 fix: standardize CSV column order between firmware and collection script
    Fixed critical data integrity issue where firmware output column order
    did not match the data collection script header. Swapped VOC and Flame
    columns to ensure consistent data format across the pipeline.
    New column order: timestamp,smoke,voc,co,flame,temperature,humidity
    Related files:
    - firmware/main/fire-detection-main/fire-detection-main.ino
    - tools/collection/automated_data_collection.sh
    [fire-detection-main.ino]
2026-01-25 refactor: split data collection strategy into modular documentation
    Reorganized data collection documentation from monolithic strategy.md
    into focused, navigable modules under docs/research/data-collection/.
    New structure:
    - README.md: Executive summary and navigation
    - fire.md: Fire detection scenarios
    - no_fire.md: Baseline/no-fire scenarios
    - false_alarm.md: False alarm protocols
    - procedure.md: Data collection procedures
    - checklist.md: Data collection checklist
    - sampling-and-format.md: Sampling parameters and CSV format
    - scripts.md: Script documentation
    - storage-and-validation.md: Data storage and validation
    - appendix.md: Additional reference material
    - _archive_strategy.md: Archiv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
2026-01-25 refactor: update data collection guide and scripts for sensor configuration and logging format
2026-01-25 Add new CSV files for no fire open space data collected on January 25, 2026
    - Added no_fire__open_space_20260125_202952_27.csv with 99 data entries
    - Added no_fire__open_space_20260125_203004_28.csv with 99 data entries
    - Added no_fire__open_space_20260125_203016_29.csv with 100 data entries
    - Added no_fire__open_space_20260125_203028_30.csv with 100 data entries
    [fire__close_low_vent_20260125_212033_1.csv, fire__close_low_vent_20260125_212045_2.csv, fire__close_low_vent_20260125_212057_3.csv, fire__close_low_vent_20260125_212109_4.csv, fire__close_low_vent_20260125_212121_5.csv, fire__close_low_vent_20260125_212133_6.csv, fire__close_low_vent_20260125_212145_7.csv, fire__close_low_vent_20260125_212157_8.csv]
2026-01-25 refactor: add analysis task for Python Data Analysis tools and document CO sensor issues
2026-01-25 docs: add notes for CO sensor soldering issues and C2 scenario sensor exposure
2026-01-25 Add new sensor data files for false alarm detection on Steam
    - Added false_alarm__steam_20260125_221632_26.csv containing 100 rows of sensor readings.
    - Added false_alarm__steam_20260125_221644_27.csv containing 99 rows of sensor readings.
    - Added false_alarm__steam_20260125_221656_28.csv containing 99 rows of sensor readings.
    - Added false_alarm__steam_20260125_221708_29.csv containing 100 rows of sensor readings.
    - Added false_alarm__steam_20260125_221720_30.csv containing 100 rows of sensor readings.
    [false_alarm__cooking_20260125_222423_1.csv, false_alarm__cooking_20260125_222435_2.csv, false_alarm__cooking_20260125_222447_3.csv, false_alarm__cooking_20260125_222459_4.csv, false_alarm__cooking_20260125_222511_5.csv, false_alarm__cooking_20260125_222523_6.csv, false_alarm__cooking_20260125_222535_7.csv, false_alarm__cooking_20260125_222547_8.csv]
2026-01-25 Add new VOC sensor data files for various conditions
    - Added a dataset for VOC measurements in an open small room without alcohol source after a long warmup.
    - Included VOC data from a closed small room after blowing out 5 tealights.
    - Introduced a dataset for VOC levels while blowing lighter gas on the sensor in a closed small room.
    - Added VOC measurements in a closed small room without any fire source.
    - Included VOC data from an opened small room without any fire source.
    [10cm.csv, 20cm.csv, 3cm.csv, 9-tealights.csv, above-smoke-source.csv, arcohol-1cm-away-and-blowing.csv, arcohol-1cm-away.csv, arcohol-20cm-away.csv]
2026-01-25 Add multiple CSV files for false alarm spray data collected on 2026-01-25
    - Added false_alarm__spray_20260125_233034_5.csv with 101 records of sensor data.
    - Added false_alarm__spray_20260125_233034_6.csv with 101 records of sensor data.
    - Added false_alarm__spray_20260125_233034_7.csv with 101 records of sensor data.
    - Added false_alarm__spray_20260125_233034_8.csv with 101 records of sensor data.
    - Added false_alarm__spray_20260125_233034_9.csv with 101 records of sensor data.
    [false_alarm__spray_20260125_233034_1.csv, false_alarm__spray_20260125_233034_10.csv, false_alarm__spray_20260125_233034_11.csv, false_alarm__spray_20260125_233034_12.csv, false_alarm__spray_20260125_233034_13.csv, false_alarm__spray_20260125_233034_14.csv, false_alarm__spray_20260125_233034_15.csv, false_alarm__spray_20260125_233034_16.csv]
2026-01-25 Add VOC sensor data and experiment documentation
    - Introduced new CSV files containing VOC sensor readings for various scenarios:
    - `no-alcochol-source.csv` for open small room after long warmup
    - `blowed-5-tealights-.csv` for closed small room before long warmup
    - `blowing_lighter_gas_on_sensor.csv` for closed small room before long warmup
    - `no-fire-source.csv` for closed small room before long warmup
    - `no-fire-source.csv` for opened small room before long warmup
    - Added experiment documentation in `experiment.md` detailing the setup and scenarios tested.
    - Included notes in `notes.md` regarding sensor behavior and observations during the experiments.
    [10cm.csv, 20cm.csv, 3cm.csv, 9-tealights.csv, above-smoke-source.csv, arcohol-1cm-away-and-blowing.csv, arcohol-1cm-away.csv, arcohol-20cm-away.csv]
2026-02-01 Refactor data collection strategy and enhance documentation
    - Deleted the consolidated data collection strategy document and split its content into smaller, more focused documents under `docs/research/data-collection/`.
    - Added a new `fire-detection-main.md` file detailing the Arduino fire detection system implementation.
    - Updated the data collection guide to include additional scenarios for baseline conditions and refined existing scenario descriptions.
    - Revised the `no_fire.md` file to reflect the new scenario structure and added detailed expectations for each scenario.
    - Introduced a new TypeScript script to generate synthetic spray data for testing false alarm scenarios.
2026-02-01 Add new false alarm spray data files for February 1, 2026
    - Added 10 new CSV files containing sensor data for false alarm spray events.
    - Each file includes timestamp, smoke, VOC, CO, flame, temperature, and humidity readings.
    - Data spans various time intervals throughout the day, providing comprehensive coverage for analysis.
    [10cm.csv, 20cm.csv, 3cm.csv, 9-tealights.csv, above-smoke-source.csv, arcohol-1cm-away-and-blowing.csv, arcohol-1cm-away.csv, arcohol-20cm-away.csv]
2026-02-01 docs: add guide for creating TinyML model with Edge Impulse and sensor fusion
2026-02-01 chore: update CSV files with new data and add Edge Impulse images
    [no_fire__base_room_air_20260118_201233_2.csv, no_fire__base_room_air_20260118_201246_3.csv, no_fire__base_room_air_20260118_201258_4.csv, no_fire__base_room_air_20260118_201310_5.csv, no_fire__base_room_air_20260118_201322_6.csv, no_fire__base_room_air_20260118_201334_7.csv, no_fire__base_room_air_20260118_201347_8.csv, no_fire__base_room_air_20260118_201359_9.csv]
2026-02-01 Add comprehensive guides and scripts for Edge Impulse integration and fire detection system
    - Created detailed guides for creating an impulse, generating spectral features, and training classifiers in Edge Impulse.
    - Added model testing and deployment instructions for Arduino, including library build steps.
    - Implemented a robust fire detection system with integrated diagnostics in Arduino firmware.
    - Introduced a bash script to automate the upload of multiple CSV files to Edge Impulse.
    - Enhanced the main fire detection code with hybrid logic for improved accuracy and safety.
    - Added future plans for system enhancements and integrated additional sensor capabilities.
    - Included images and do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
2026-02-08 Add detailed data analysis report for AI Fire Detection System
    - Introduced a comprehensive report analyzing sensor data collected from the AI Fire Detection Arduino System.
    - Documented methodology, dataset characteristics, statistical analysis, insights, model evaluation, and implications for TinyML deployment.
    - Included visual aids such as class distribution, sensor correlation, boxplots, confusion matrix, and feature importance rankings to support findings.
    - Highlighted critical insights regarding false alarms, sensor redundancy, and model performance metrics.
    [10cm.csv, 20cm.csv, 3cm.csv, 9-tealights.csv, above-smoke-source.csv, aggregated_data.csv, arcohol-1cm-away-and-blowing.csv, arcohol-1cm-away.csv]
2026-02-08 Refactor code structure for improved readability and maintainability
    [aggregated_data.csv]
2026-02-15 Add comprehensive documentation and utilities for Typst thesis setup
    - Introduced INSTALLATION_GUIDE.md for detailed Typst installation instructions on Ubuntu 24.04.
    - Created TUM-TEMPLATE-GUIDE.md to guide users in setting up and customizing the ls1intum Typst thesis template.
    - Added BIBLIOGRAPHY.md to explain bibliography management using Hayagriva format.
    - Developed FIGURES.md for best practices in handling figures within Typst documents.
    - Established SETTINGS_AND_METADATA.md for core configuration philosophy and metadata management.
    - Compiled TABLES.md to provide guidelines for creating and formatting tables in Typst.
    - Documented WORKFLOW_AND_STRUCTURE.md outlining the thesis file s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
    [extraction_table.csv, screening_log.csv]
2026-02-17 FEAT: Apply robotic framing and modularize references in 1.1 Background
    - Updated 'content.typ' in 01_introduction/sections/1_1_background to align with 'Robotic Framing' guidelines.
    - Replaced general terms with 'legacy systems', '_Autonomous Sensing Nodes_', and emphasized 'Asymmetric Multi-Processing' for Arduino UNO R4 WiFi.
    - Created 'references.bib' in the same section directory and moved all local citations into it, adhering to the modular workflow.
    - Removed citation markers from 'content.typ'.
2026-02-17 feat(cli-tools): Add consolidated CLI tools for thesis processing
    - Create package.json for managing dependencies and scripts for thesis-related CLI tools.
    - Implement scripts for installation, cleaning, linting, and formatting.
    feat(bib-update): Add PowerShell scripts for updating bibliography entries
    - Implement update_bib.ps1 to replace an old article entry with a new one.
    - Implement update_bib_khan.ps1 for updating a specific Khan article entry.
    - Implement update_bib_perez.ps1 to replace an old entry with a new book reference.
    feat(section-update): Add script to update section content in markdown and Typst files
    - Implement update_section.ps1 to insert an introduction into the spec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
2026-02-17 Add research queries and literature on fire detection systems
    - Introduced research queries for problem statement and research questions, focusing on fire detection failures, sensor fusion efficacy, and classification models.
    - Added sections detailing the evolution of fire detection technology, machine learning applications, and principles of sensor fusion.
    - Included discussions on ethical and safety aspects of AI in life-critical systems, emphasizing explainable AI and data privacy.
    - Updated references in APA 7th Edition format across new sections.
2026-02-18 Add new chapters and sections for sensor selection, hardware integration, data collection methodology, implementation, experimental results, discussion, and conclusion
    - Created sections for detailed examination of selected sensors, justification of sensor choice, and sensor calibration protocols.
    - Added chapters for hardware platform and system integration, including subsections on architecture, power management, physical design, connectivity, and schematics.
    - Established data collection methodology with sections on safety protocols, rationale for classification, sampling parameters, and dataset organization.
    - Implemented sections for Edge Impulse project setup, DSP blocks, model archite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
2026-02-19 Add sections on power management, physical design, connectivity, and safety protocols for fire detection node
    - Introduced section 5.2 on power management and thermal considerations, detailing the role of MEMS gas sensors and their heating elements.
    - Added section 5.3 covering physical design and enclosure, emphasizing airflow considerations and thermal isolation strategies.
    - Created section 5.4 outlining connectivity and location awareness, focusing on MQTT telemetry and static location tagging.
    - Established section 6.1 detailing safety protocols during data collection, including hazard assessment, fire containment measures, ventilation requirements, and PPE usage.
    - Removed obsolete cha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
2026-03-02 Refactor citations and update references across multiple sections for consistency and accuracy.
    - Updated references in the literature review on fire detection and MEMS technology.
    - Revised citations in the sensor fusion and TinyML section to reflect recent studies.
    - Corrected references in the physics and operating principles section regarding IR flame detection.
    - Adjusted citations in the characteristics of MEMS sensors section for accuracy.
    - Updated references in the principles of sensor fusion section to include recent findings.
    - Revised neural network fundamentals section to reflect updated citations.
    - Corrected model quantization optimization section references for consistency.
    -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
2026-03-05 Add supervisor information to thesis and create bibliography sync script
    - Updated the main.typ file to include supervisor details for the thesis.
    - Added a new PowerShell script (sync-bib.ps1) to consolidate and deduplicate section-level bibliography files into a global bibliography.
2026-03-07 Add hybrid logic flow diagram and validation of clean fire detection case study
    - Introduced a new diagram for the hybrid logic flow in fire detection systems.
    - Added a section on the validation of clean fire detection using a butane lighter, detailing the AI's performance and the effectiveness of the hybrid logic in mitigating false negatives.
    - Created a comparative analysis section against baseline approaches, highlighting the advantages of multi-sensor fusion over single-modality systems.
    - Included references and glossary terms relevant to the comparative analysis.
    [only-flame-5cm-distance.csv]
2026-03-09 Add future work section, references, appendices, installation manual, and user manual
    - Created a new section on future work in the conclusions chapter, detailing remote model management, long-range protocols, and cooperative sensing strategies.
    - Added references for cited works in the future work section.
    - Established appendices including technical schematics, raw data samples, and model architecture details.
    - Developed an installation manual outlining hardware requirements, assembly procedures, and configuration steps.
    - Compiled a user manual covering system operation, data collection guidelines, and maintenance troubleshooting.
2026-05-24 Refactor sensor handling and logging; introduce SensorSnapshot struct for improved data management
